gonzalocrs/Amor_Mundi/polyframe2/friend-20-feet-round-dome-lowstart-crown3m-opentop.png

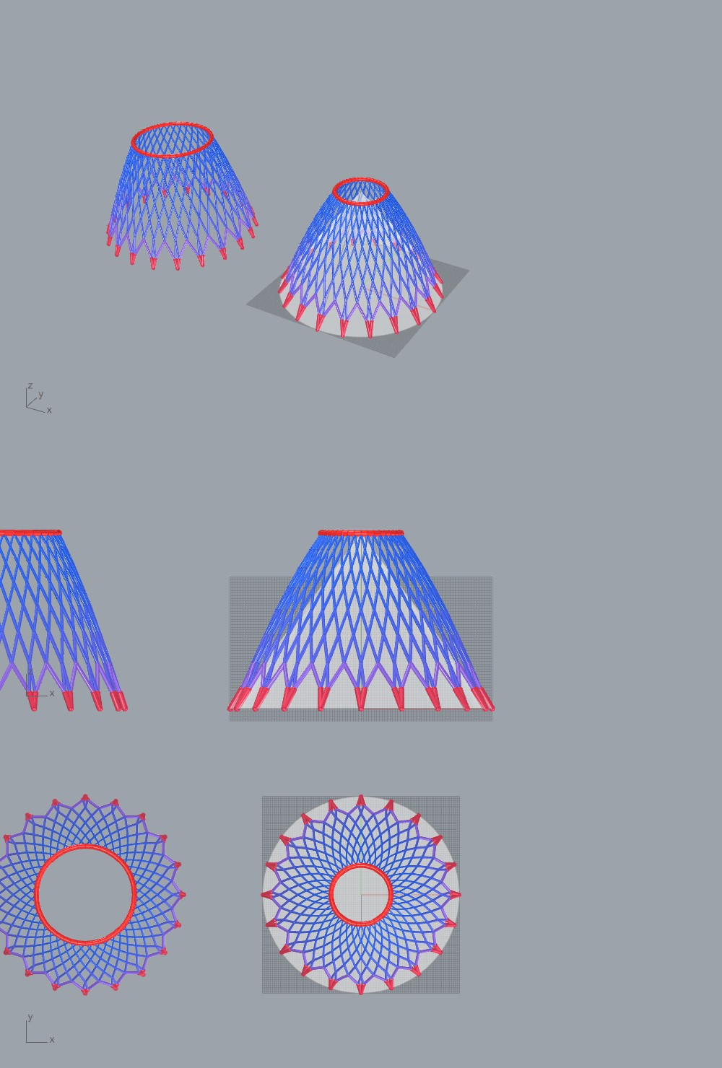
polyframe2/friend-20-feet-round-dome-lowstart-crown3m-opentop.png
