gonzalocrs/Amor_Mundi/details/set/02_2026-10-14_30mm-beads/06-roof-plan-cut-grid-A.pdf

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
al c

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
f, lo

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
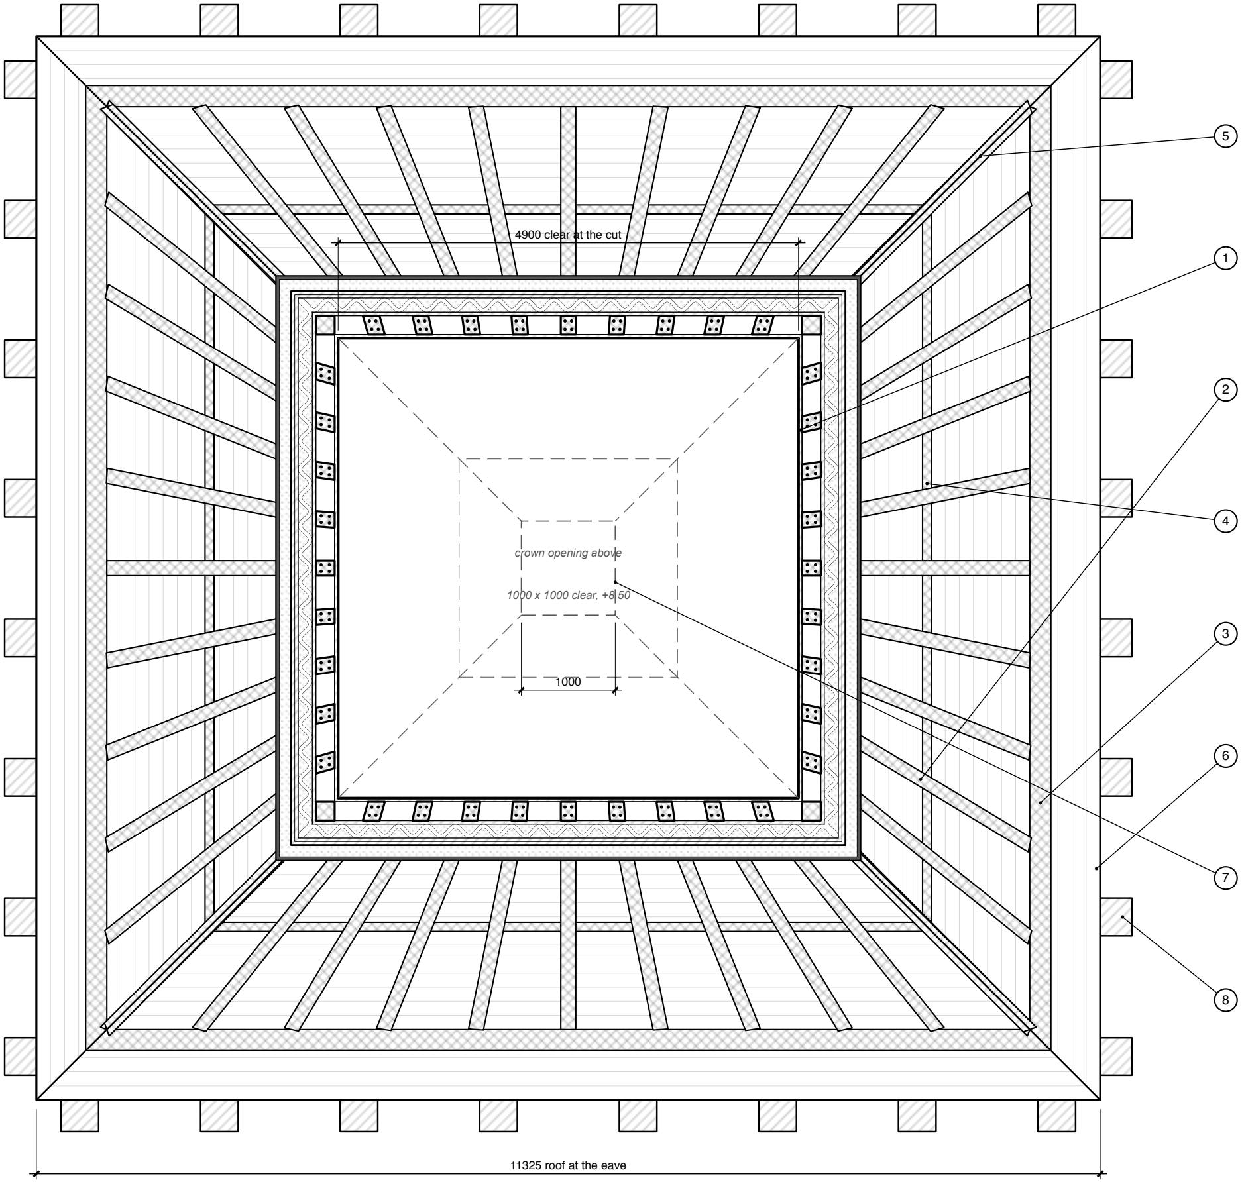
[picture p11: figure]
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
e, j

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
al rib

a

t

+

6.0

2

), r

o

o

m

sid

e

o

u

t: in

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
0, rib

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
h; e

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
), mid

dle

b

e

a

d

3

0, lattice zone 120 (wavy bead + insulation, dotted), 2 outer beads 30, insulation 100 and outer layer 30. 2 | Ribs of grid A seen below the cut: all 11 columns per face run from the base ring at the eave up to the cut (every other one stops at +6.02, just above it). 3 | Base ring: the 300 solid base at the eave (+2.50 to +2.80). 4 | Horizontal rib of grid A at +4.26 (the next ones, at +6.02 and +7.68, are above the cut). 5 | Hips: ribs from the corners of the eave up to the cut; dashed above it, up to the crown opening. 6 | Roof edge at the eave (outside of the 30 outer layer). Very faint squares = printed layer joints (real layers 10, drawn every 200 in height). 7 | Above the cut (removed, dashed): hips and the crow

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
0, 1

0

0

0

cle

a

r in

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
xis, 2

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
r la

y

e

r

). 8 Buttresses below the roof: their end s

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
e; t

h

e

w

all u

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
f is

d

a

s

h

e

d. Notes Matches the roof-grid elevations: same rib geometry, s

a

m

e levels (+4.26, +6.02, +7.68 for the horizontal ribs of grid A). The ribs lie in the rib zone of the shell, between the inner and the middle bead; here they are drawn as if the middle bead, the lattice zone, the outer beads, insulation and cladding were transparent. 0 | 1 | 2 | 3

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
3 · dim

e

n

sio

n

s in

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
4 · h

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
s, n

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
