gonzalocrs/Amor_Mundi/details/set/02_2026-10-14_30mm-beads/10-detail-D1-eave.pdf

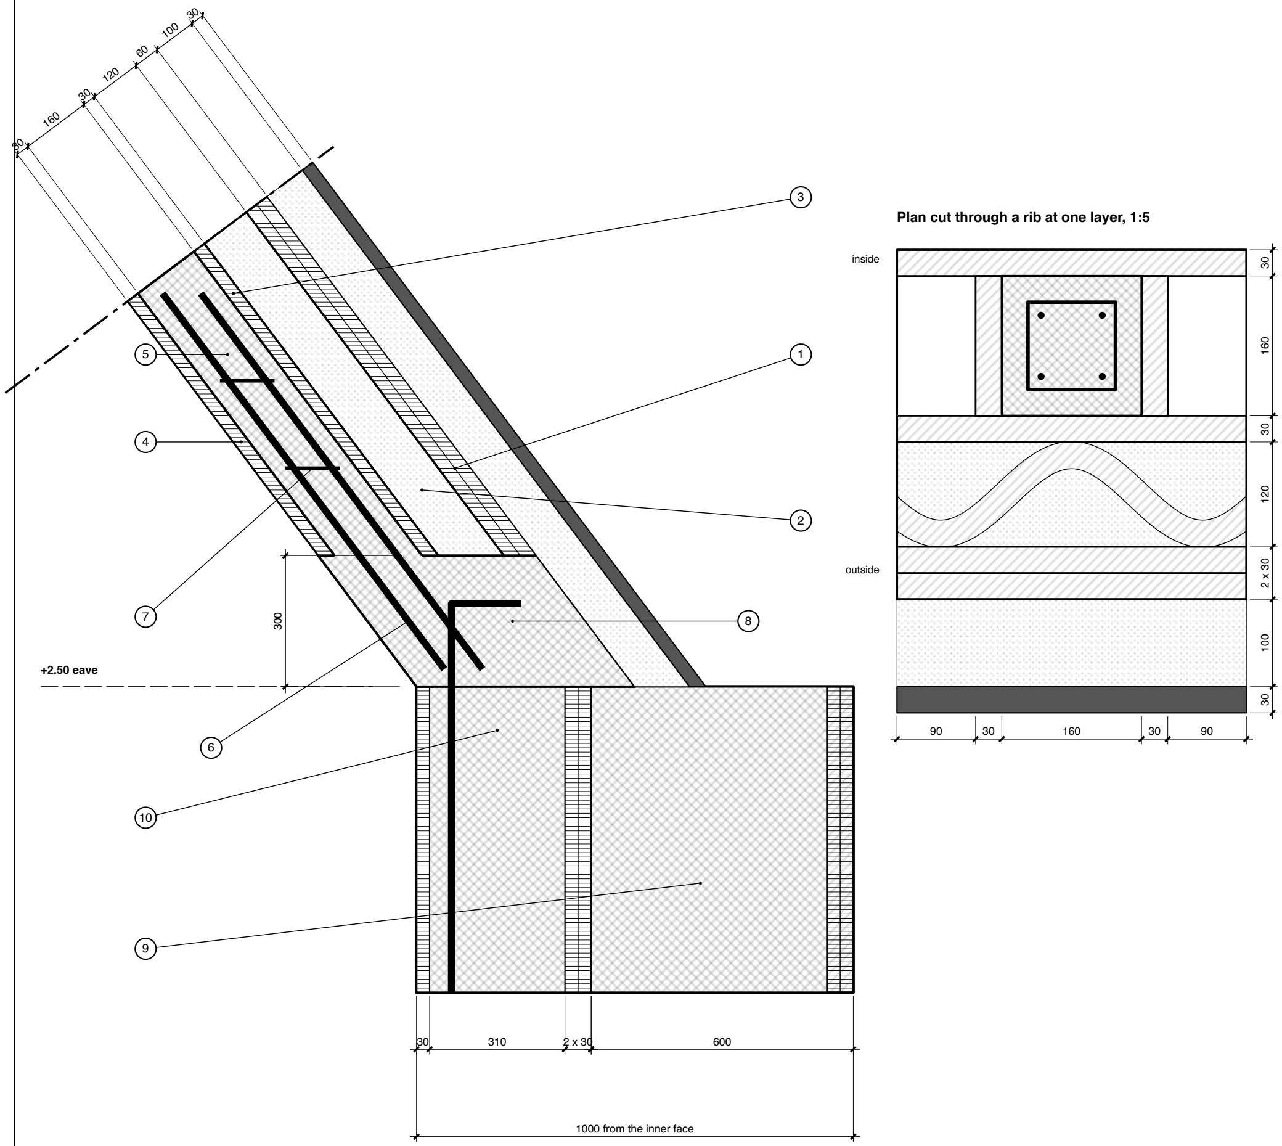
[picture p15: figure]
sid; e inside

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
0, t

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
e; outside them the insulation 100 (dotted) and the outer layer 30 (dark). 2 Lattice zone 120: a wavy printed bead 30 that touches the middle bead and the outer beads in tu

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
0, a

s

s

u

m

e

d

), in

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
n it

s loops (dotted). 3 | Middle bead 30: closes the rib zone on the outside. Inner and middle bead are the two structural skins of the roof, the ribs the webs between them (as in the Karamba model). 4 | Inner bead 30, room side: continuous, it covers the ribs. The roof is 400 thick square to the slope from eave to crown. 5 | Rib (cast column) 160 wide x 160 deep: fills the rib zone between the inner and the middle bead, inside two printed channel walls of 30 (see the plan cut), filled with poured concrete; section cut along the rib. It rises out of the solid base in the same pour, without a joint. Between the ribs the rib zone is an empty cavity. 6 | Rib bars R, 4 Ø16 (2 in the cut), anchored in the solid base where they cross the hooks of the wall bars A (assumed; steel fibre in the concrete could replace them). 7 | Stirrups Ø8 every 200 (assumed). 8 | Solid base of the roof: the first 300 (vertical) above the eave is full cast concrete over the whole 400, no cavity or lattice, poured in one go with the rib above it; wall bars A hook into it. Replaces the ring beam. 9 | Buttress 400 wide, 1000 from the inner face (600 beyond the wall): printed formwork (60 end cap of 2 beads shown) filled with cast concrete; top flush with the roof base at +2.50. 10 Wall 400 at the buttress: printed inner bead 30 and 2 outer beads 30, the 310 zone between them cast a

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
o in

s

ula

tio

n

h

e

r

e, t

h

e
c

u

t is

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
s; b

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
e is

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
+ in

s

ula

tio

n

). W

all b

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
n in

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
p in

t

o

t

h

e
s

olid

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
d in

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
). T

h

e

r

o

o

f
g

rid is

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
); t

h

e
d

e

t

ail is

c

u

t

alo

n

g

a

rib. 0 | 1 | 2 | 3

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
3 · rib

pla

n

c

u

t

1:5 · dim

e

n

sio

n

s in

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
4 · h

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
s, n

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
