gonzalocrs/Amor_Mundi/polyframe2/karamba-19/05 model under load - iteration 19.pdf

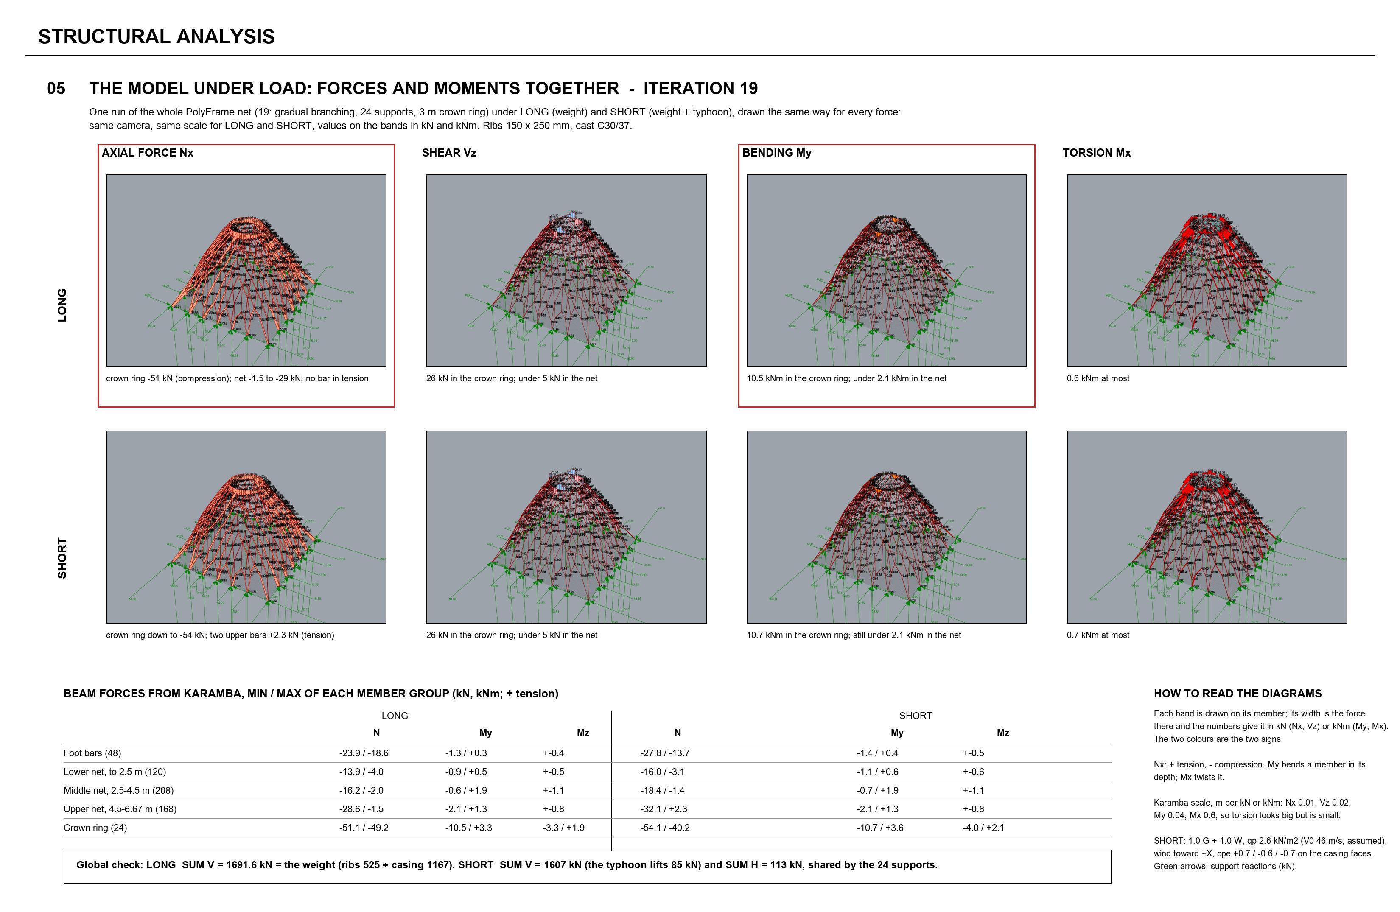
[picture p26: page 1]
