gonzalocrs/Amor_Mundi/polyframe2/karamba-19/13 comparison midterm frame vs net 19.pdf

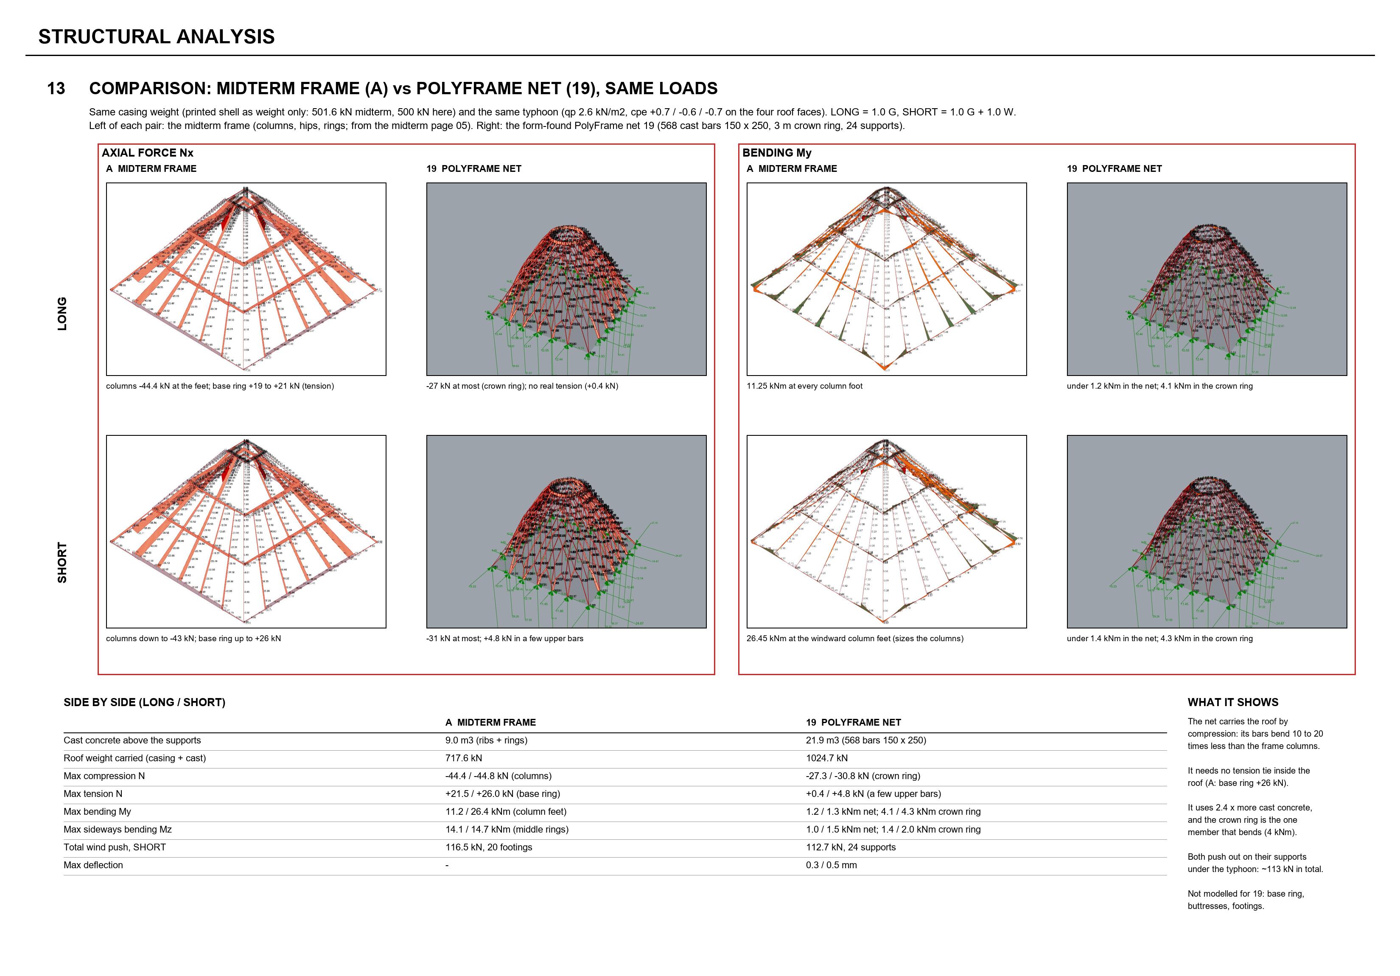
[picture p27: page 1]
