gonzalocrs/Amor_Mundi/archive/2026-10-14-before-drawing-set/README.md

# Archive: drawings before the drawing set (2026-10-14)

Outdated drawings, kept for reference only. They do NOT match the current design.
The current drawings are in `details/set/` (PDFs, one merged set PDF, and editable DXFs in `details/set/cad/`).

- `details/`: the per-drawing PDFs / SVGs / DXFs made before the set (old names: pyramid-plan, pyramid-section, roof-grid, roof-slice, ...),
  Gonzalo's `pyramid-detail-11x17.pdf` and `cad/pyramid-detail.dwg` (earlier version of detail D1).
- `older-eave-section/`: the first 1:10 eave section draft.
