gonzalocrs/Amor_Mundi/form-finding/branching-variants.png

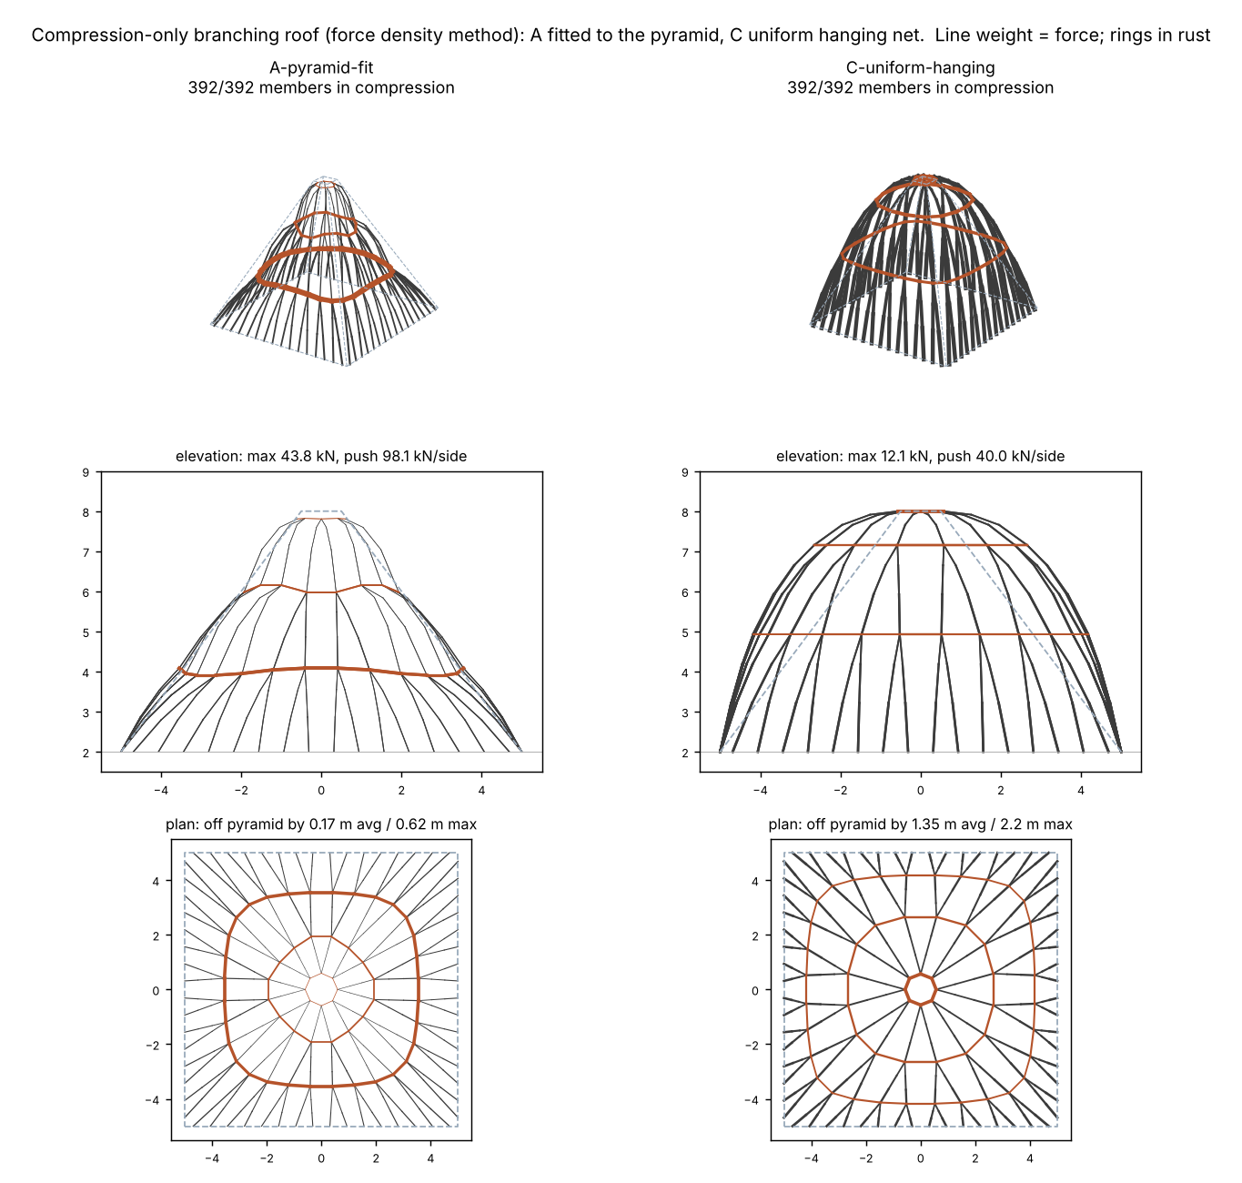
form-finding/branching-variants.png
