gonzalocrs/Amor_Mundi/polyframe2/fig1-hourglass.png

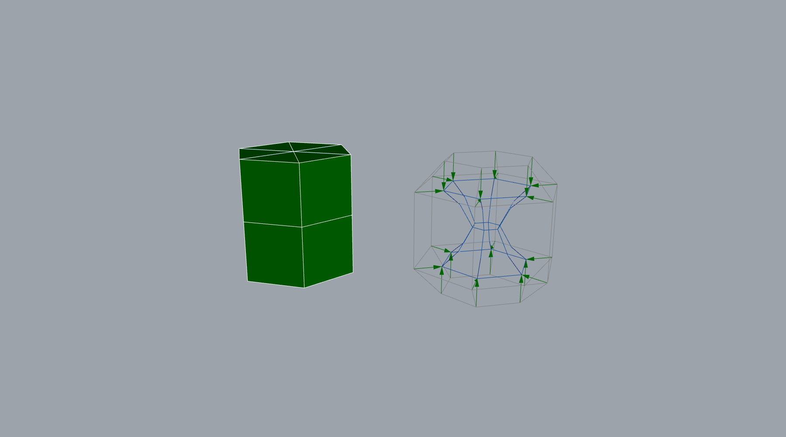
polyframe2/fig1-hourglass.png
