gonzalocrs/Amor_Mundi/polyframe2/fig1-progress.png

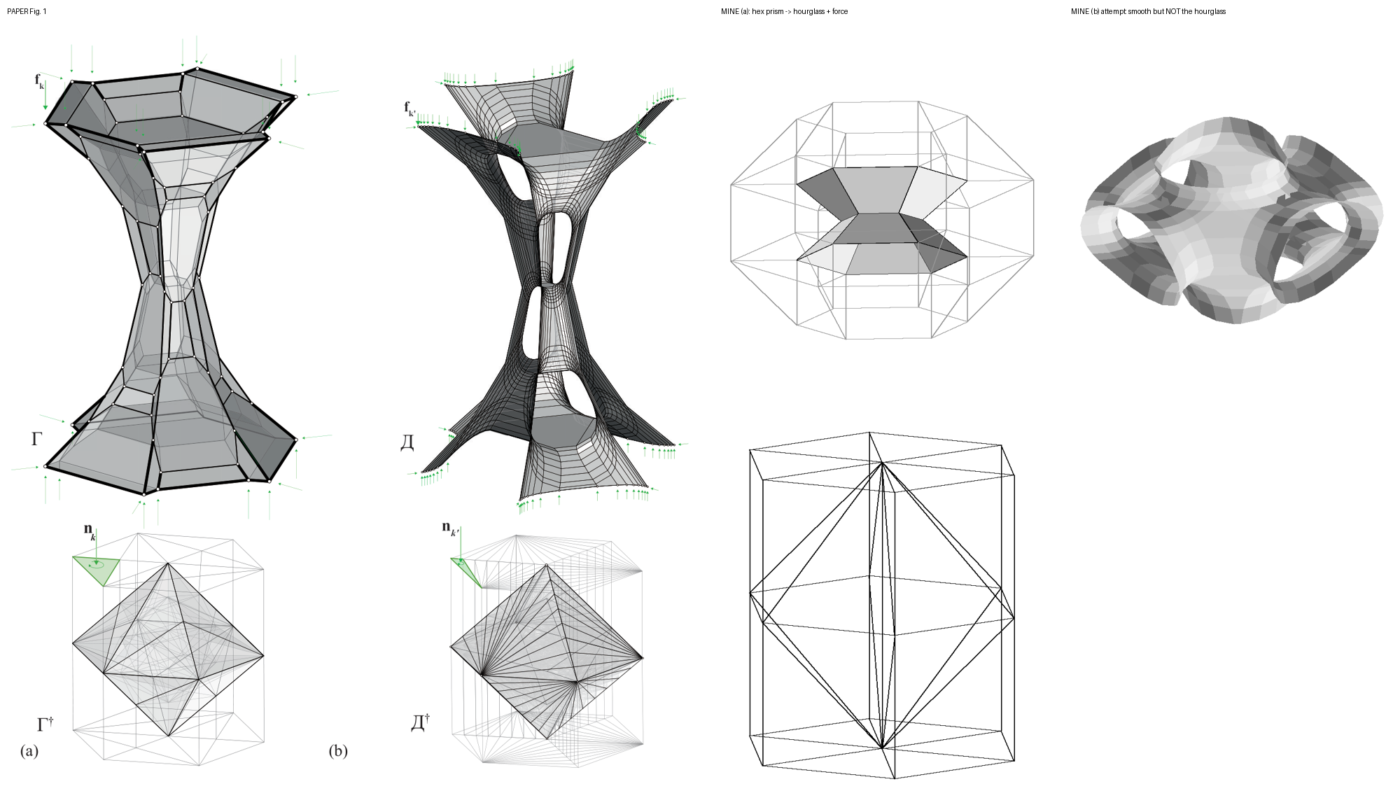
polyframe2/fig1-progress.png
