gonzalocrs/Amor_Mundi/polyframe2/friend-12-feet-2m-corners-opentop.png

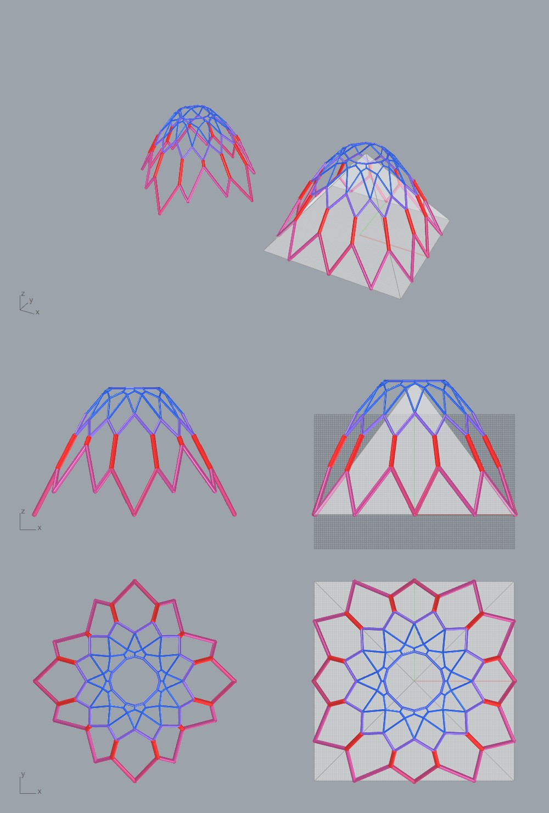
polyframe2/friend-12-feet-2m-corners-opentop.png
