gonzalocrs/Amor_Mundi/polyframe2/friend-15-pyramid-branches-atbase.png

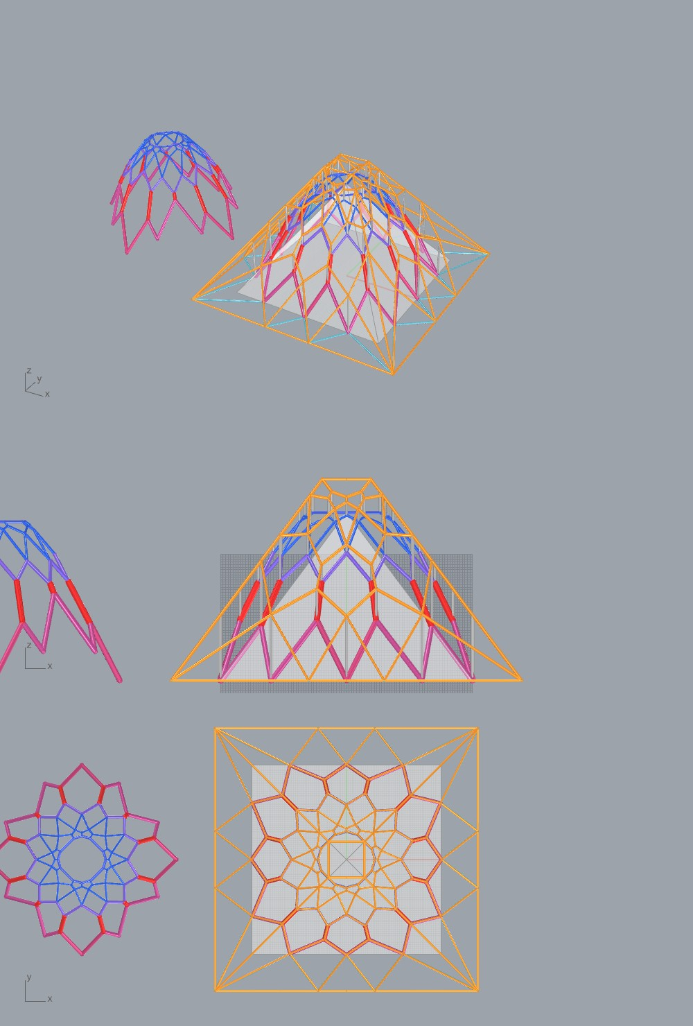
polyframe2/friend-15-pyramid-branches-atbase.png
