gonzalocrs/Amor_Mundi/polyframe2/friend-15-pyramid-skin.png

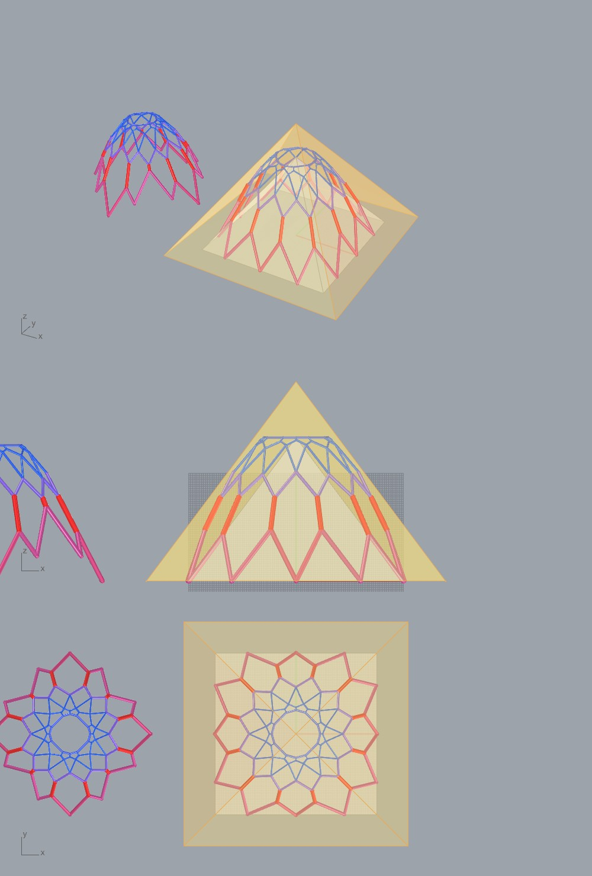
polyframe2/friend-15-pyramid-skin.png
