gonzalocrs/Amor_Mundi/polyframe2/friend-16-diagrid-canvas.png

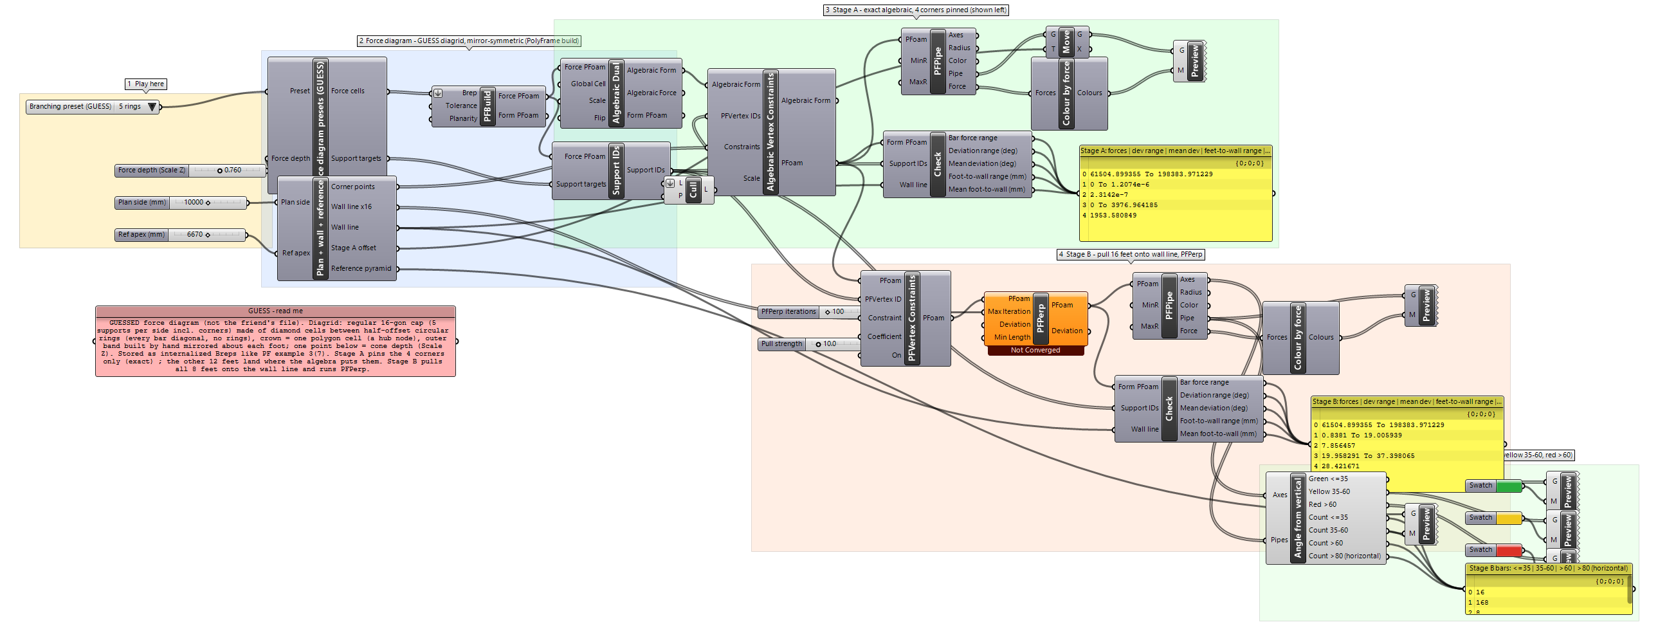
polyframe2/friend-16-diagrid-canvas.png
