gonzalocrs/Amor_Mundi/polyframe2/friend-16-diagrid-evenload-opentop.png

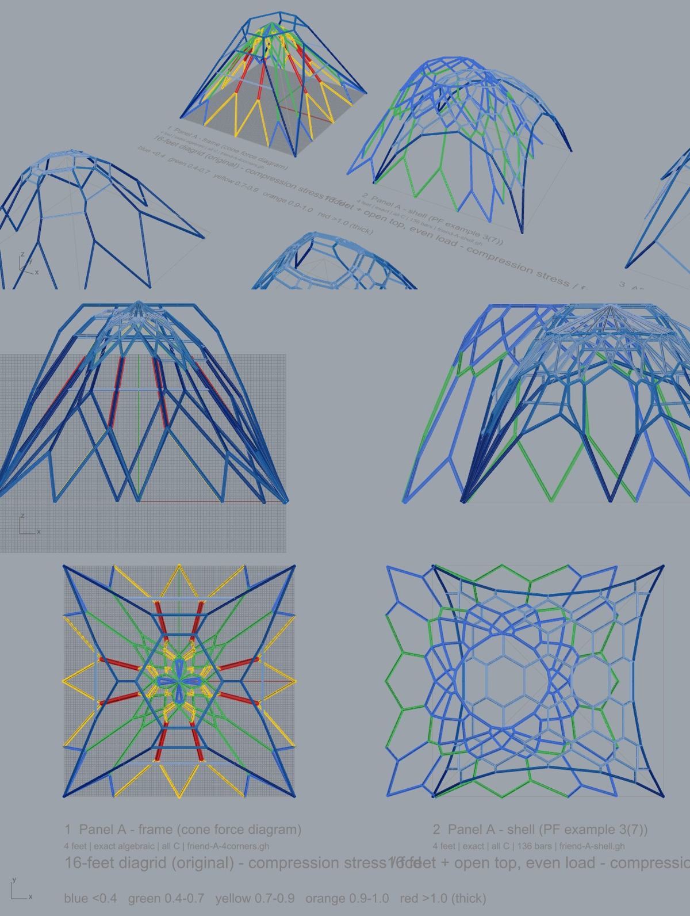
polyframe2/friend-16-diagrid-evenload-opentop.png
