gonzalocrs/Amor_Mundi/polyframe2/friend-16-diagrid.png

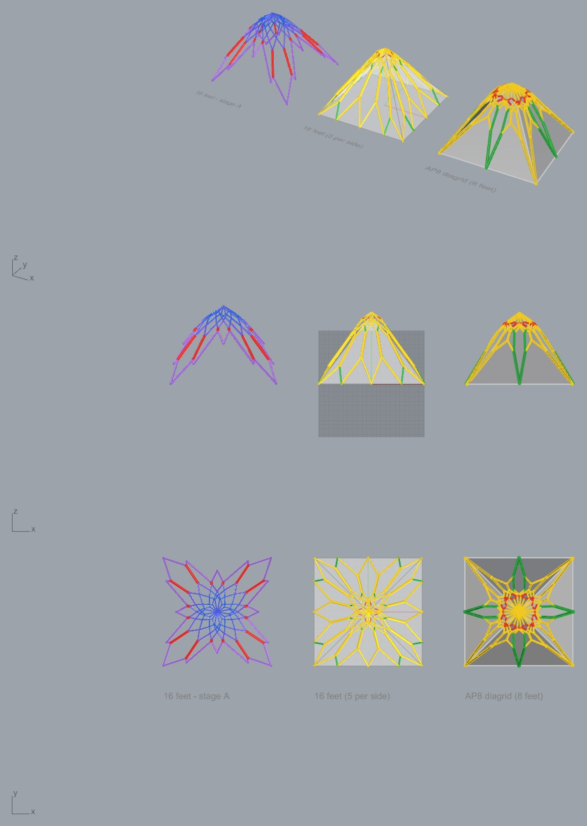
polyframe2/friend-16-diagrid.png
