gonzalocrs/Amor_Mundi/polyframe2/friend-16-pyramid-skin.png

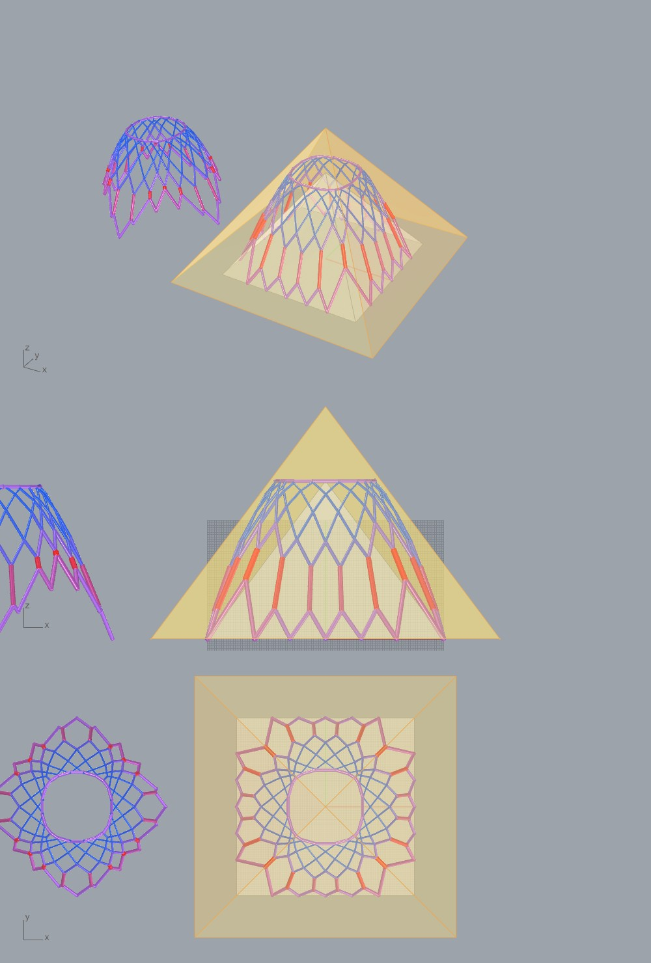
polyframe2/friend-16-pyramid-skin.png
