gonzalocrs/Amor_Mundi/polyframe2/friend-20-feet-2m-corners-opentop.png

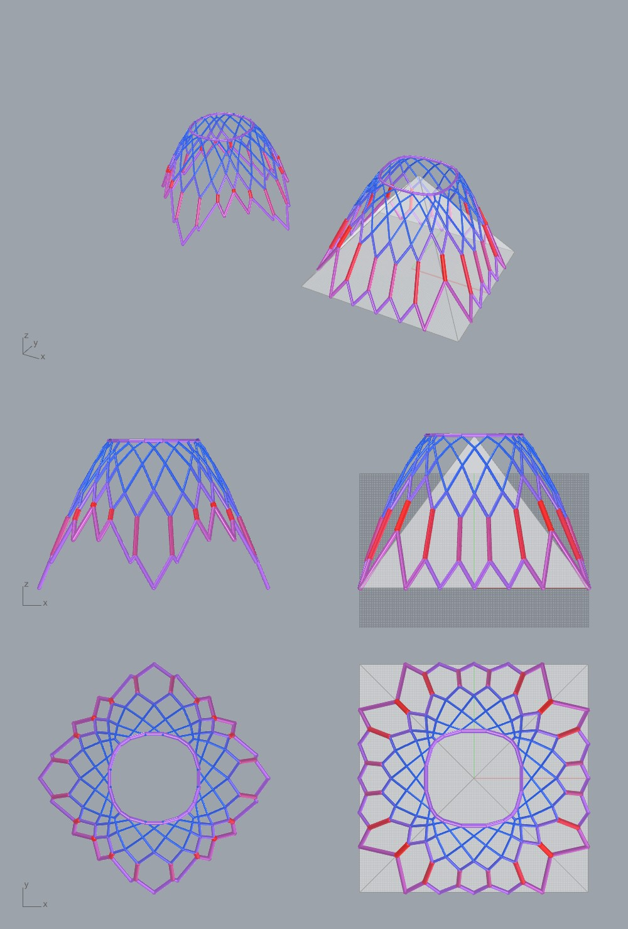
polyframe2/friend-20-feet-2m-corners-opentop.png
