gonzalocrs/Amor_Mundi/polyframe2/friend-20-feet-graded-c5-crown3m-opentop.png

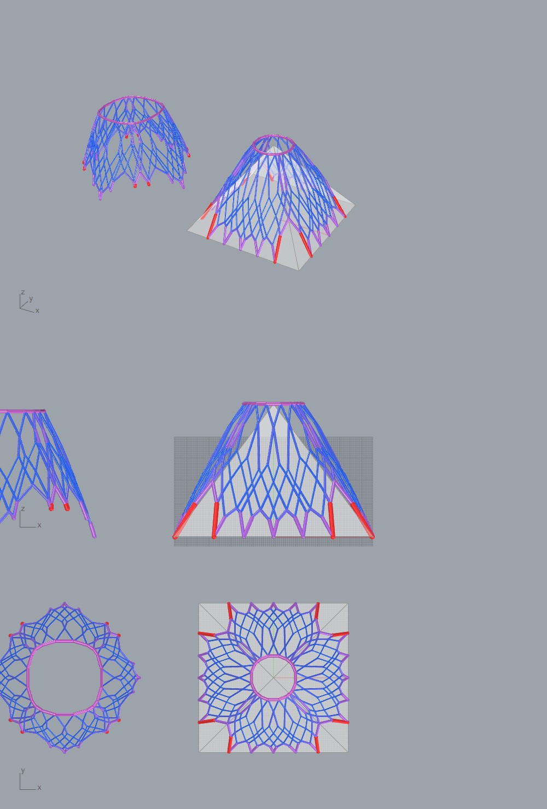
polyframe2/friend-20-feet-graded-c5-crown3m-opentop.png
