gonzalocrs/Amor_Mundi/polyframe2/friend-20-feet-graded-gradual-crown3m-opentop.png

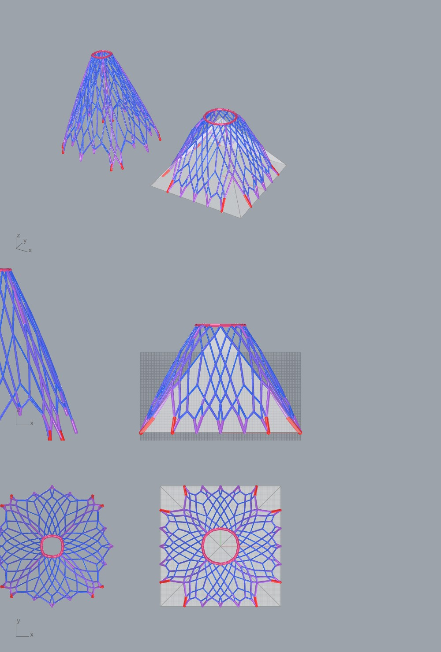
polyframe2/friend-20-feet-graded-gradual-crown3m-opentop.png
