gonzalocrs/Amor_Mundi/polyframe2/friend-20-feet-nervi-circle-opentop.png

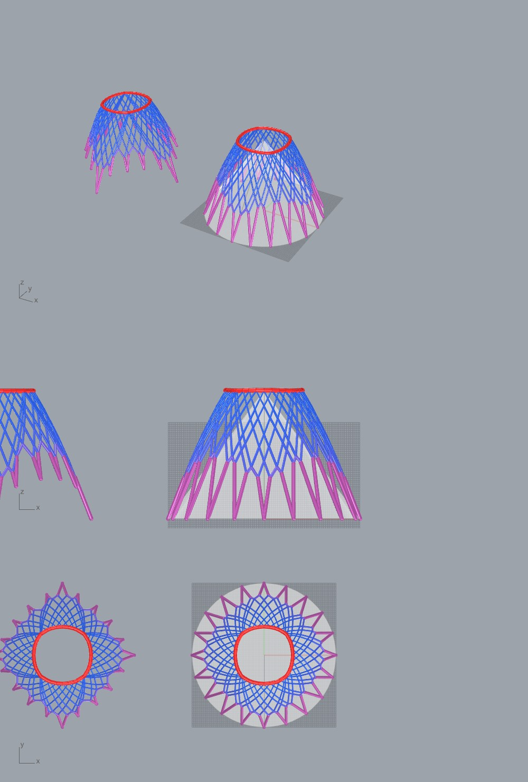
polyframe2/friend-20-feet-nervi-circle-opentop.png
