gonzalocrs/Amor_Mundi/polyframe2/friend-20-feet-nervi-regular-opentop.png

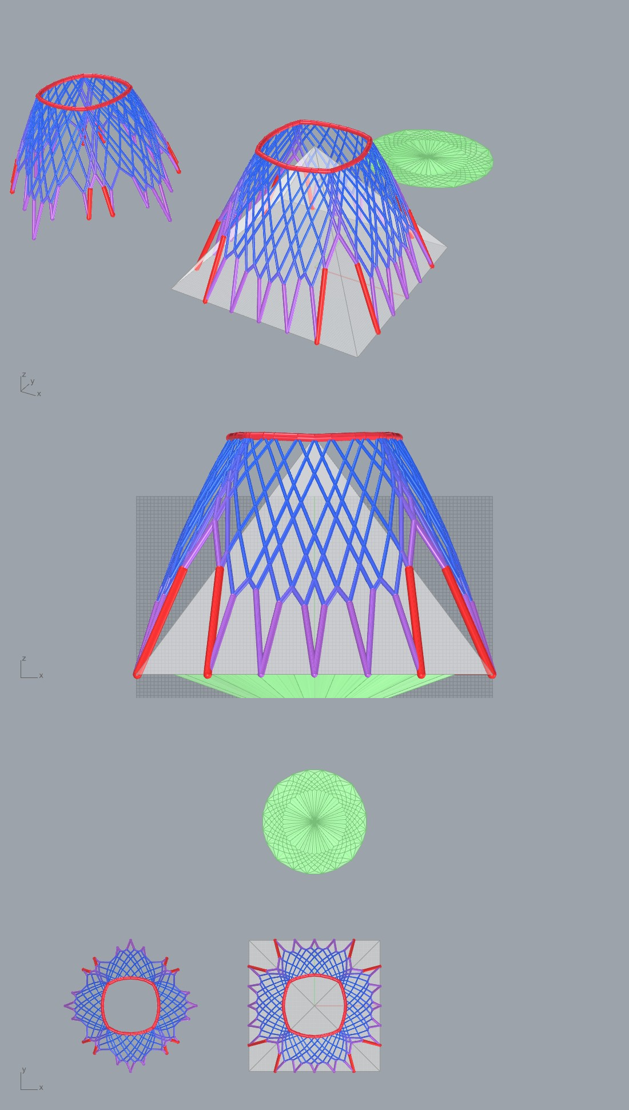
polyframe2/friend-20-feet-nervi-regular-opentop.png
