gonzalocrs/Amor_Mundi/polyframe2/friend-20-feet-nervi-square-roundcrown-opentop.png

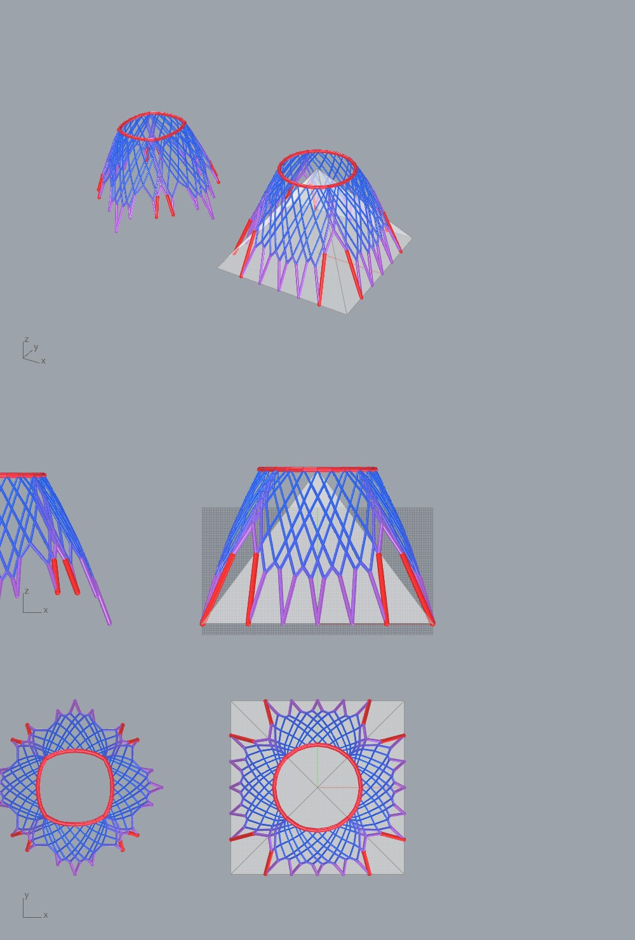
polyframe2/friend-20-feet-nervi-square-roundcrown-opentop.png
