gonzalocrs/Amor_Mundi/polyframe2/friend-20-feet-paraboloid-opentop.png

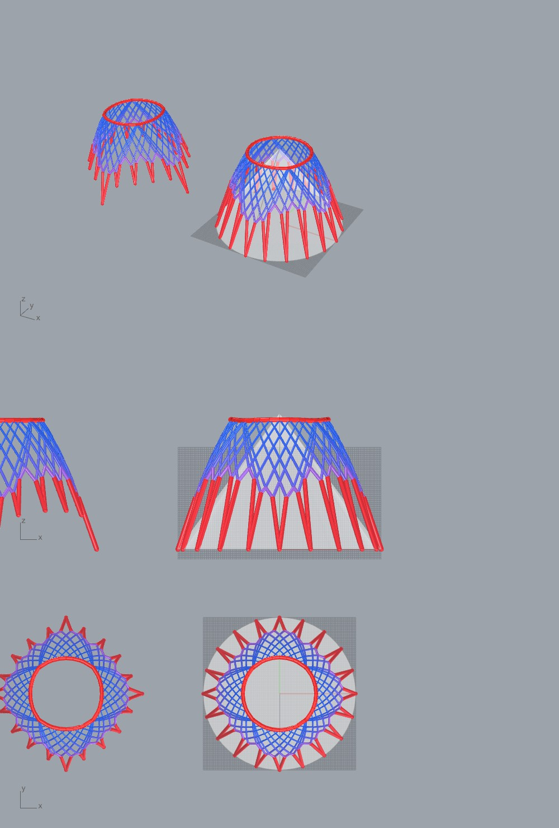
polyframe2/friend-20-feet-paraboloid-opentop.png
