gonzalocrs/Amor_Mundi/polyframe2/friend-20-feet-spherecap-opentop.png

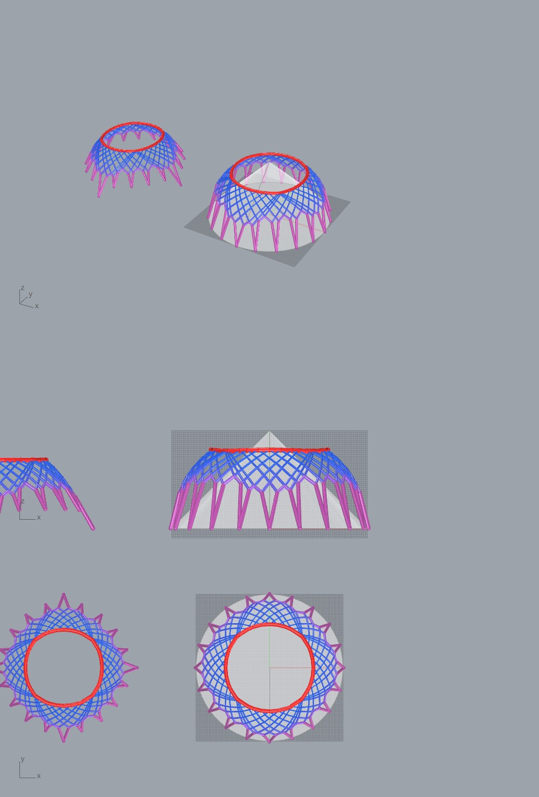
polyframe2/friend-20-feet-spherecap-opentop.png
