gonzalocrs/Amor_Mundi/polyframe2/friend-24-feet-corners-graded-gradual-crown3m-opentop.png

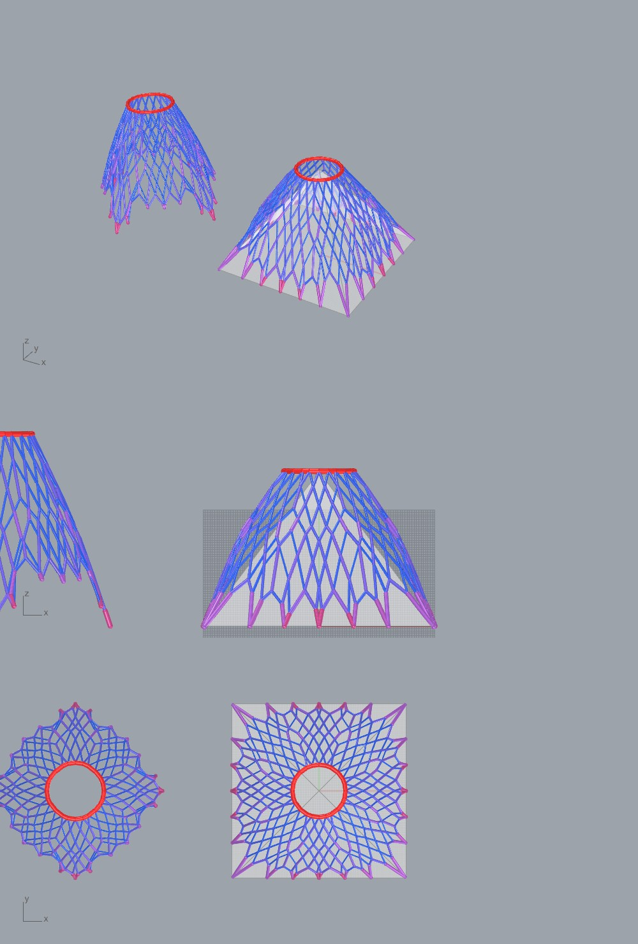
polyframe2/friend-24-feet-corners-graded-gradual-crown3m-opentop.png
