gonzalocrs/Amor_Mundi/polyframe2/friend-24-feet-nervi-square-corners-roundcrown-opentop.png

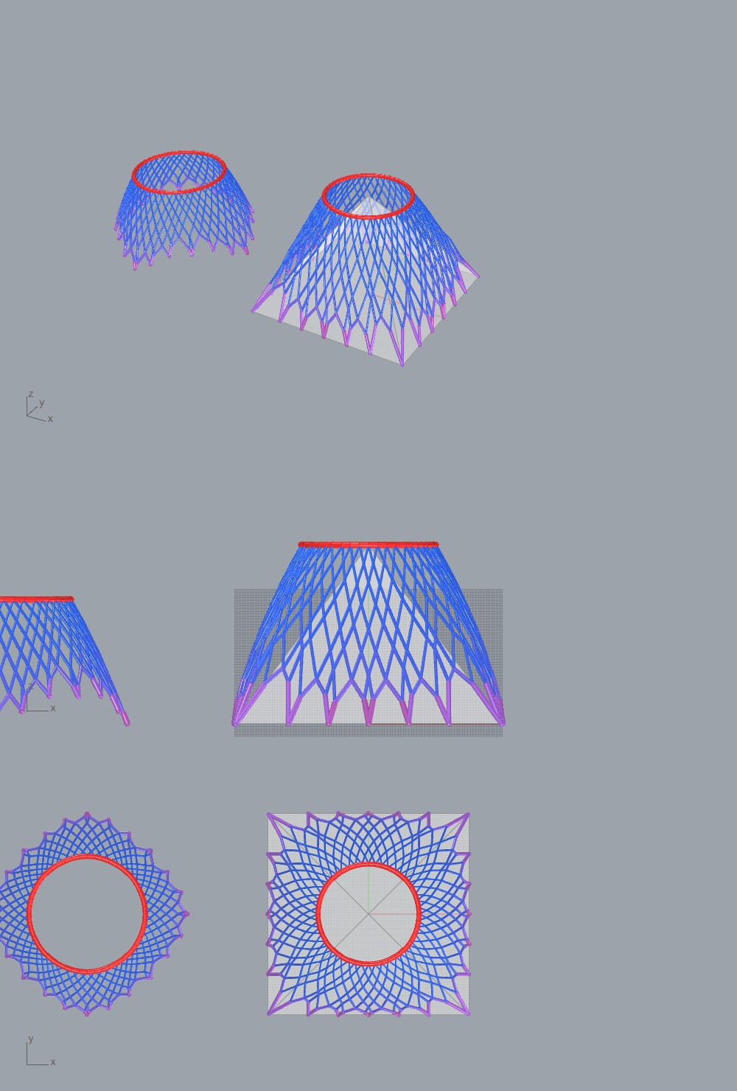
polyframe2/friend-24-feet-nervi-square-corners-roundcrown-opentop.png
