gonzalocrs/Amor_Mundi/polyframe2/friend-A-4corners-canvas.png

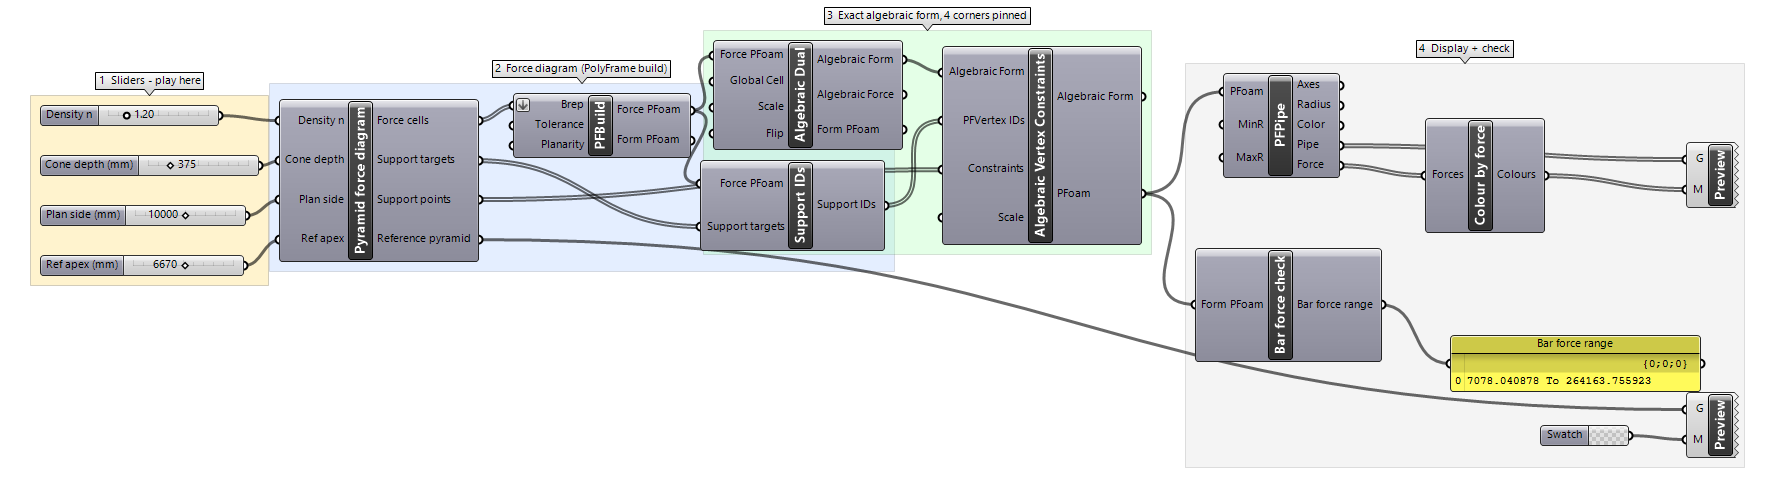
polyframe2/friend-A-4corners-canvas.png
