gonzalocrs/Amor_Mundi/polyframe2/friend-A-4corners.png

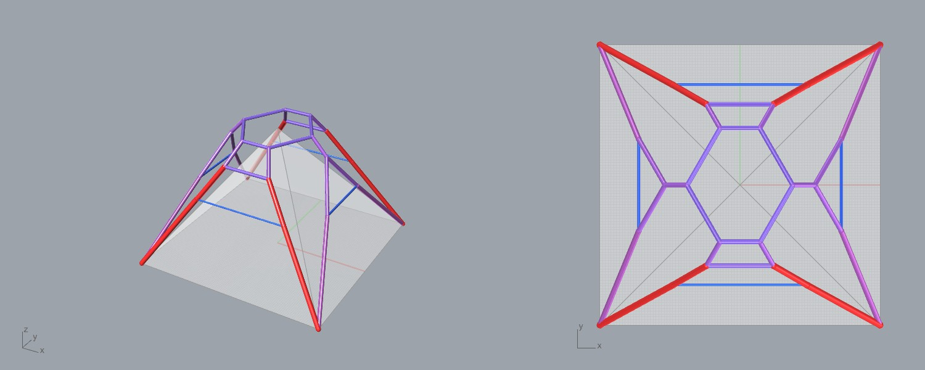
polyframe2/friend-A-4corners.png
