gonzalocrs/Amor_Mundi/polyframe2/friend-A-shell-canvas.png

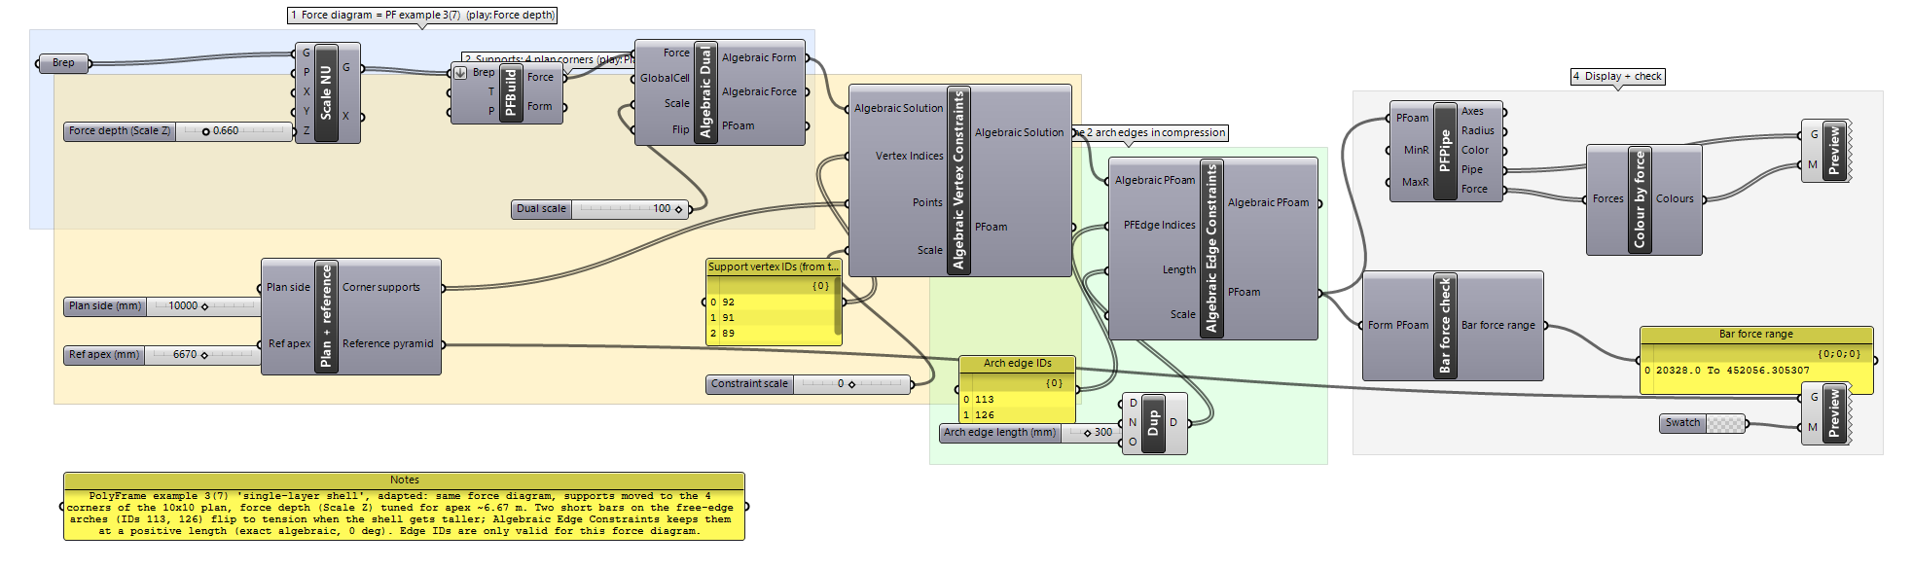
polyframe2/friend-A-shell-canvas.png
