gonzalocrs/Amor_Mundi/polyframe2/friend-A-shell.png

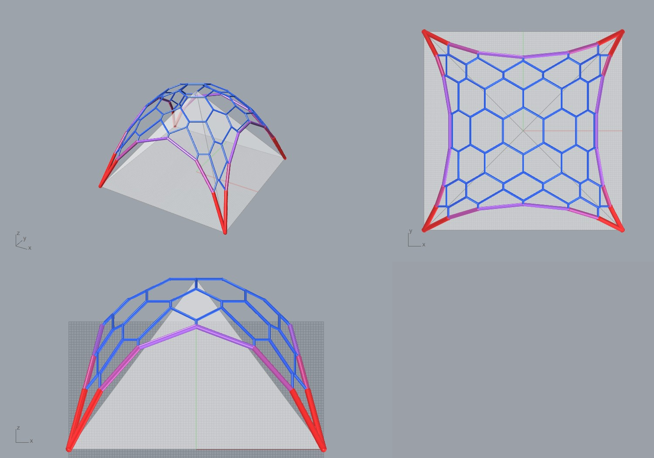
polyframe2/friend-A-shell.png
