gonzalocrs/Amor_Mundi/polyframe2/friend-all-iterations-clean-2026-10-29.png

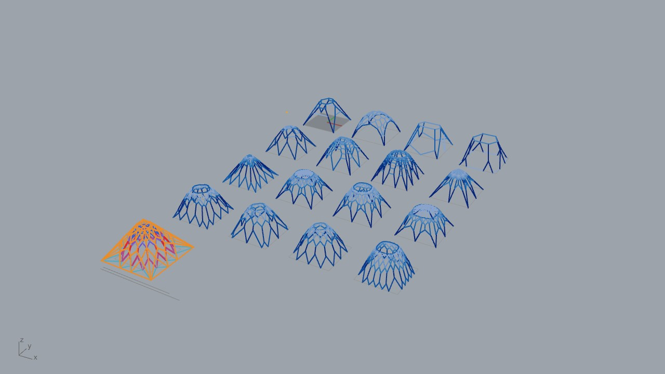
polyframe2/friend-all-iterations-clean-2026-10-29.png
