gonzalocrs/Amor_Mundi/polyframe2/friend-all-models-2026-10-29.png

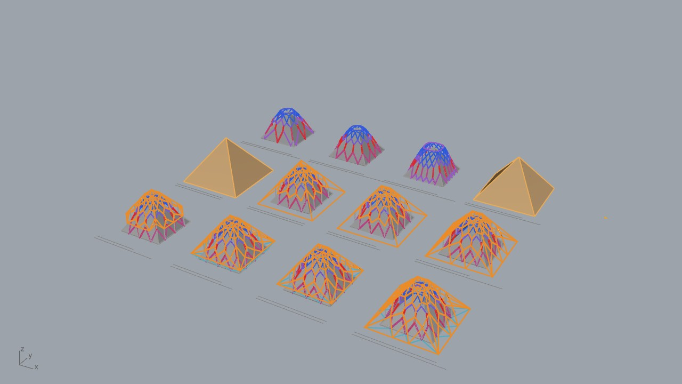
polyframe2/friend-all-models-2026-10-29.png
