gonzalocrs/Amor_Mundi/polyframe2/friend-AP8-canvas.png

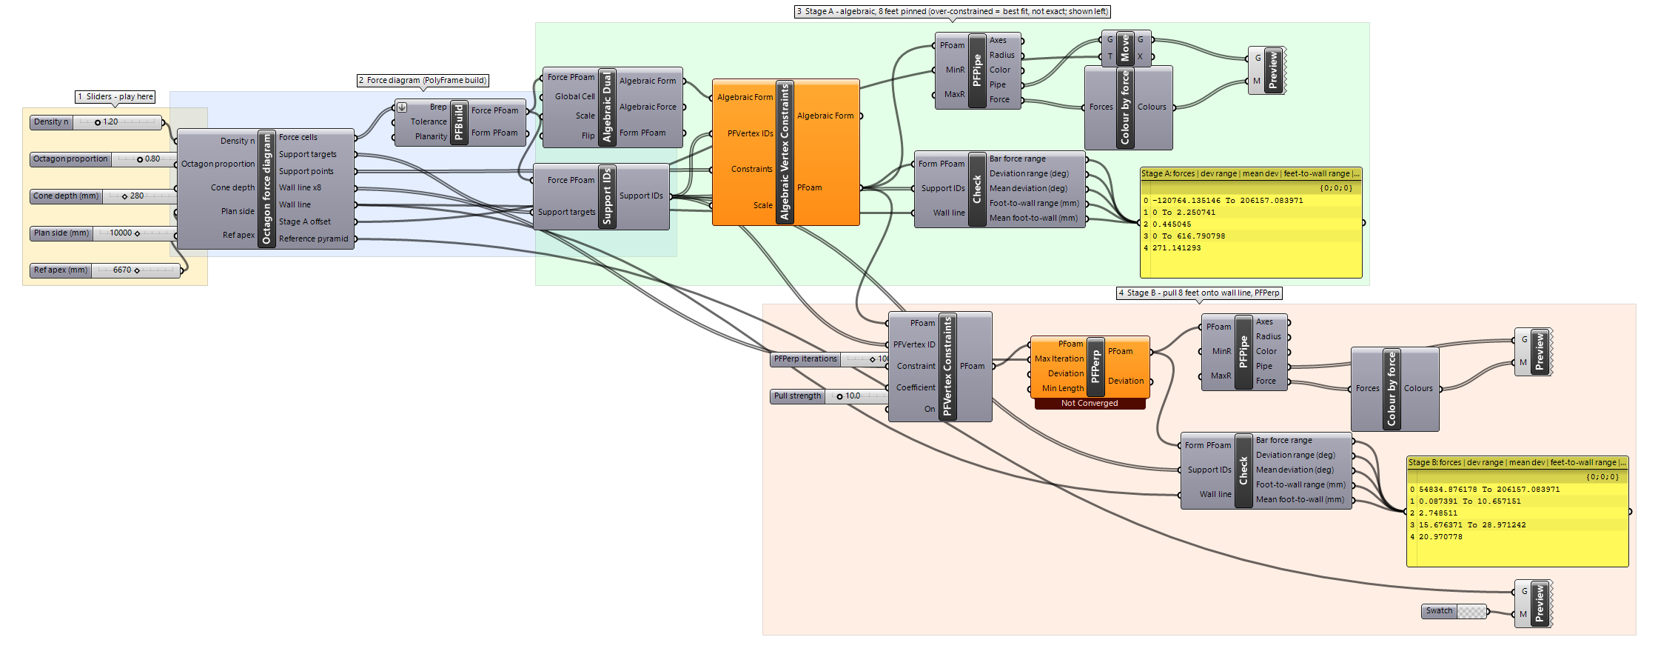
polyframe2/friend-AP8-canvas.png
