gonzalocrs/Amor_Mundi/polyframe2/friend-AP8-diagrid-evenload-4ring.png

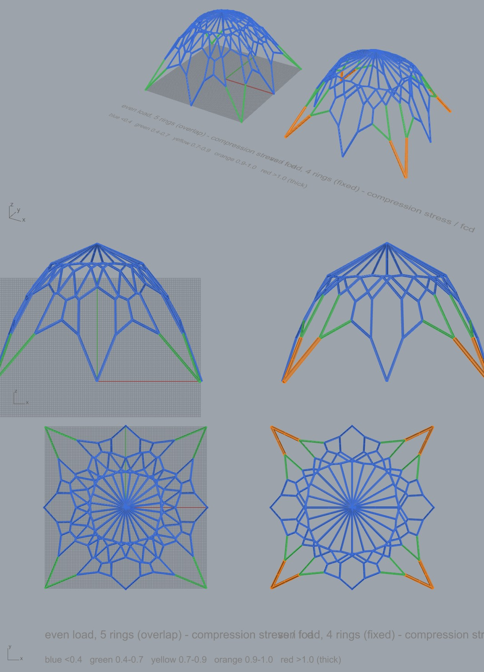
polyframe2/friend-AP8-diagrid-evenload-4ring.png
