gonzalocrs/Amor_Mundi/polyframe2/friend-AP8-diagrid-evenload-karamba.png

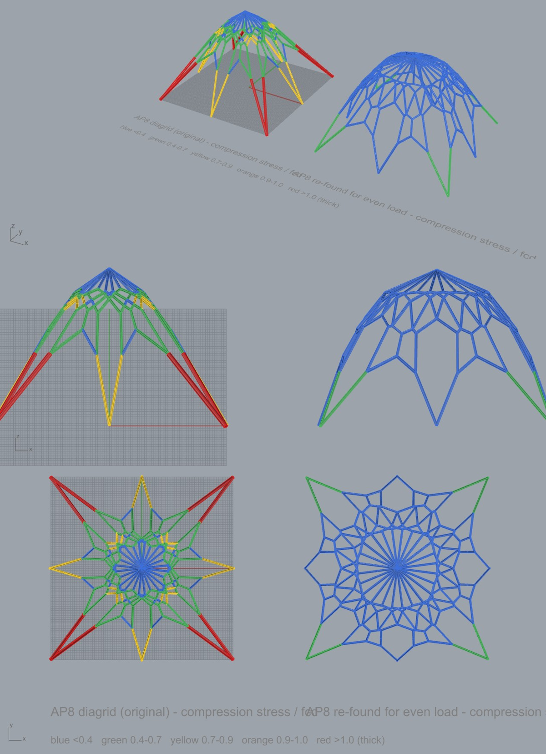
polyframe2/friend-AP8-diagrid-evenload-karamba.png
