gonzalocrs/Amor_Mundi/polyframe2/friend-AP8-diagrid-evenload-opentop.png

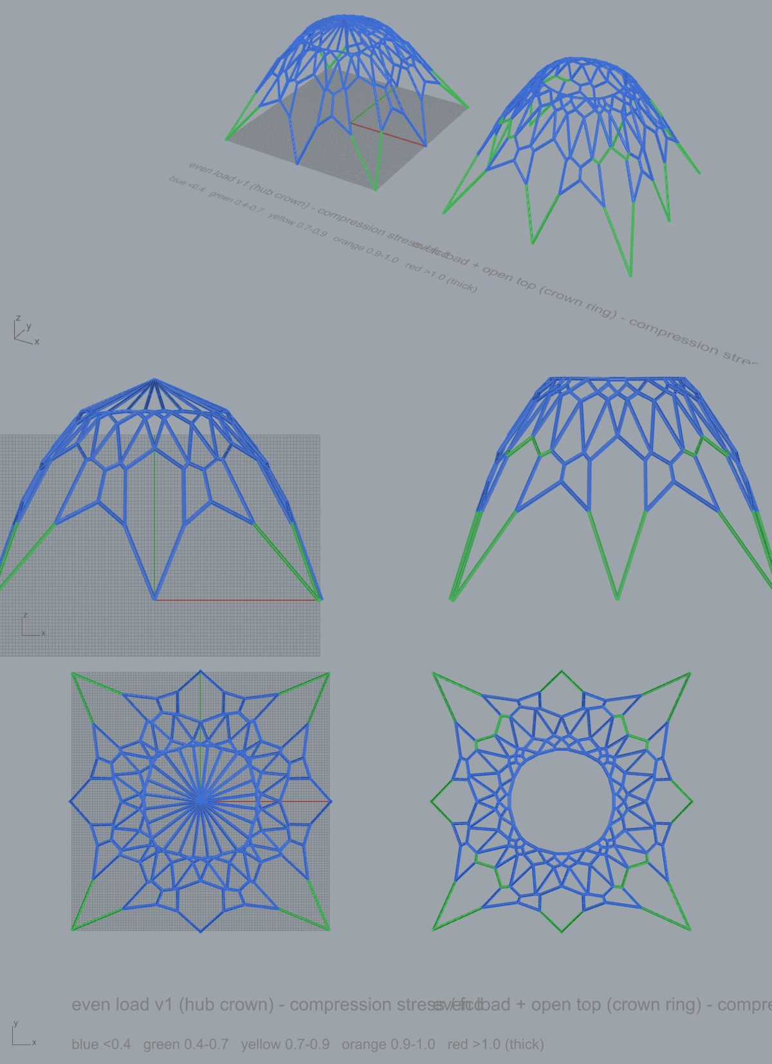
polyframe2/friend-AP8-diagrid-evenload-opentop.png
