gonzalocrs/Amor_Mundi/polyframe2/friend-AP8-diagrid.png

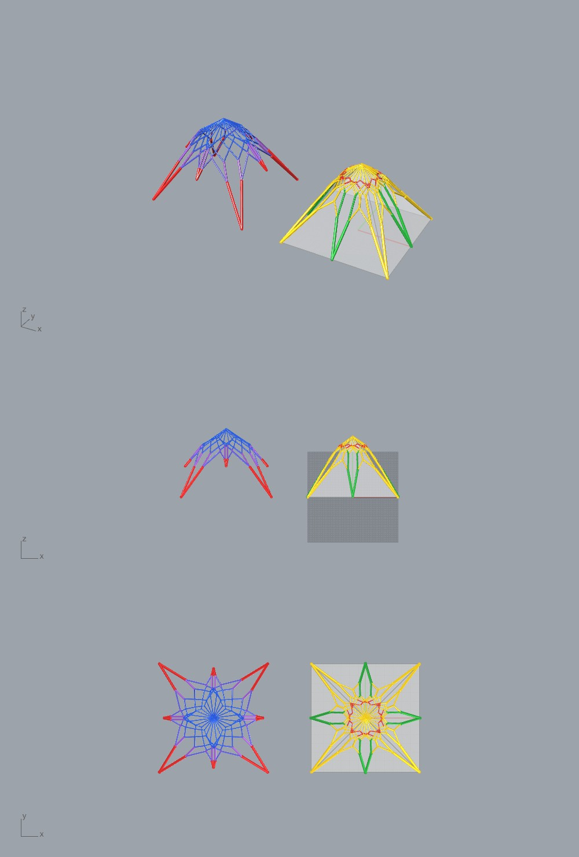
polyframe2/friend-AP8-diagrid.png
