gonzalocrs/Amor_Mundi/polyframe2/friend-AP8-shell-GUESS-canvas.png

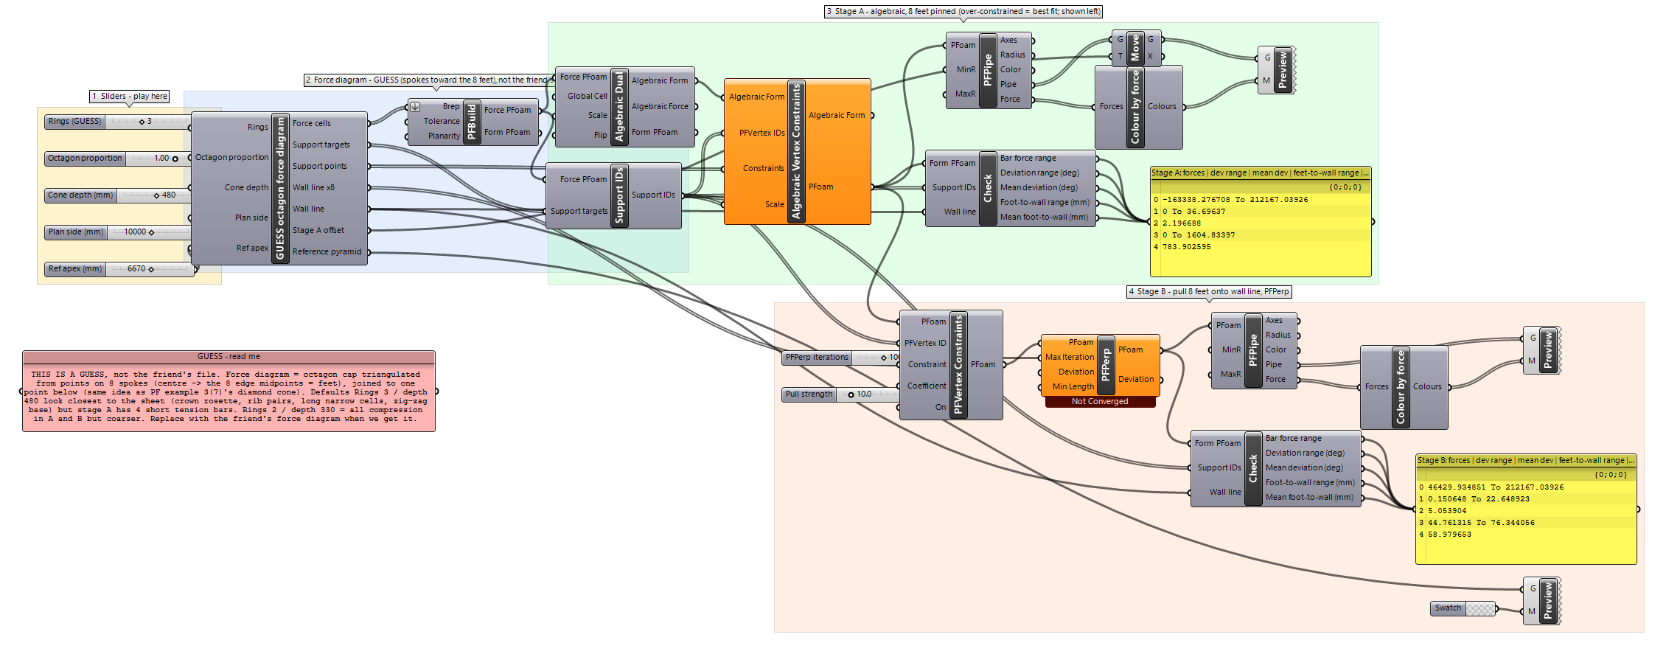
polyframe2/friend-AP8-shell-GUESS-canvas.png
