gonzalocrs/Amor_Mundi/polyframe2/friend-AP8-shell-GUESS.png

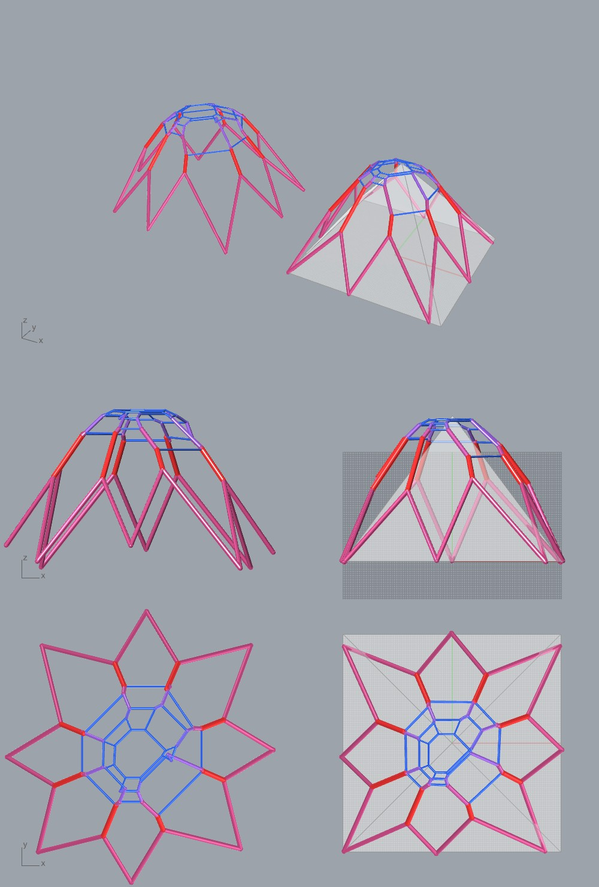
polyframe2/friend-AP8-shell-GUESS.png
