gonzalocrs/Amor_Mundi/polyframe2/friend-AP8-shell-v2-canvas.png

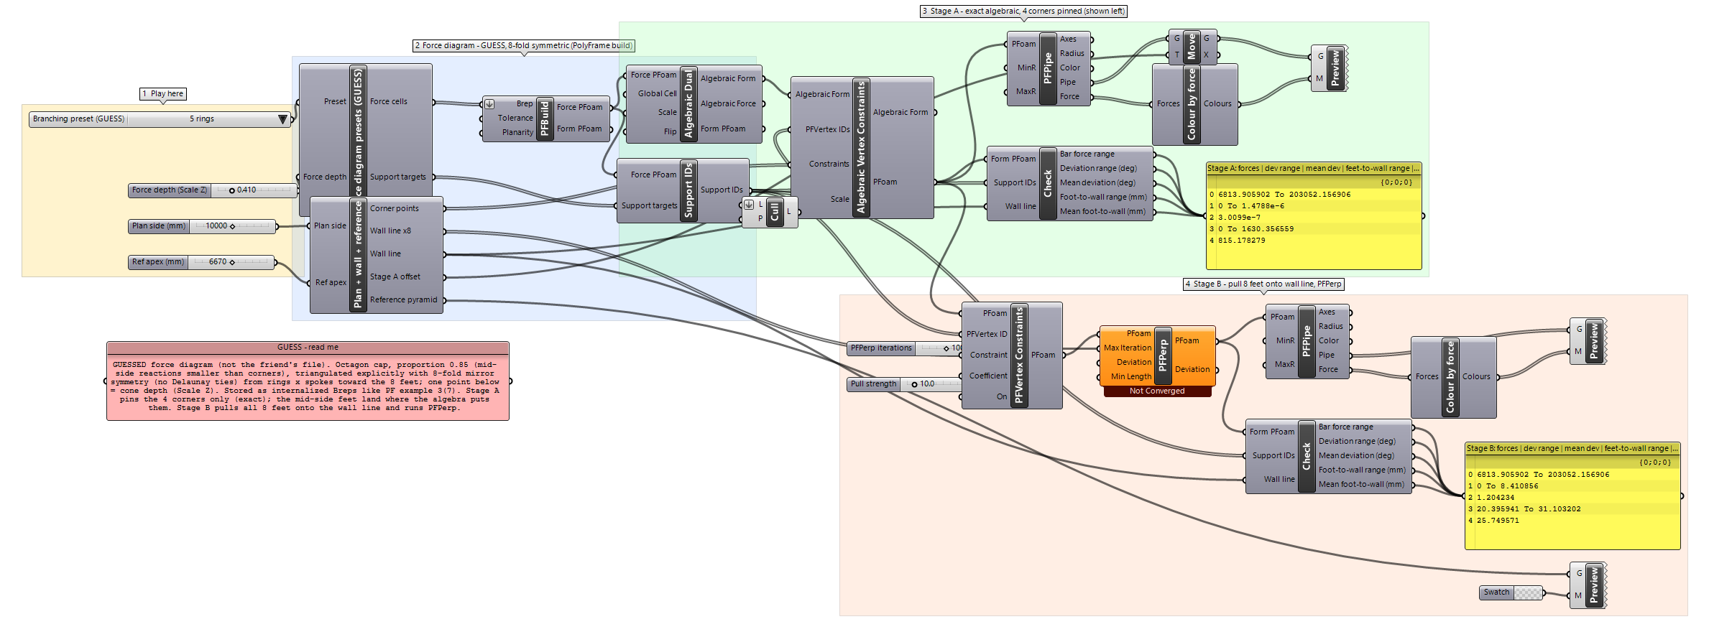
polyframe2/friend-AP8-shell-v2-canvas.png
