gonzalocrs/Amor_Mundi/polyframe2/friend-AP8.png

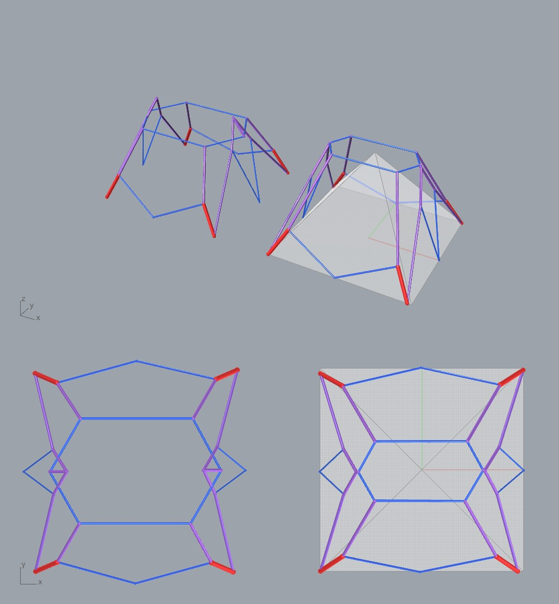
polyframe2/friend-AP8.png
