gonzalocrs/Amor_Mundi/polyframe2/friend-AP12-shell.png

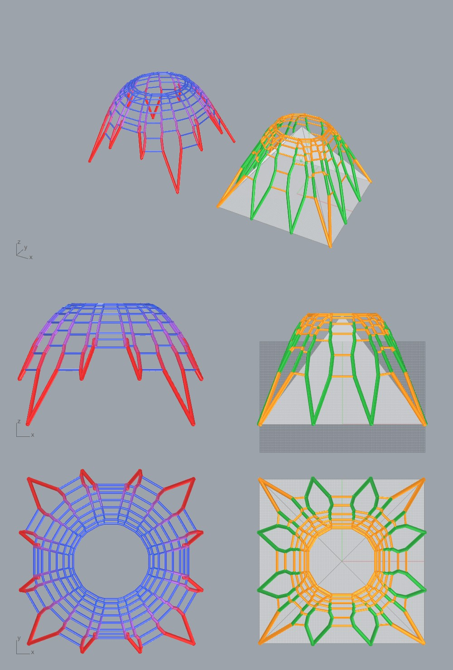
polyframe2/friend-AP12-shell.png
