gonzalocrs/Amor_Mundi/polyframe2/friend-AP12.png

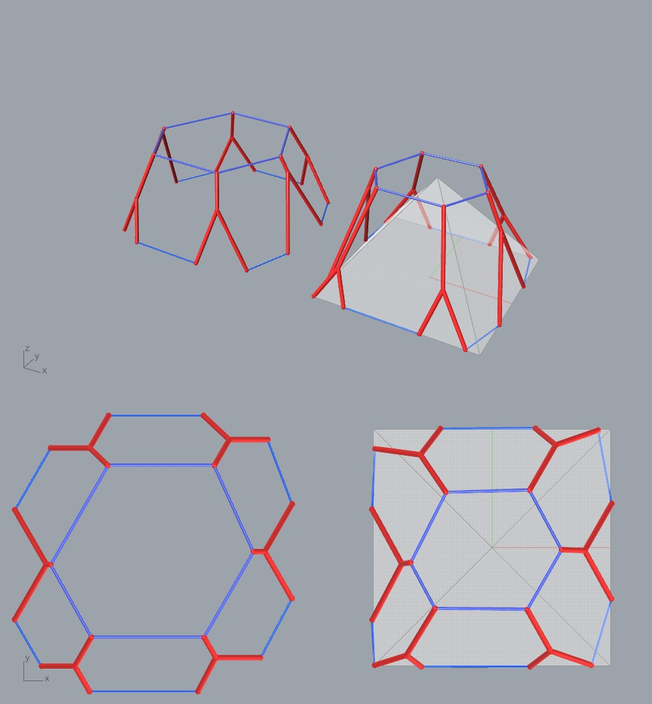
polyframe2/friend-AP12.png
