gonzalocrs/Amor_Mundi/polyframe2/friend-compare-corners-dome-vs-circle-dome.png

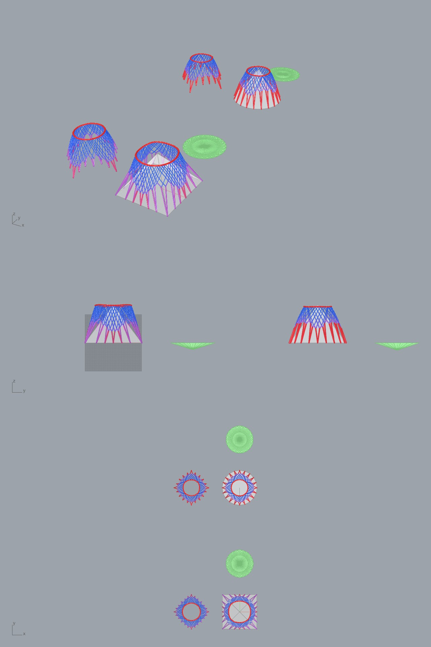
polyframe2/friend-compare-corners-dome-vs-circle-dome.png
