gonzalocrs/Amor_Mundi/polyframe2/friend-diagrid-karamba.png

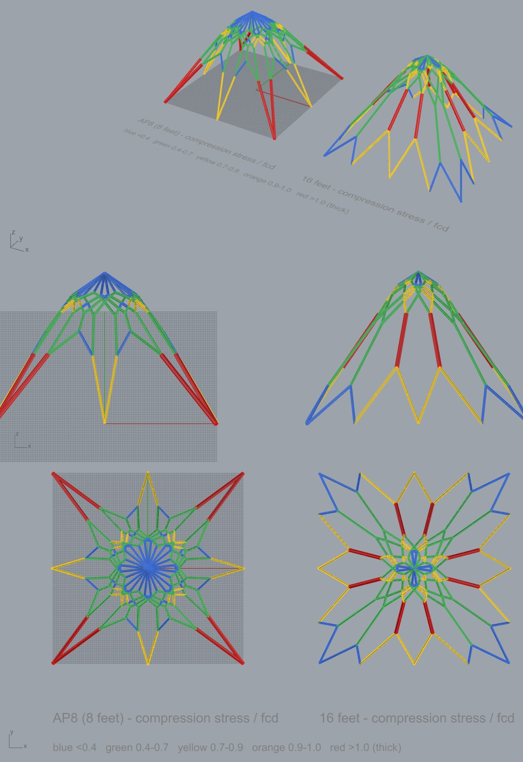
polyframe2/friend-diagrid-karamba.png
