gonzalocrs/Amor_Mundi/polyframe2/friend-models-clean-2026-10-29.png

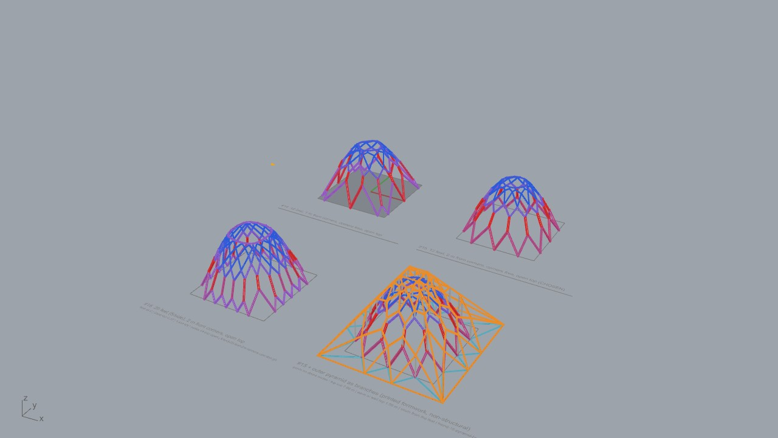
polyframe2/friend-models-clean-2026-10-29.png
