gonzalocrs/Amor_Mundi/polyframe2/friend-square-4-corner-supports-opentop.png

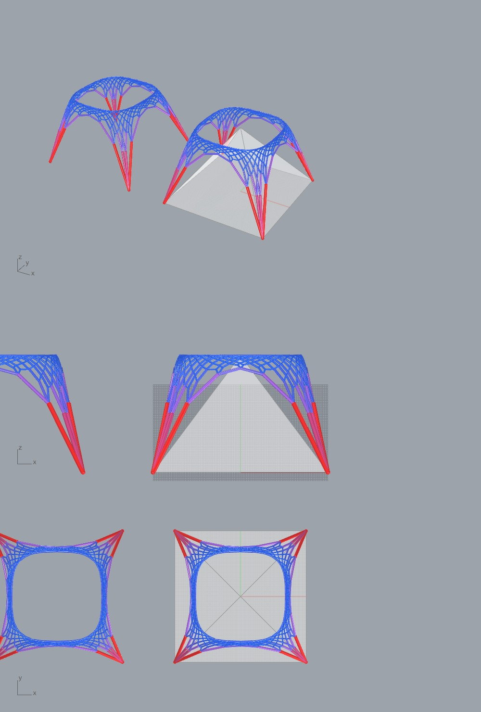
polyframe2/friend-square-4-corner-supports-opentop.png
