gonzalocrs/Amor_Mundi/polyframe2/karamba-19/19-Mx-LONG.png

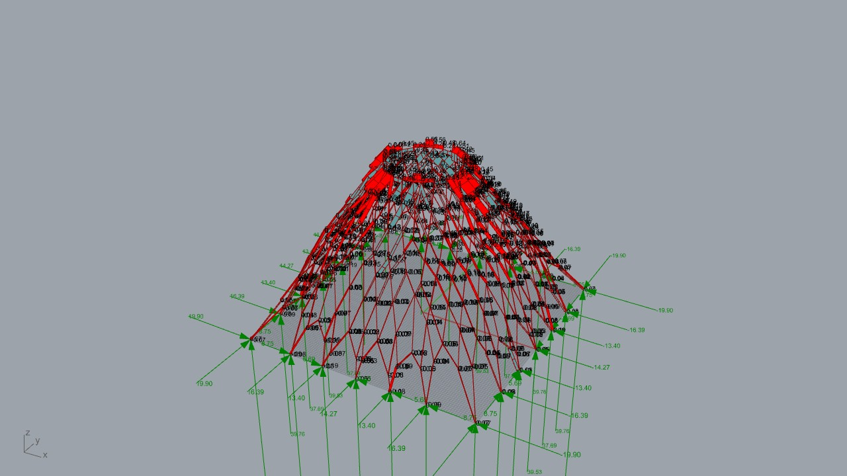
polyframe2/karamba-19/19-Mx-LONG.png
