gonzalocrs/Amor_Mundi/polyframe2/polyweave/polyweave-square-v2_canvas.png

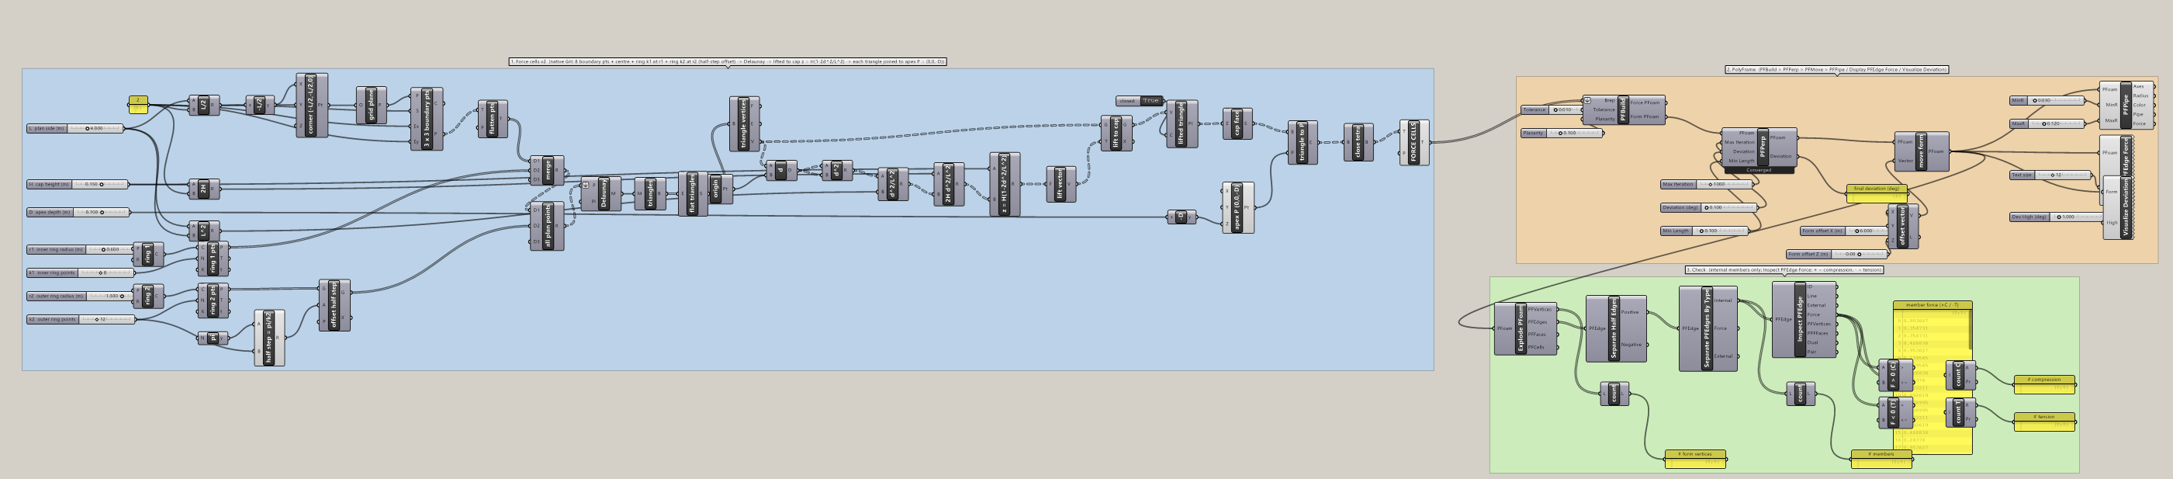
polyframe2/polyweave/polyweave-square-v2_canvas.png
