gonzalocrs/Amor_Mundi/polyframe2/polyweave/polyweave-square-v2_viewport.jpg

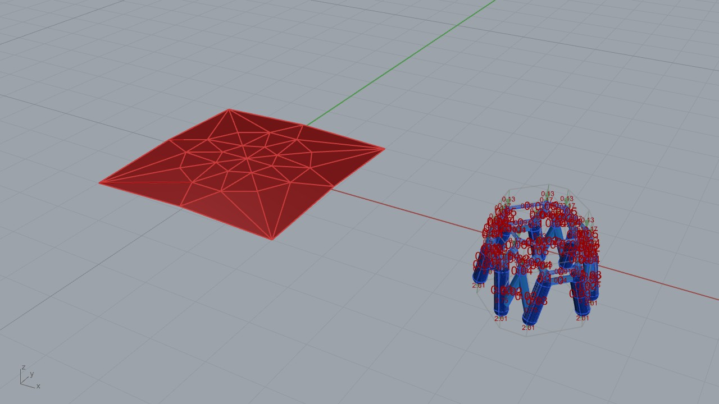
polyframe2/polyweave/polyweave-square-v2_viewport.jpg
