gonzalocrs/Amor_Mundi/polyframe2/polyweave/polyweave-square_canvas.png

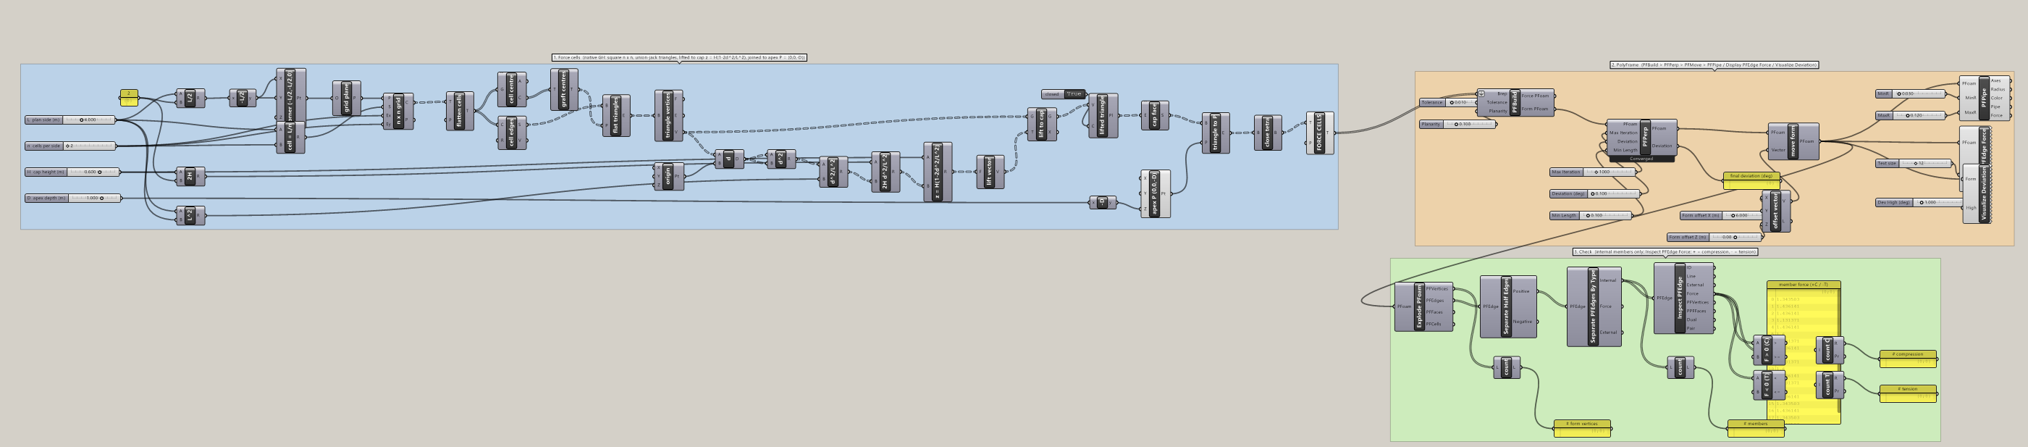
polyframe2/polyweave/polyweave-square_canvas.png
