gonzalocrs/Amor_Mundi/polyframe2/polyweave/polyweave-square_viewport.jpg

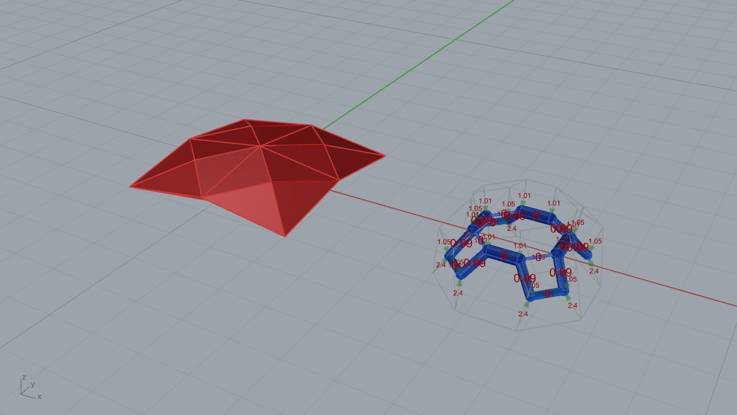
polyframe2/polyweave/polyweave-square_viewport.jpg
