gonzalocrs/Amor_Mundi/polyframe2/print/friend-15-1to50.stl

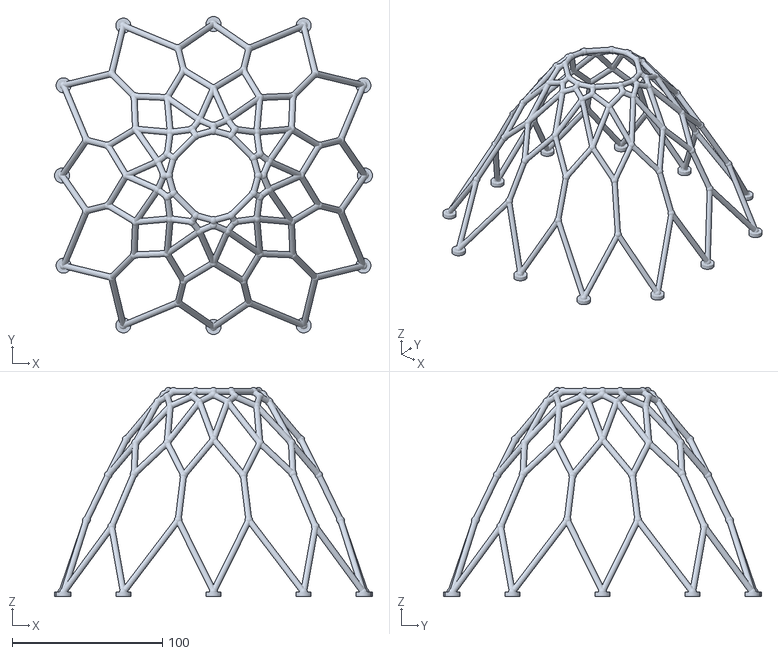
[picture p82: CAD file, 2026-10-30]
polyframe2/print/friend-15-1to50.stl
211.4 x 211.4 x 139.1
