gonzalocrs/Amor_Mundi/polyframe2/print/friend-15-1to100.stl

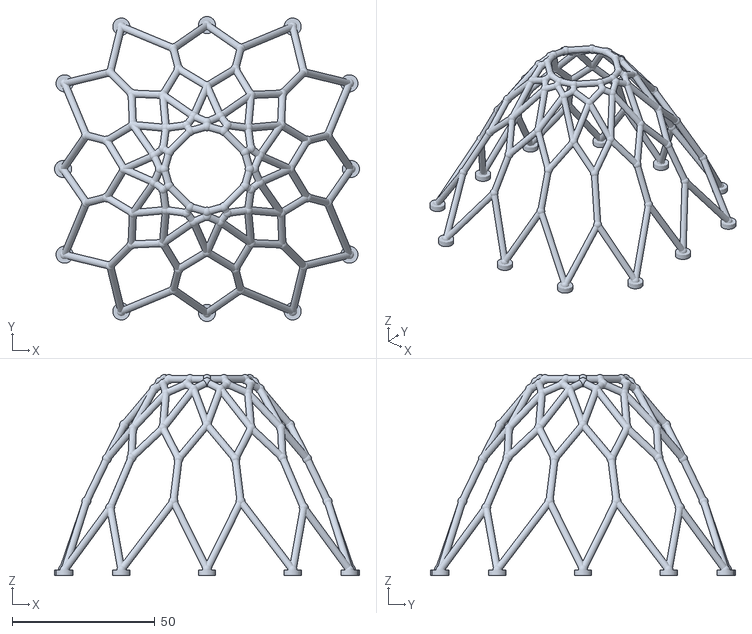
[picture p87: CAD file, 2026-10-30]
polyframe2/print/friend-15-1to100.stl
106.7 x 106.7 x 70.4
