gonzalocrs/Amor_Mundi/details/set/01_2026-10-14_80mm-layers/cad/09-roof-grid-B-elevation.dxf

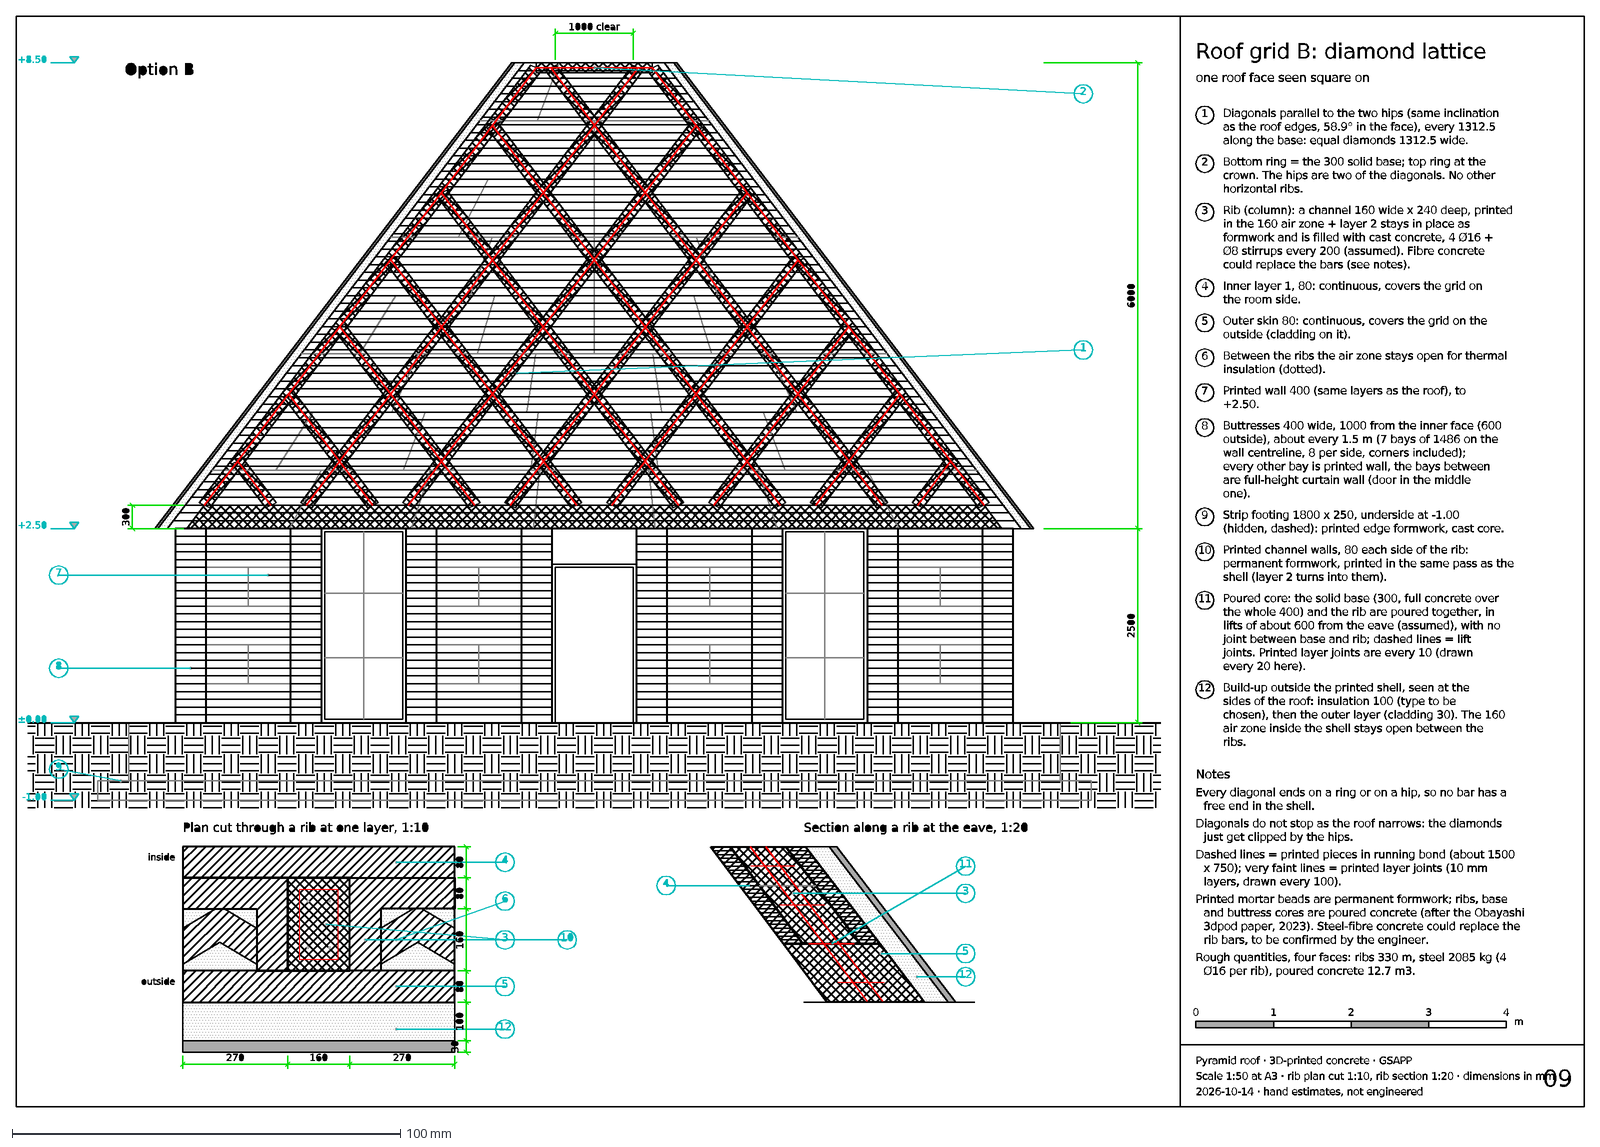
[picture p89: CAD file, 2026-10-14]
details/set/01_2026-10-14_80mm-layers/cad/09-roof-grid-B-elevation.dxf
Roof grid B: diamond lattice
one roof face seen square on
1
Diagonals parallel to the two hips (same inclination
as the roof edges, 58.9° in the face), every 1312.5
along the base: equal diamonds 1312.5 wide.
2
Bottom ring = the 300 solid base; top ring at the
crown. The hips are two of the diagonals. No other
horizontal ribs.
3
Rib (column): a channel 160 wide x 240 deep, printed
in the 160 air zone + layer 2 stays in place as
formwork and is filled with cast concrete, 4 Ø16 +
Ø8 stirrups every 200 (assumed). Fibre concrete
could replace the bars (see notes).
4
Inner layer 1, 80: continuous, covers the grid on
the room side.
5
Outer skin 80: continuous, covers the grid on the
outside (cladding on it).
6
Between the ribs the air zone stays open for thermal
insulation (dotted).
7
Printed wall 400 (same layers as the roof), to
+2.50.
8
Buttresses 400 wide, 1000 from the inner face (600
outside), about every 1.5 m (7 bays of 1486 on the
wall centreline, 8 per side, corners included);
every other bay is printed wall, the bays between
are full-height curtain wall (door in the middle
one).
9
Strip footing 1800 x 250, underside at -1.00
(hidden, dashed): printed edge formwork, cast core.
10
Printed channel walls, 80 each side of the rib:
permanent formwork, printed in the same pass as the
shell (layer 2 turns into them).
11
Poured core: the solid base (300, full concrete over
the whole 400) and the rib are poured together, in
lifts of about 600 from the eave (assumed), with no
joint between base and rib; dashed lines = lift
joints. Printed layer joints are every 10 (drawn
every 20 here).
12
Build-up outside the printed shell, seen at the
sides of the roof: insulation 100 (type to be
chosen), then the outer layer (cladding 30). The 160
air zone inside the shell stays open between the
ribs.
Notes
Every diagonal ends on a ring or on a hip, so no bar has a
free end in the shell.
Diagonals do not stop as the roof narrows: the diamonds
just get clipped by the hips.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
