gonzalocrs/Amor_Mundi/details/set/01_2026-10-14_80mm-layers/cad/01-floor-plan.dxf

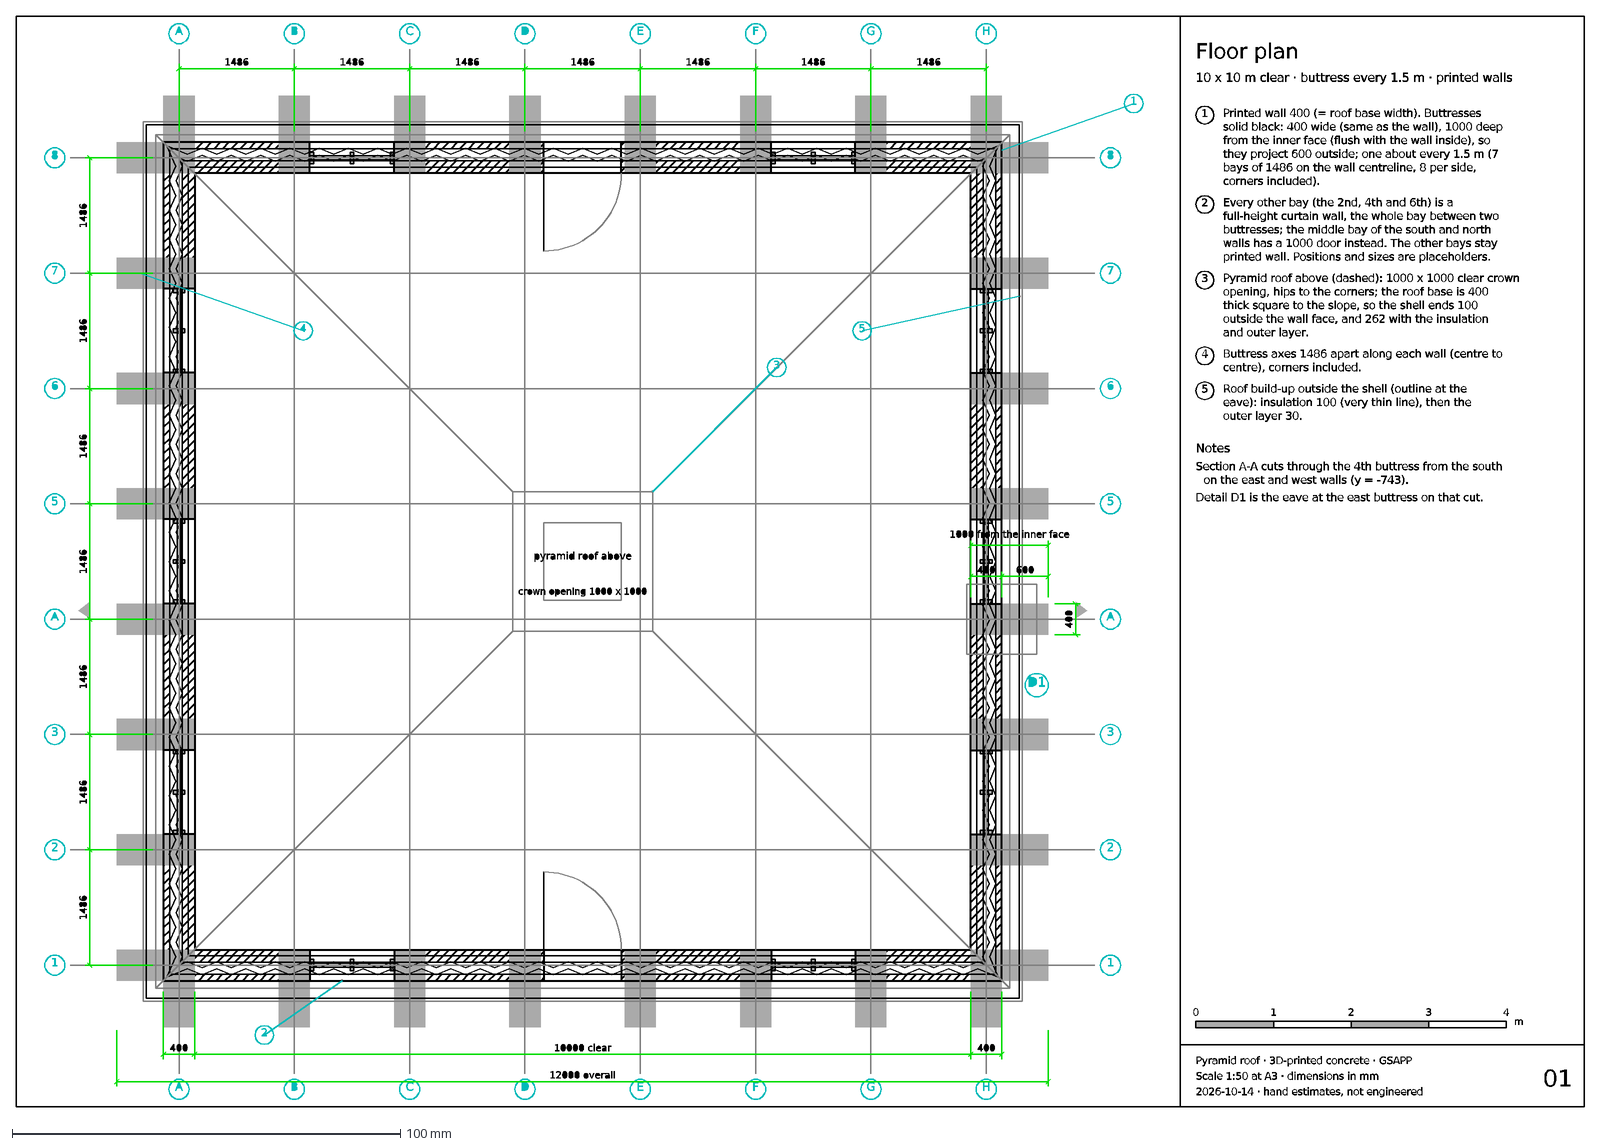
[picture p96: CAD file, 2026-10-14]
details/set/01_2026-10-14_80mm-layers/cad/01-floor-plan.dxf
Floor plan
10 x 10 m clear · buttress every 1.5 m · printed walls
1
Printed wall 400 (= roof base width). Buttresses
solid black: 400 wide (same as the wall), 1000 deep
from the inner face (flush with the wall inside), so
they project 600 outside; one about every 1.5 m (7
bays of 1486 on the wall centreline, 8 per side,
corners included).
2
Every other bay (the 2nd, 4th and 6th) is a
full-height curtain wall, the whole bay between two
buttresses; the middle bay of the south and north
walls has a 1000 door instead. The other bays stay
printed wall. Positions and sizes are placeholders.
3
Pyramid roof above (dashed): 1000 x 1000 clear crown
opening, hips to the corners; the roof base is 400
thick square to the slope, so the shell ends 100
outside the wall face, and 262 with the insulation
and outer layer.
4
Buttress axes 1486 apart along each wall (centre to
centre), corners included.
5
Roof build-up outside the shell (outline at the
eave): insulation 100 (very thin line), then the
outer layer 30.
Notes
Section A-A cuts through the 4th buttress from the south
on the east and west walls (y = -743).
Detail D1 is the eave at the east buttress on that cut.
0
m
Pyramid roof · 3D-printed concrete · GSAPP
Scale 1:50 at A3 · dimensions in mm
2026-10-14 · hand estimates, not engineered
01
