gonzalocrs/Amor_Mundi/details/set/01_2026-10-14_80mm-layers/cad/08-roof-grid-A-elevation.dxf

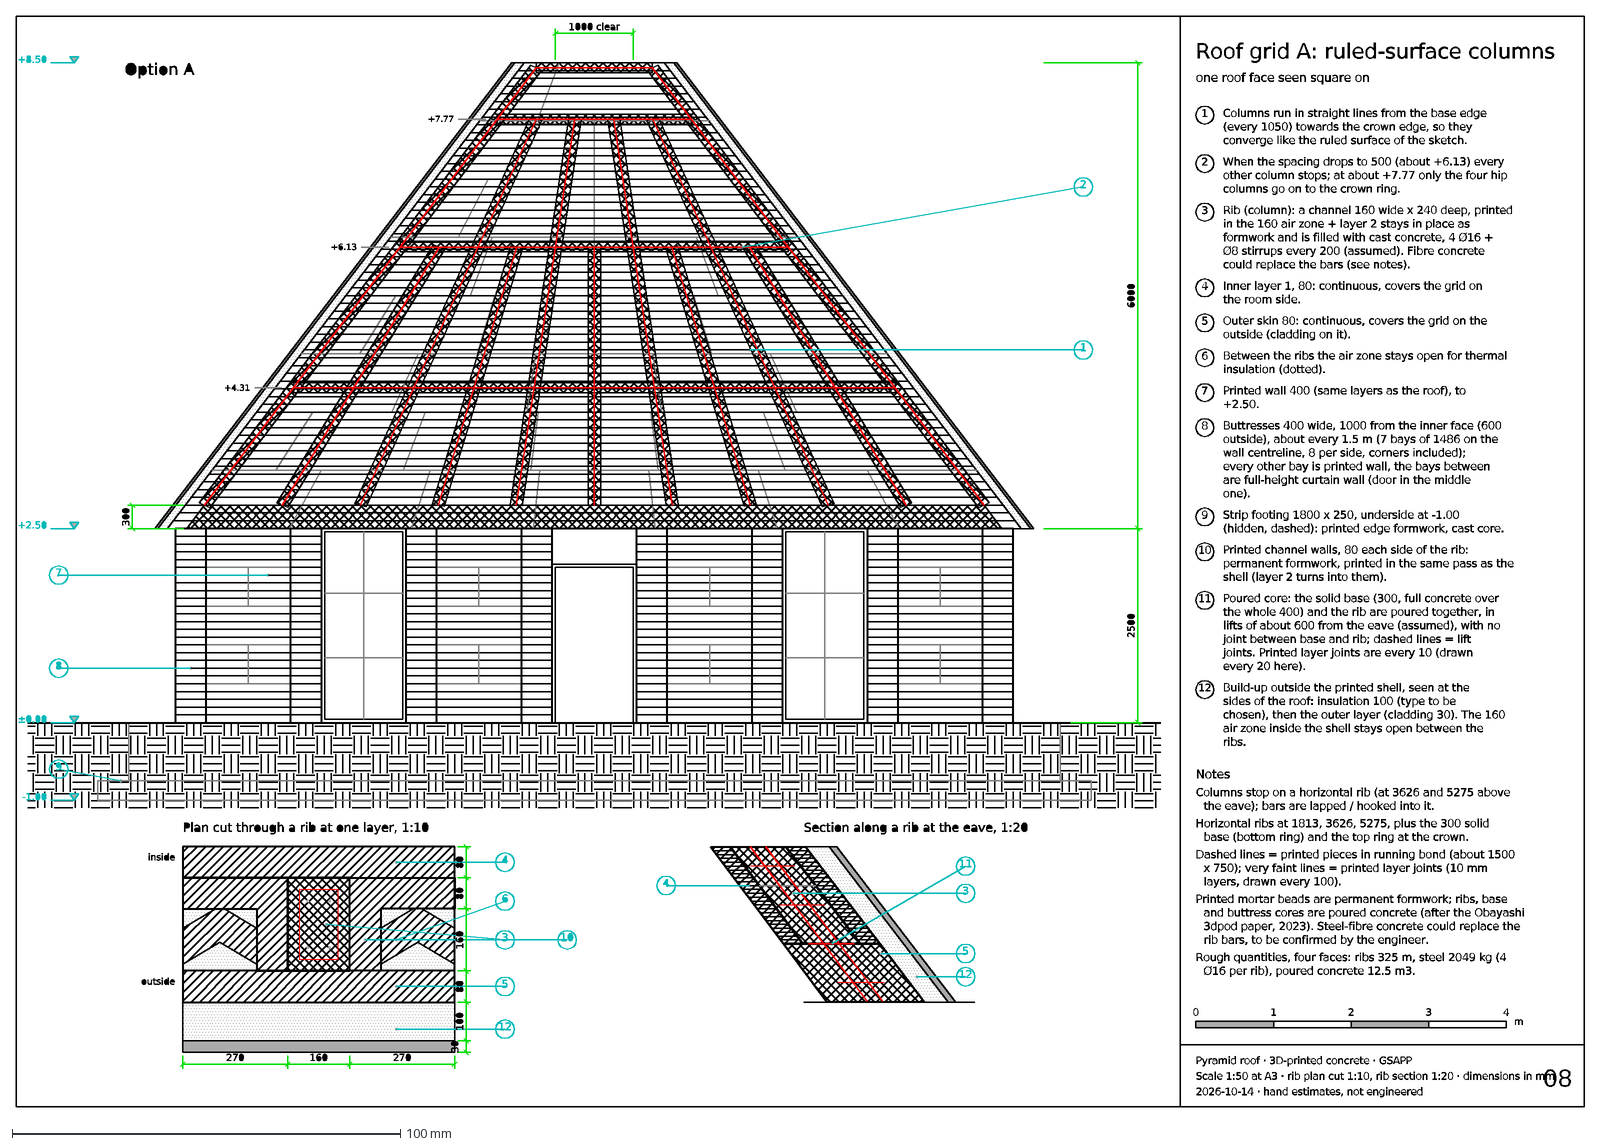
[picture p99: CAD file, 2026-10-14]
details/set/01_2026-10-14_80mm-layers/cad/08-roof-grid-A-elevation.dxf
Roof grid A: ruled-surface columns
one roof face seen square on
1
Columns run in straight lines from the base edge
(every 1050) towards the crown edge, so they
converge like the ruled surface of the sketch.
2
When the spacing drops to 500 (about +6.13) every
other column stops; at about +7.77 only the four hip
columns go on to the crown ring.
3
Rib (column): a channel 160 wide x 240 deep, printed
in the 160 air zone + layer 2 stays in place as
formwork and is filled with cast concrete, 4 Ø16 +
Ø8 stirrups every 200 (assumed). Fibre concrete
could replace the bars (see notes).
4
Inner layer 1, 80: continuous, covers the grid on
the room side.
5
Outer skin 80: continuous, covers the grid on the
outside (cladding on it).
6
Between the ribs the air zone stays open for thermal
insulation (dotted).
7
Printed wall 400 (same layers as the roof), to
+2.50.
8
Buttresses 400 wide, 1000 from the inner face (600
outside), about every 1.5 m (7 bays of 1486 on the
wall centreline, 8 per side, corners included);
every other bay is printed wall, the bays between
are full-height curtain wall (door in the middle
one).
9
Strip footing 1800 x 250, underside at -1.00
(hidden, dashed): printed edge formwork, cast core.
10
Printed channel walls, 80 each side of the rib:
permanent formwork, printed in the same pass as the
shell (layer 2 turns into them).
11
Poured core: the solid base (300, full concrete over
the whole 400) and the rib are poured together, in
lifts of about 600 from the eave (assumed), with no
joint between base and rib; dashed lines = lift
joints. Printed layer joints are every 10 (drawn
every 20 here).
12
Build-up outside the printed shell, seen at the
sides of the roof: insulation 100 (type to be
chosen), then the outer layer (cladding 30). The 160
air zone inside the shell stays open between the
ribs.
Notes
Columns stop on a horizontal rib (at 3626 and 5275 above
the eave); bars are lapped / hooked into it.
Horizontal ribs at 1813, 3626, 5275, plus the 300 solid
base (bottom ring) and the top ring at the crown.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
