gonzalocrs/Amor_Mundi/details/set/01_2026-10-14_80mm-layers/cad/05-section-AA-grid-B.dxf

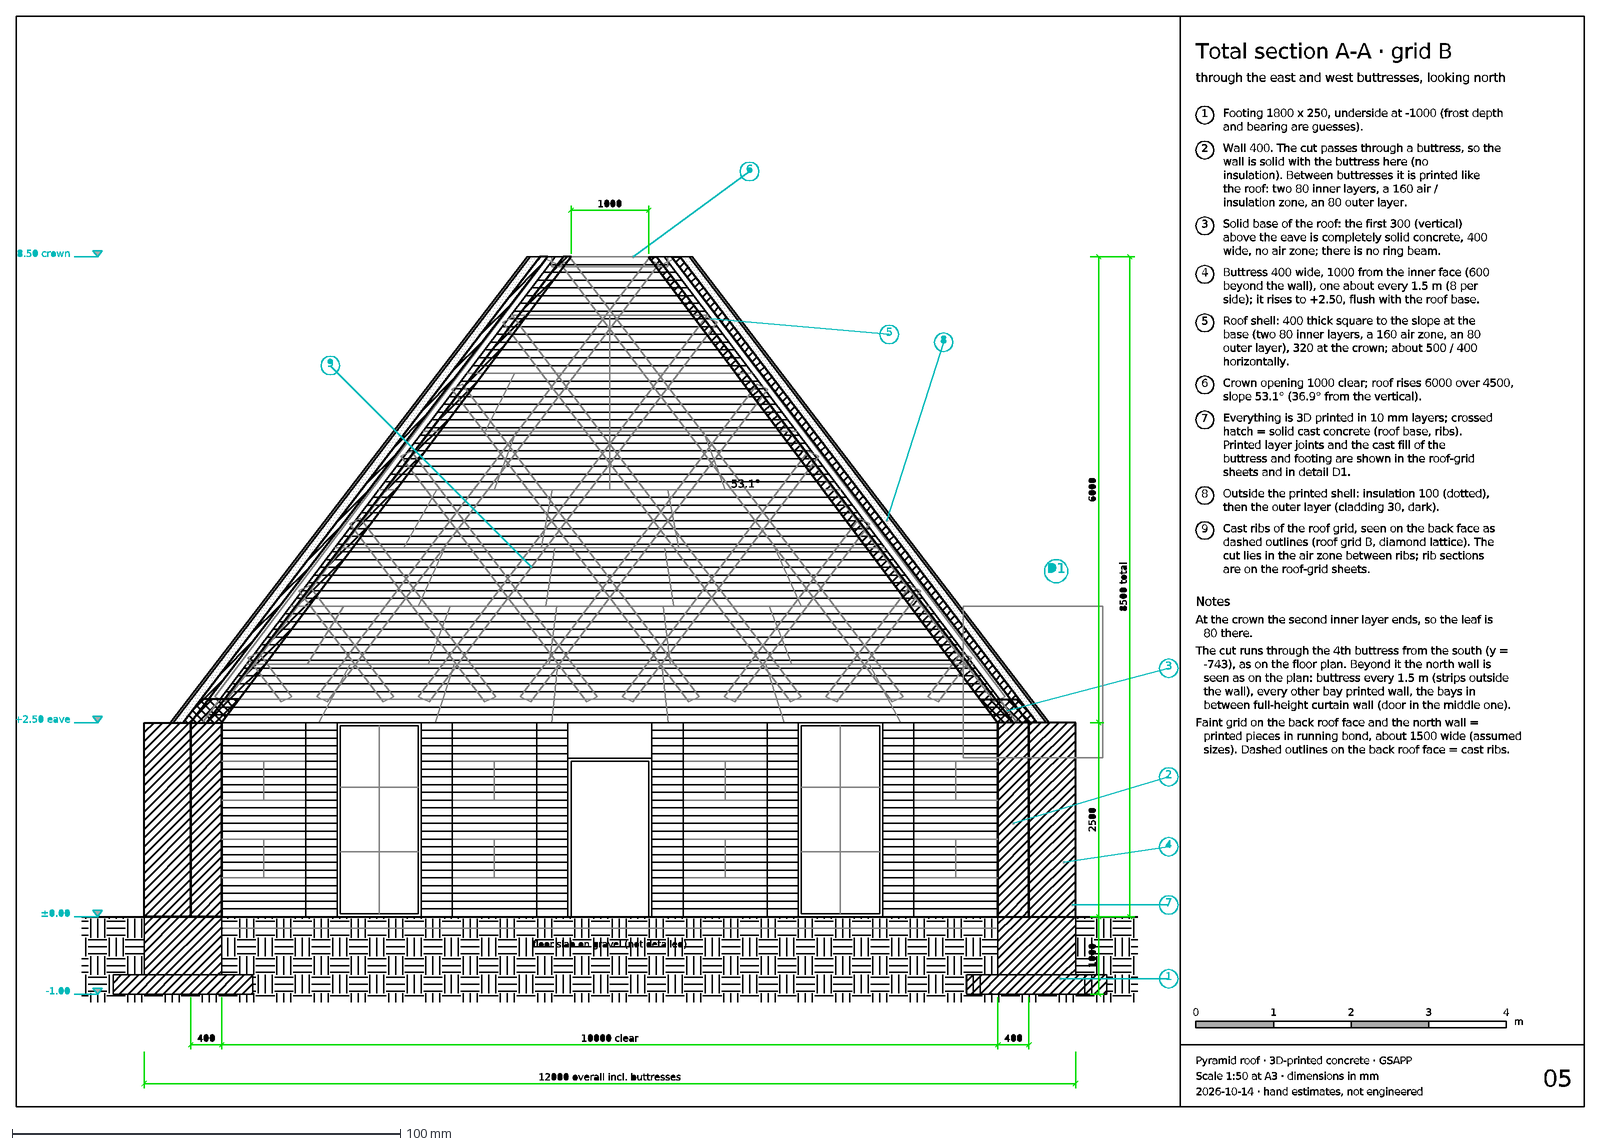
[picture p108: CAD file, 2026-10-14]
details/set/01_2026-10-14_80mm-layers/cad/05-section-AA-grid-B.dxf
Total section A-A · grid B
through the east and west buttresses, looking north
1
Footing 1800 x 250, underside at -1000 (frost depth
and bearing are guesses).
2
Wall 400. The cut passes through a buttress, so the
wall is solid with the buttress here (no
insulation). Between buttresses it is printed like
the roof: two 80 inner layers, a 160 air /
insulation zone, an 80 outer layer.
3
Solid base of the roof: the first 300 (vertical)
above the eave is completely solid concrete, 400
wide, no air zone; there is no ring beam.
4
Buttress 400 wide, 1000 from the inner face (600
beyond the wall), one about every 1.5 m (8 per
side); it rises to +2.50, flush with the roof base.
5
Roof shell: 400 thick square to the slope at the
base (two 80 inner layers, a 160 air zone, an 80
outer layer), 320 at the crown; about 500 / 400
horizontally.
6
Crown opening 1000 clear; roof rises 6000 over 4500,
slope 53.1° (36.9° from the vertical).
7
Everything is 3D printed in 10 mm layers; crossed
hatch = solid cast concrete (roof base, ribs).
Printed layer joints and the cast fill of the
buttress and footing are shown in the roof-grid
sheets and in detail D1.
8
Outside the printed shell: insulation 100 (dotted),
then the outer layer (cladding 30, dark).
9
Cast ribs of the roof grid, seen on the back face as
dashed outlines (roof grid B, diamond lattice). The
cut lies in the air zone between ribs; rib sections
are on the roof-grid sheets.
Notes
At the crown the second inner layer ends, so the leaf is
80 there.
The cut runs through the 4th buttress from the south (y =
-743), as on the floor plan. Beyond it the north wall is
seen as on the plan: buttress every 1.5 m (strips outside
the wall), every other bay printed wall, the bays in
between full-height curtain wall (door in the middle one).
Faint grid on the back roof face and the north wall =
printed pieces in running bond, about 1500 wide (assumed
sizes). Dashed outlines on the back roof face = cast ribs.
0
m
Pyramid roof · 3D-printed concrete · GSAPP
Scale 1:50 at A3 · dimensions in mm
2026-10-14 · hand estimates, not engineered
05
