gonzalocrs/Amor_Mundi/details/set/03_2026-10-14_no-outside-insulation/cad/07-roof-plan-cut-grid-B.dxf

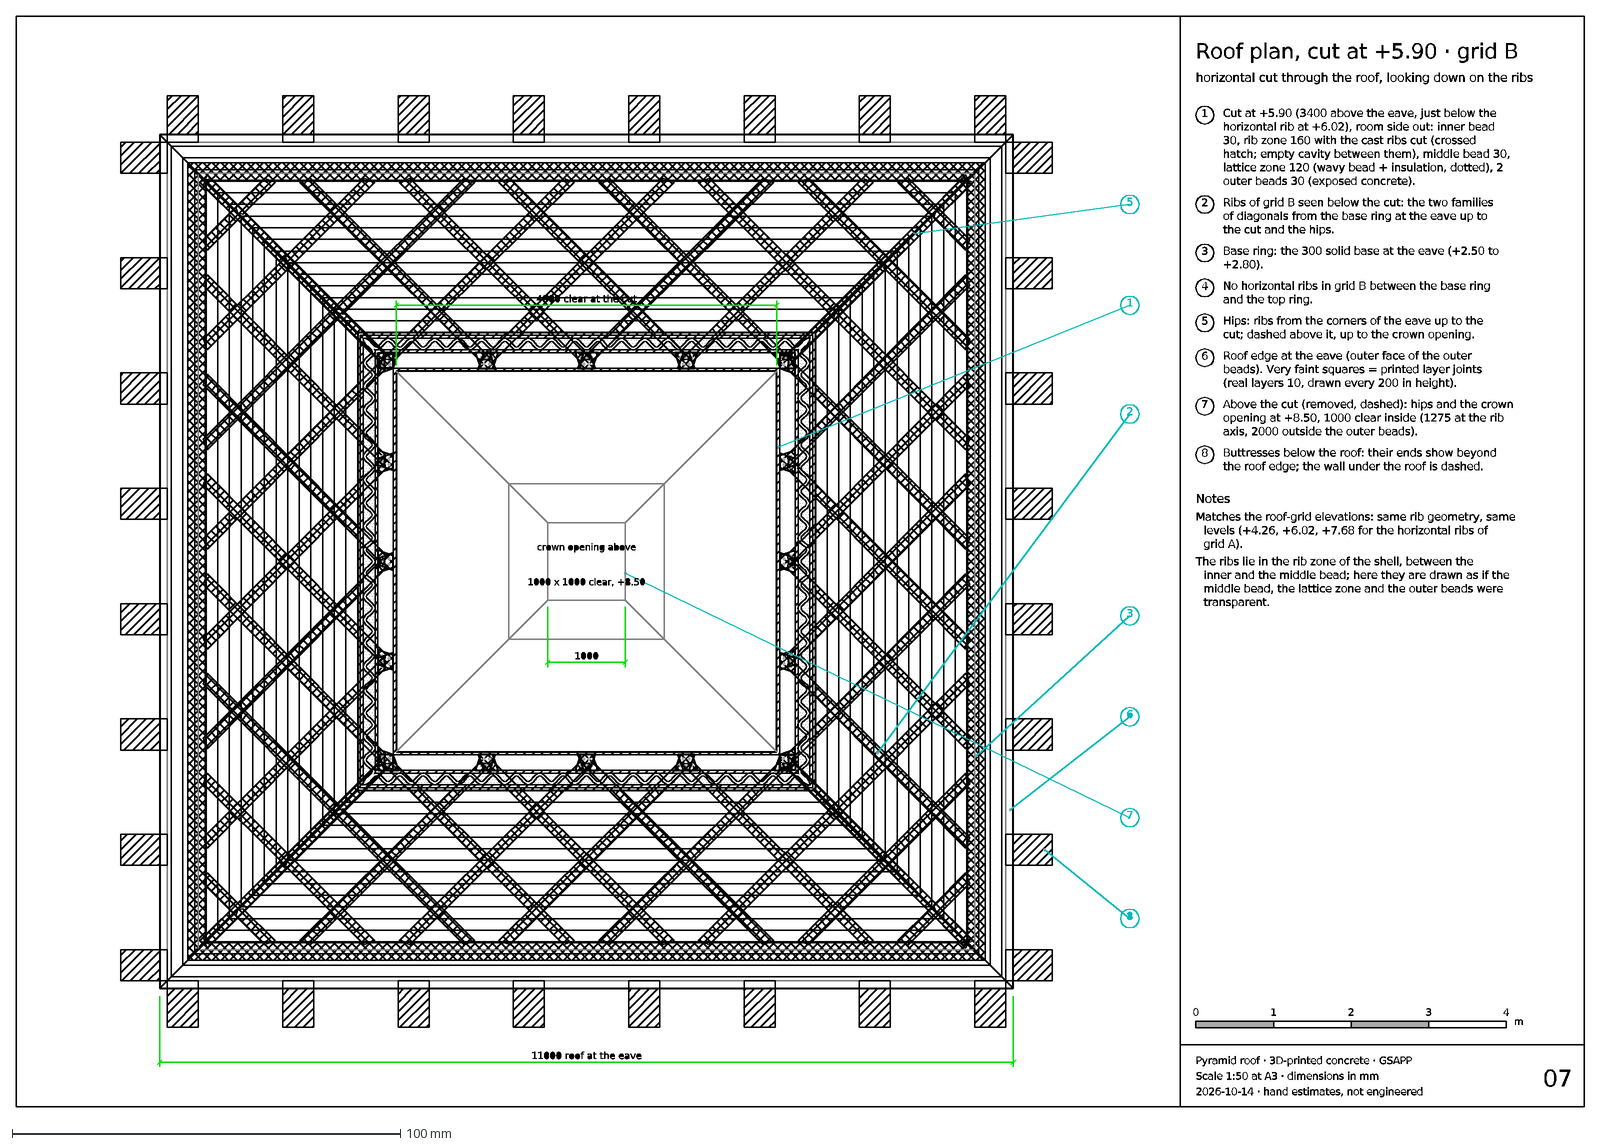
[picture p113: CAD file, 2026-10-15]
details/set/03_2026-10-14_no-outside-insulation/cad/07-roof-plan-cut-grid-B.dxf
Roof plan, cut at +5.90 · grid B
horizontal cut through the roof, looking down on the ribs
1
Cut at +5.90 (3400 above the eave, just below the
horizontal rib at +6.02), room side out: inner bead
30, rib zone 160 with the cast ribs cut (crossed
hatch; empty cavity between them), middle bead 30,
lattice zone 120 (wavy bead + insulation, dotted), 2
outer beads 30 (exposed concrete).
2
Ribs of grid B seen below the cut: the two families
of diagonals from the base ring at the eave up to
the cut and the hips.
3
Base ring: the 300 solid base at the eave (+2.50 to
+2.80).
4
No horizontal ribs in grid B between the base ring
and the top ring.
5
Hips: ribs from the corners of the eave up to the
cut; dashed above it, up to the crown opening.
6
Roof edge at the eave (outer face of the outer
beads). Very faint squares = printed layer joints
(real layers 10, drawn every 200 in height).
7
Above the cut (removed, dashed): hips and the crown
opening at +8.50, 1000 clear inside (1275 at the rib
axis, 2000 outside the outer beads).
8
Buttresses below the roof: their ends show beyond
the roof edge; the wall under the roof is dashed.
Notes
Matches the roof-grid elevations: same rib geometry, same
levels (+4.26, +6.02, +7.68 for the horizontal ribs of
grid A).
The ribs lie in the rib zone of the shell, between the
inner and the middle bead; here they are drawn as if the
middle bead, the lattice zone and the outer beads were
transparent.
0
m
Pyramid roof · 3D-printed concrete · GSAPP
Scale 1:50 at A3 · dimensions in mm
2026-10-14 · hand estimates, not engineered
07
