gonzalocrs/Amor_Mundi/(list of files, cad)

Other CAD files:
archive/2026-10-14-before-drawing-set/details/cad/pyramid-detail.dwg
archive/2026-10-14-before-drawing-set/details/cad/pyramid-plan-gridB.dxf
archive/2026-10-14-before-drawing-set/details/cad/pyramid-plan.dxf
archive/2026-10-14-before-drawing-set/details/cad/pyramid-section-gridA.dxf
details/cad/pyramid-detail.dwg
form-finding/branching-variants.3dm
polyframe2/friend-all-iterations-clean-2026-10-29.3dm
polyframe2/friend-all-models-2026-10-29.3dm
polyframe2/friend-iterations-review-v2.3dm
polyframe2/friend-iterations-review-v3.3dm
polyframe2/friend-iterations-review-v4.3dm
polyframe2/friend-iterations-review-v5.3dm
polyframe2/friend-iterations-review.3dm
polyframe2/friend-models-clean-2026-10-29.3dm
polyframe2/polyweave/polyweave-square-v2.3dm
polyframe2/polyweave/polyweave-square.3dm
polyframe2/roof-force-diagram.3dm
rhino/10.20.26 Karamba_structure.3dm
rhino/10_1_2026.3dm
