gonzalocrs/Amor_Mundi/polyframe2/step2-force-and-form.png

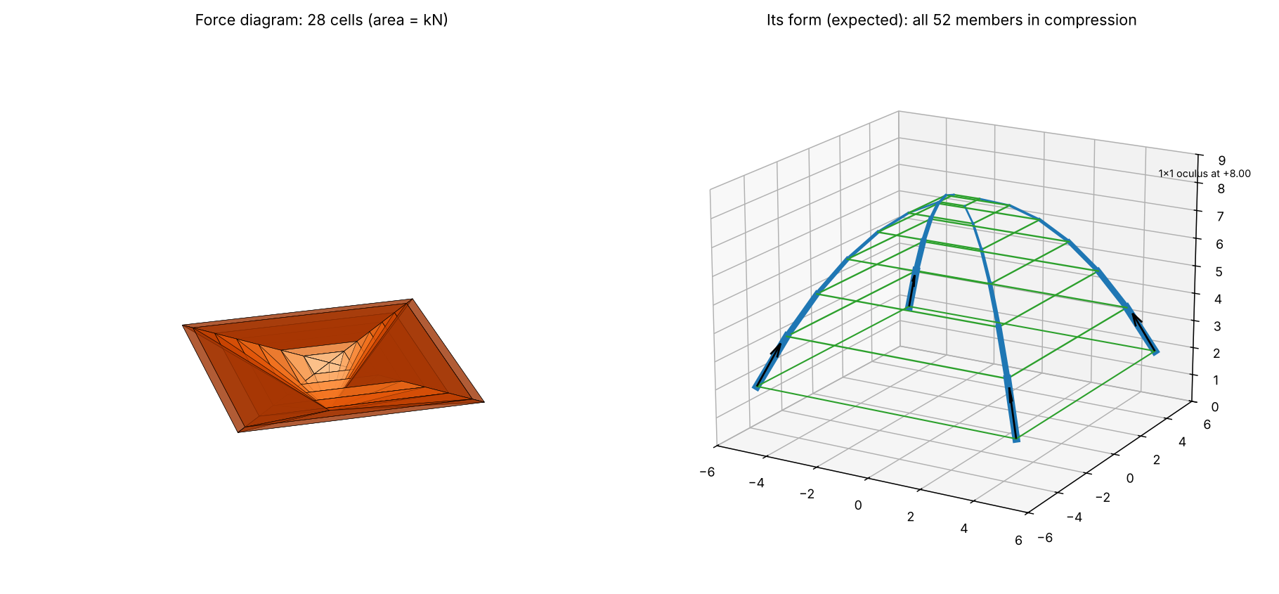
polyframe2/step2-force-and-form.png
