gonzalocrs/Amor_Mundi/details/set/03_2026-10-14_no-outside-insulation/pyramid-roof-drawing-set.pdf

F

l

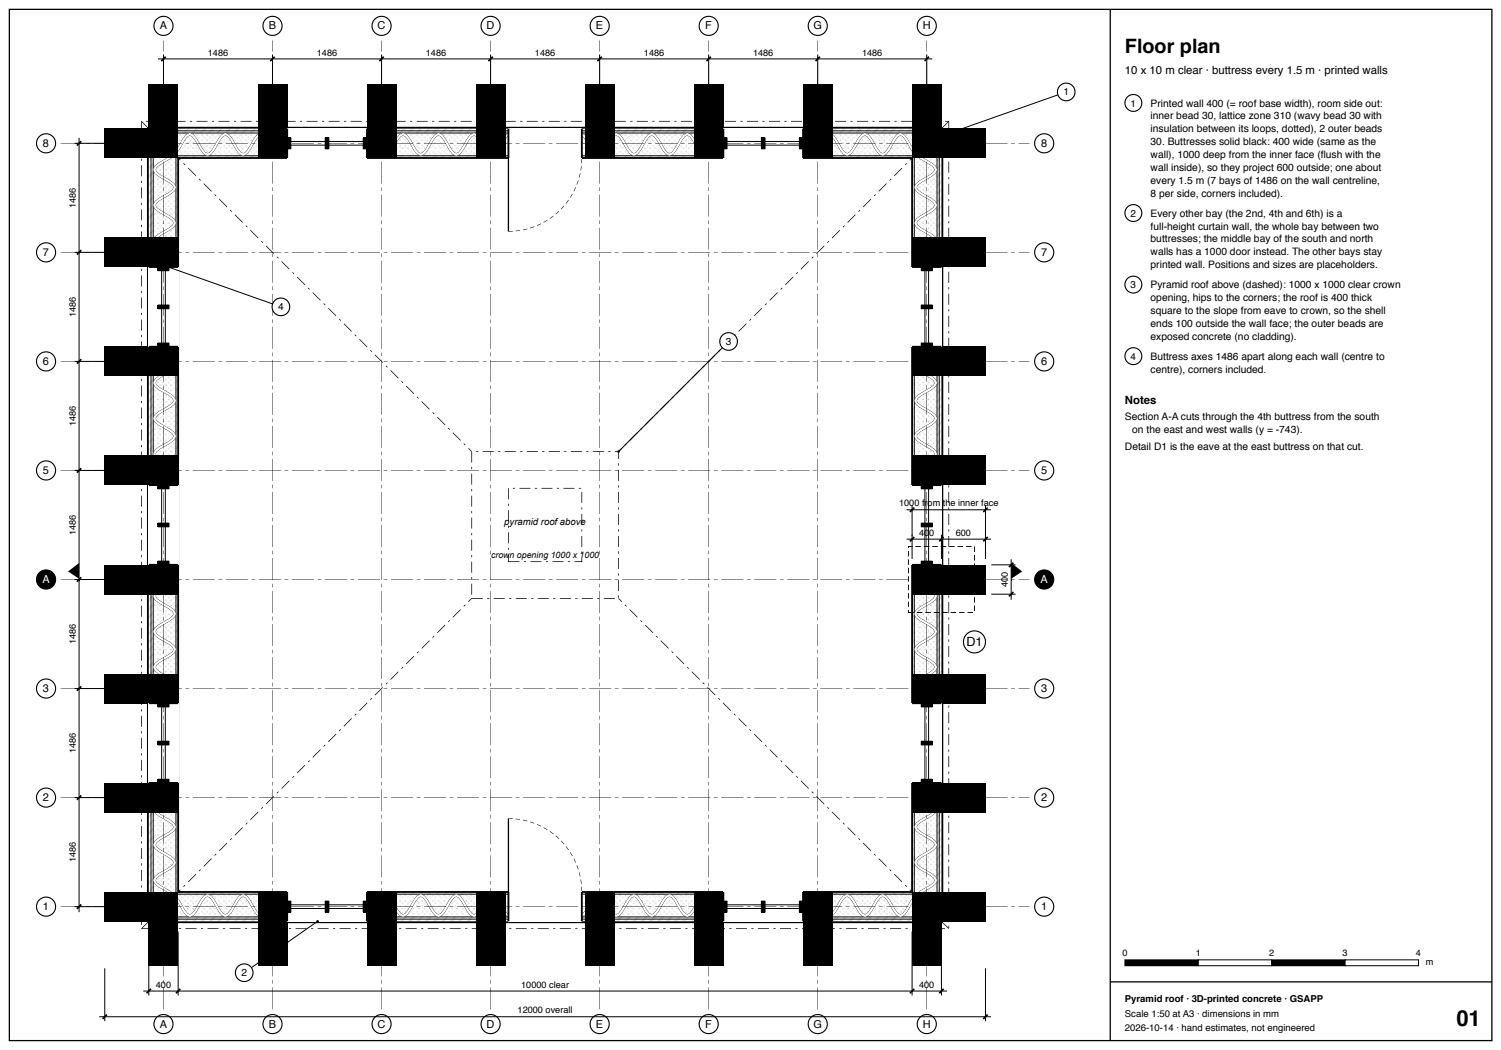
[picture p127: page 1]
yra; cle; all ¹⁴⁸⁶ ¹⁴⁸⁶ ¹⁴⁸⁶ ¹⁴⁸⁶ ¹⁴⁸⁶ ¹⁴⁸⁶ ¹⁴⁸⁶; rin; alls; all 4; wid; sid; t: inner bead 30, lattice zone 310 (wavy bead 30 with insulation between its loops, dotted), 2 outer beads 30. Buttresses solid black: 400 wide (same as the wall), 1000 deep from the inner face (flush with the wall inside), so they project 600 outside; one about every 1.5 m (7 bays of 1486 on the wall centreline, 8 per side, corners included). 2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

F

g

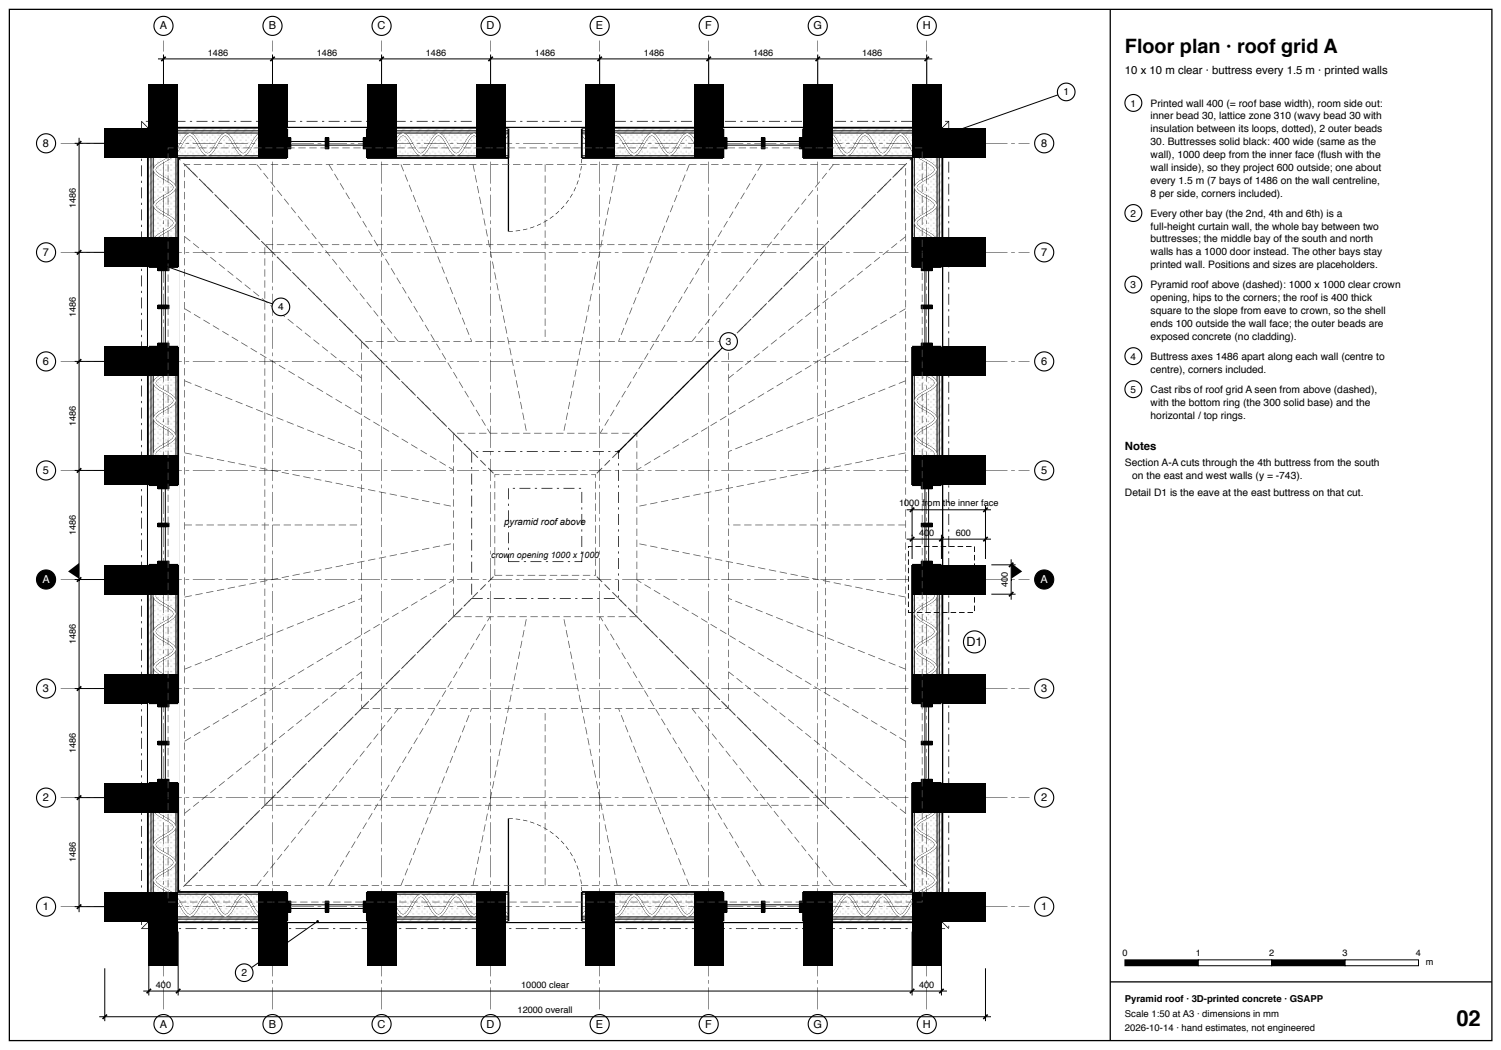
[picture p128: page 2]
yra; all ¹⁴⁸⁶ ¹⁴⁸⁶ ¹⁴⁸⁶ ¹⁴⁸⁶ ¹⁴⁸⁶ ¹⁴⁸⁶ ¹⁴⁸⁶; rin; alls; all 4; wid; sid; t: inner bead 30, lattice zone 310 (wavy bead 30 with insulation between its loops, dotted), 2 outer beads 30. Buttresses solid black: 400 wide (same as the wall), 1000 deep from the inner face (flush with the wall inside), so they project 600 outside; one about every 1.5 m (7 bays of 1486 on the wall centreline, 8 per side, corners included). 2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

F

B

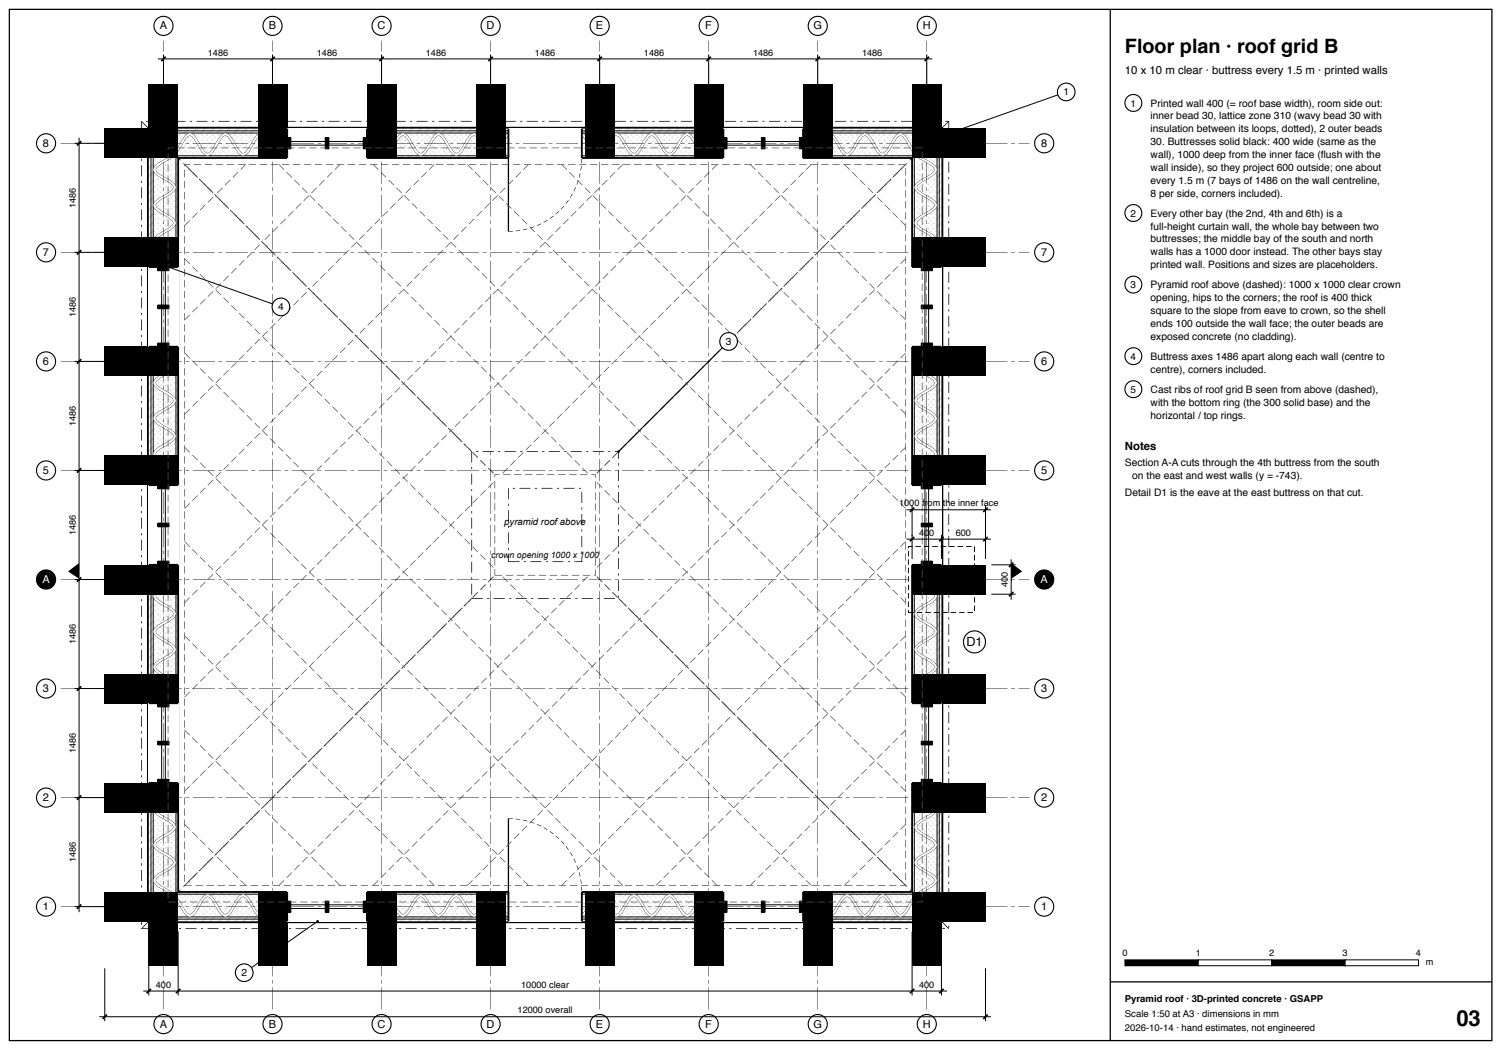
[picture p129: page 3]
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

To

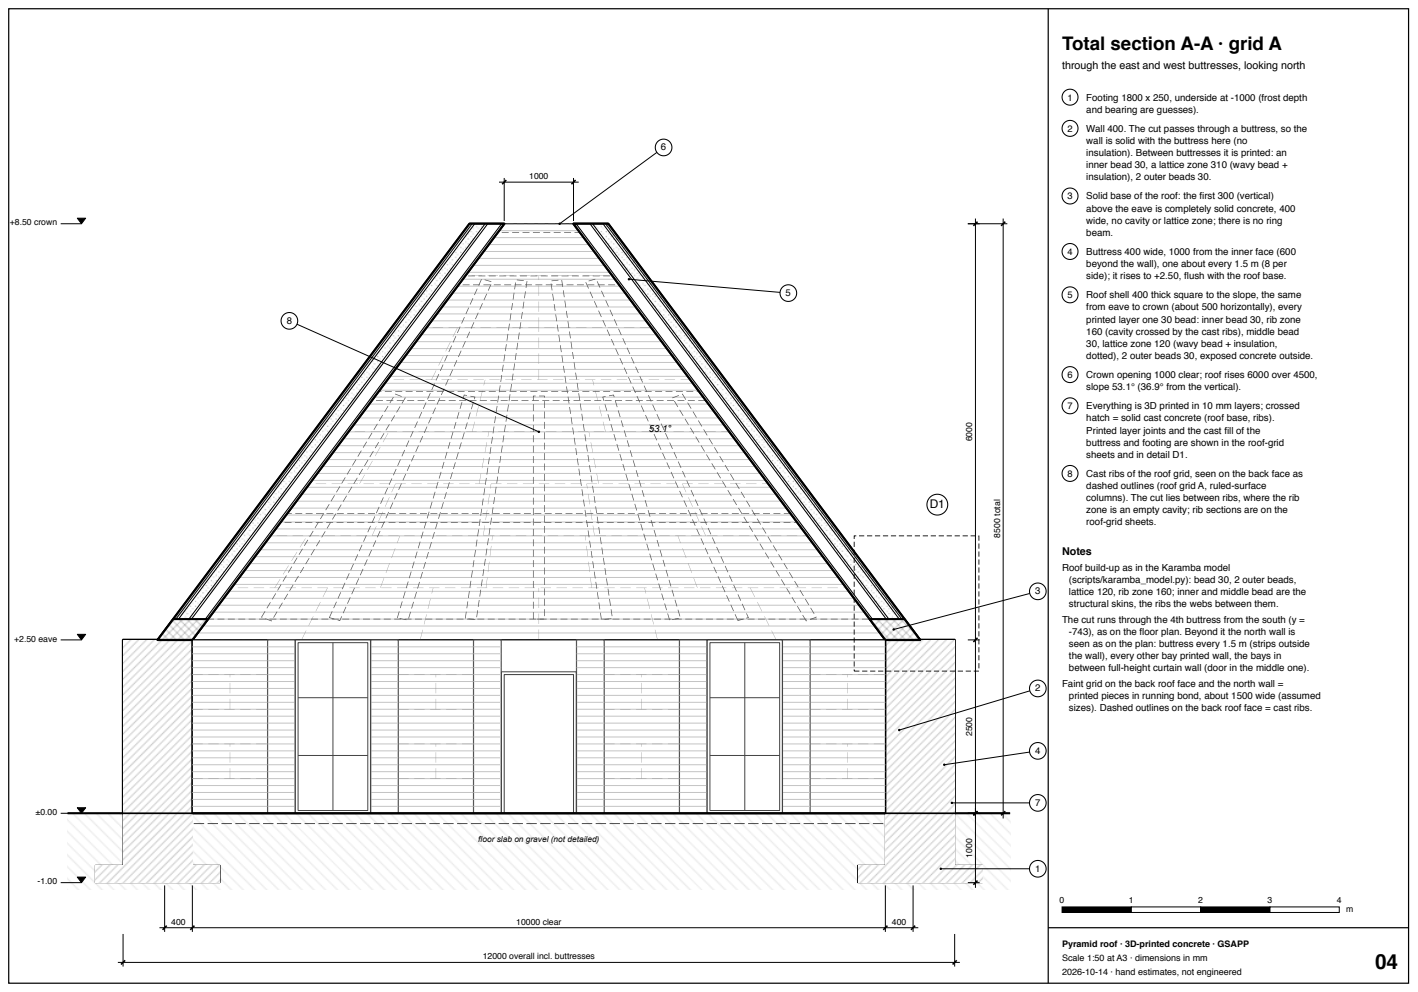
[picture p130: page 4]
8500 total; cle; all in; kin; tin; sid; rin; Wall 400. The cut passes t; all is; olid; wit; n inner bead 30, a lattice zone 310 (wavy bead + insulation), 2 outer beads 30. 3; Solid base of the roof: the first 300 (vertical) above the eave is completely solid concrete, 40; wid; vit; tic; Buttre; all), o; ris; Roof shell 400 thick square to the slope, the sa; riz; ally; 0, rib; rib; ), mid; dle; ula; tio; Crown opening 1000 clear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

o insulation). Between buttresses it is prin

n, dotted), 2 outer beads 30, exposed concrete

To

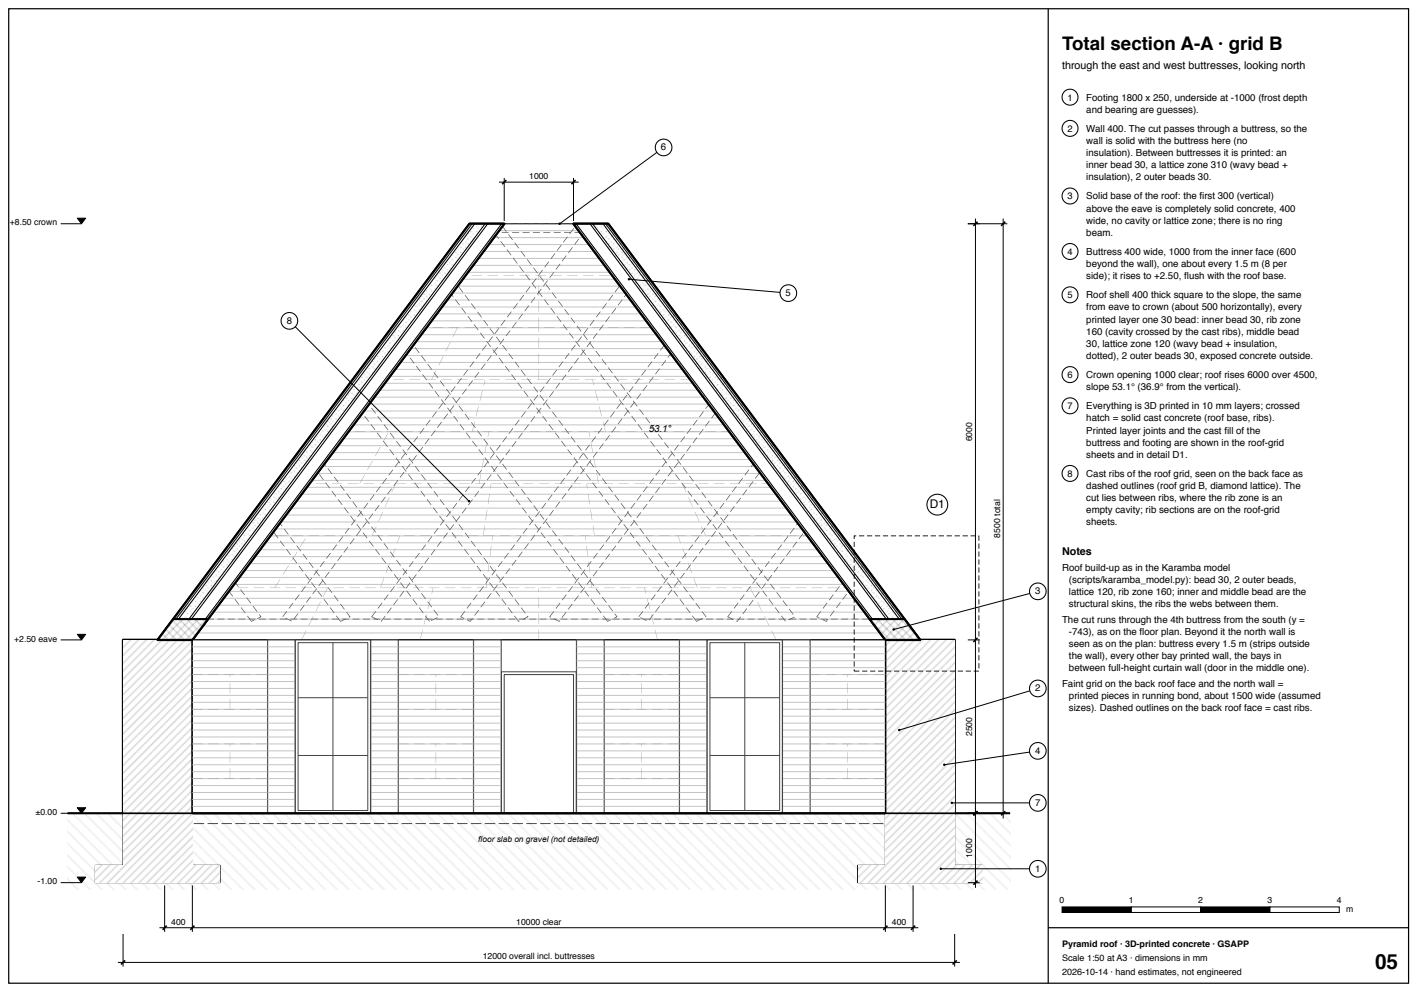
[picture p131: page 5]
8500 total; cle; all in; tin; sid; rin; Wall 400. The cut passes t; all is; olid; wit; n inner bead 30, a lattice zone 310 (wavy bead + insulation), 2 outer beads 30. 3; Solid base of the roof: the first 300 (vertical) above the eave is completely solid concrete, 40; wid; vit; tic; Buttre; all), o; ris; Roof shell 400 thick square to the slope, the sa; riz; ally; 0, rib; rib; ), mid; dle; ula; tio; Crown opening 1000 clear; roof rises 6000 over 4500, slope 53.1° (36.9° from the vertical). 7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

o insulation). Between buttresses it is prin

n, dotted), 2 outer beads 30, exposed concrete

R

,

+

5

9

riz

al c

f, lo

rib

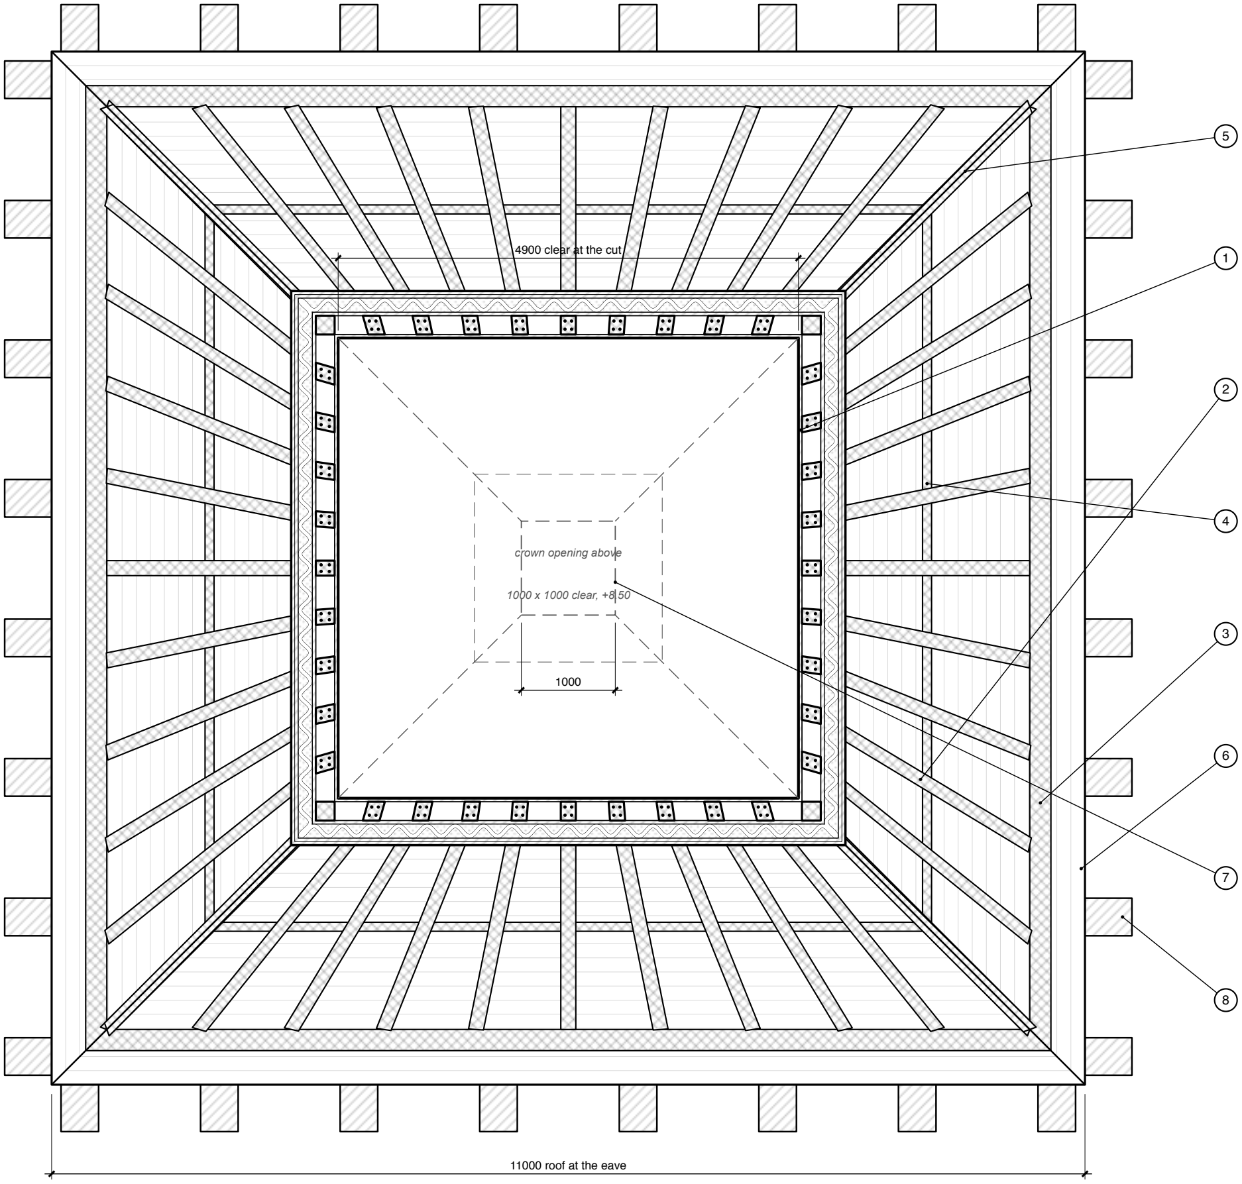
[picture p132: figure]
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
e, j

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
al rib

a

t

+

6.0

2

), r

o

o

m

sid

e

o

u

t: in

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
0, rib

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
h; e

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
), mid

dle

b

e

a

d

3

0, lattice zone 120 (wavy bead + insulation, dotted), 2 outer beads 30 (exposed concrete). 2 | Ribs of grid A seen below the cut: all 11 columns per face run from the base ring at the eave up to the cut (every other one stops at +6.02, just above it). 3 | Base ring: the 300 solid base at the eave (+2.50 to +2.80). 4 | Horizontal rib of grid A at +4.26 (the next ones, at +6.02 and +7.68, are above the cut). 5 | Hips: ribs from the corners of the eave up to the cut; dashed above it, up to the crown opening. 6 | Roof edge at the eave (outer face of the outer beads). Very faint squares = printed layer joints (real layers 10, drawn every 200 in height). 7 | Above the cut (removed, dashed): hips and the crow

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
0, 1

0

0

0

cle

a

r in

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
xis, 2

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
). 8 Buttresses below the roof: their ends s

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
e; t

h

e

w

all u

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
f is

d

a

s

h

e

d. Notes Matches the roof-grid elevations: same rib geometry, s

a

m

e levels (+4.26, +6.02, +7.68 for the horizontal ribs of grid A). The ribs lie in the rib zone of the shell, between the inner and the middle bead; here they are drawn as if the middle bead, the lattice zone and the outer beads were transparent. 0 | 1 | 2 | 3

4
m

6

,

5

9

riz

al c

f, lo

rib

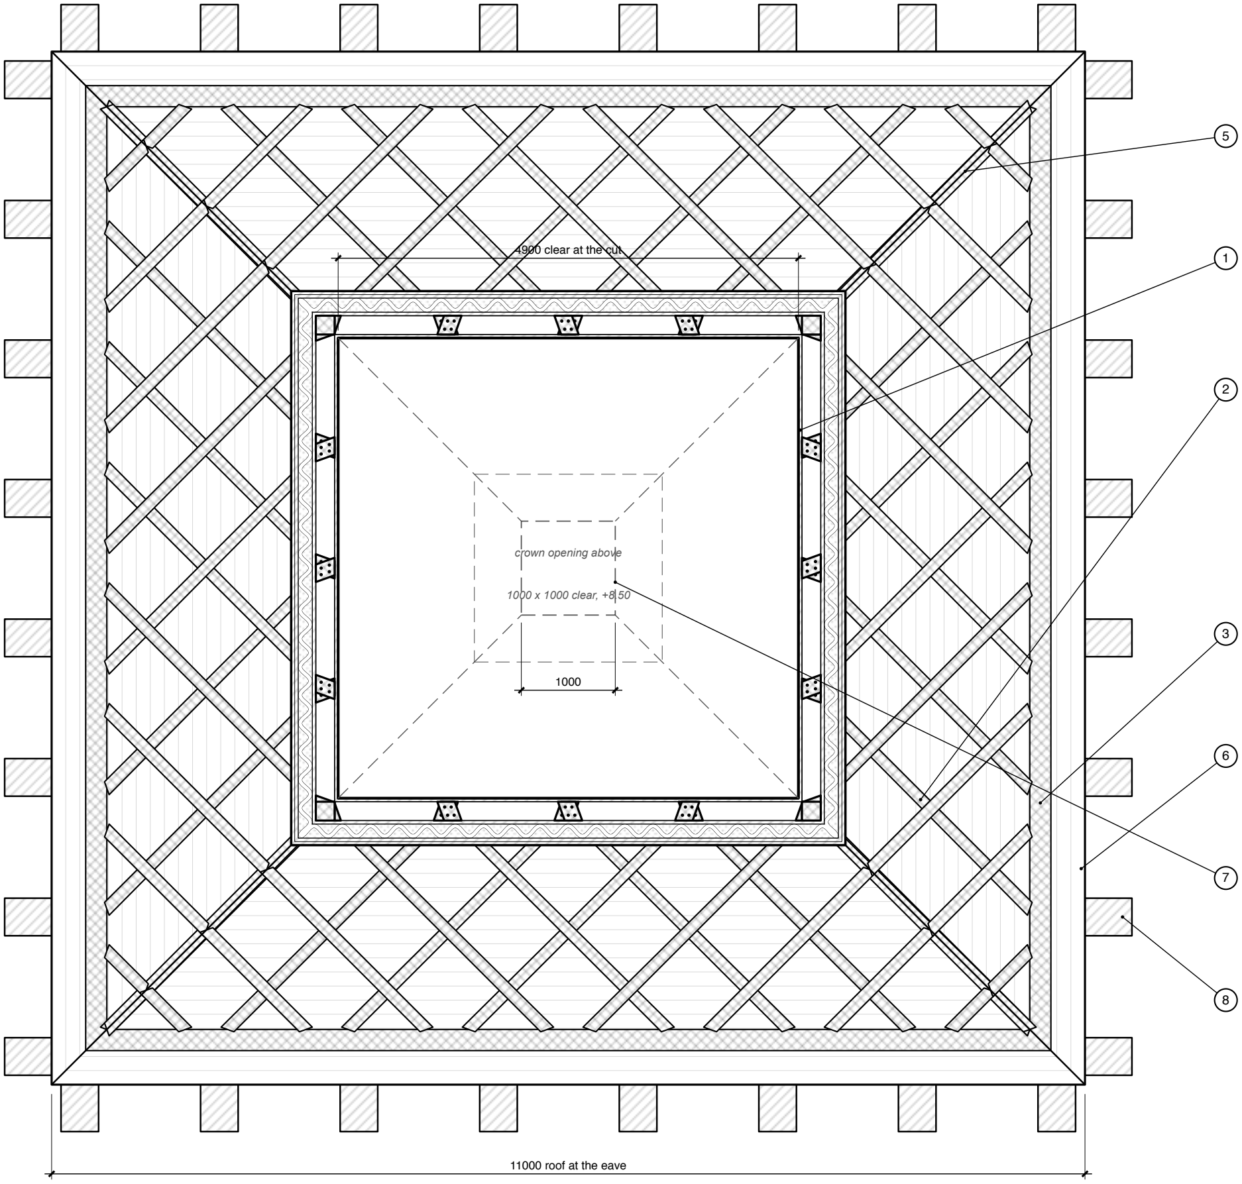
[picture p133: figure]
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
e, j

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
al rib

a

t

+

6.0

2

), r

o

o

m

sid

e

o

u

t: in

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
0, rib

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
h; e

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
), mid

dle

b

e

a

d

3

0, lattice zone 120 (wavy bead + insulation, dotted), 2 outer beads 30 (exposed concrete). 2 | Ribs of grid B seen below the cut: the two families of diagonals from the base ring at the eave up to the cut and the hips. 3 | Base ring: the 300 solid base at the eave (+2.50 to +2.80). 4 | No horizontal ribs in grid B between the base ring and the top ring. 5 | Hips: ribs from the corners of the eave up to the cut; dashed above it, up to the crown opening. 6 | Roof edge at the eave (outer face of the outer beads). Very faint squares = printed layer joints (real layers 10, drawn every 200 in height). 7 | Above the cut (removed, dashed): hips and the crow

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
0, 1

0

0

0

cle

a

r in

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
xis, 2

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
). 8 Buttresses below the roof: their ends s

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
e; t

h

e

w

all u

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
f is

d

a

s

h

e

d. Notes Matches the roof-grid elevations: same rib geometry, s

a

m

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

4
m

7

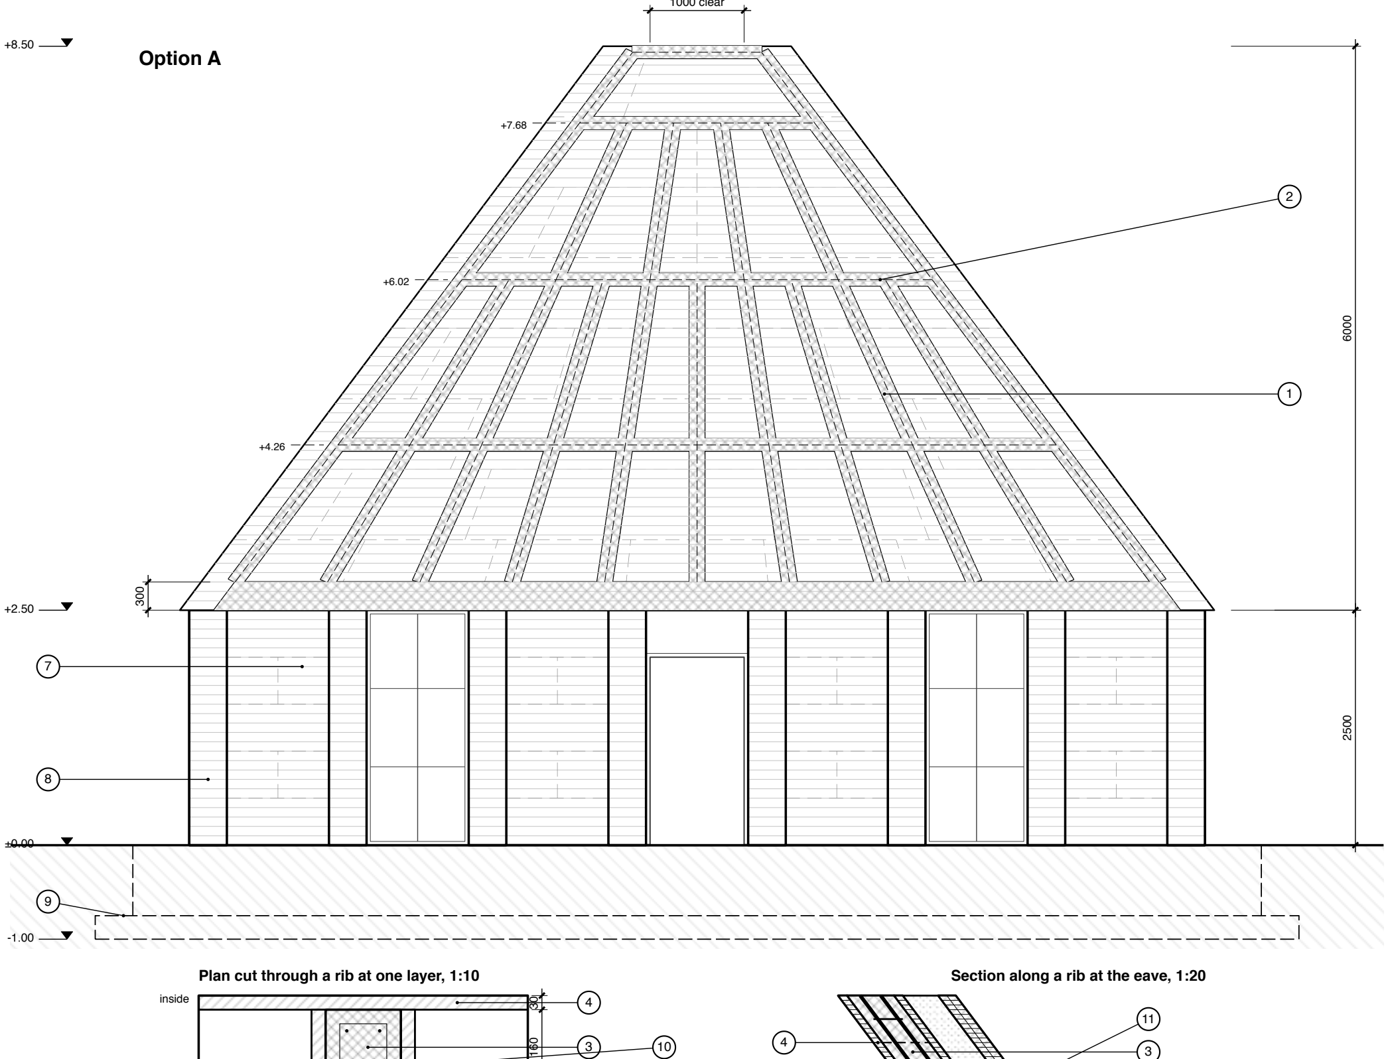
[picture p134: figure]
sid; e inside

1365
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
n in

s

t

r

aig

h

t lin

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
e, s

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
e lik

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
h. 2 When the spacing drops to 500 (about +6.02 )

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
s; a

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
g. 3 Rib (column) 160 wide x 160 dee p in

t

h

e

rib

z

o

n

e, between the inner and the middle bead: the printe d
c

h

a

n

n

el s

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
k, fille

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
e; 4

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
), or fibre concrete (see notes). 4 | Inner bead 30: continuous, covers the grid on the room side. 5 | 2 outer beads 30: continuous, the outside of the printed shell, exposed concrete (no insulation or cladding outside). 6 | Lattice zone 120: wavy printed bead 30 touching the middle and the outer beads in turn, insulation between (dotted). 7 | Printed wall 400, to +2.50: inner bead 30, lattice zone 310 (wavy bead + insulation), 2 outer beads 30. 8 | Buttresses 400 wide, 1000 from the inner face (600 outside), about every 1.5 m (7 bays of 1486 on the wall centreline, 8 per side, corners included); every other bay is printed wall, the bays between are full-height curtain wall (door in the middle one). 9 | Strip footing 1800 x 250, underside at -1.00 (hidden, dashed): printed edge formwork, cast core. 10 Printed channel walls 30 each side of the rib, from the inner to the middle bead: permanent formwork. Between the ribs the rib zone is an empty cavity. 11 Poured core: the solid base (300, full concrete over the whole 400) and the rib in one pour, lifts of about 600 from the eave (assumed, dashed), no joint between base and rib. Printed layer joints every 10 (drawn every 20). 12 Middle bead 30: closes the rib zone outside; inner and middle bead are the structural skins, the ribs the webs (as in the Karamba model). Notes Columns stop on a horizontal rib (at 3517 and 5183 above the eave); bars are lapped / hooked into it. Horizontal ribs at 1758, 3517, 5183, plus the 300 solid base (bottom ring) and the top ring at the crown. Dashed lines = printed pieces in running bond (about 1500 x 750); very faint lines = printed layer joints (10 mm layers, drawn every 100). Printed mortar beads are permanent formwork; ribs, base and buttress cores are poured concrete (after the Obayas
hi 3dpod paper, 2023). Steel-fibre concrete could replace the rib bars, to be confirmed by the engineer. Rough quantities, four faces: ribs 318 m, steel 2005 kg (4 Ø16 per rib), poured concrete 8.1 m3. 0 | 1 | 2 | 3

4
m

3 · rib

pla

0, rib

tio

8

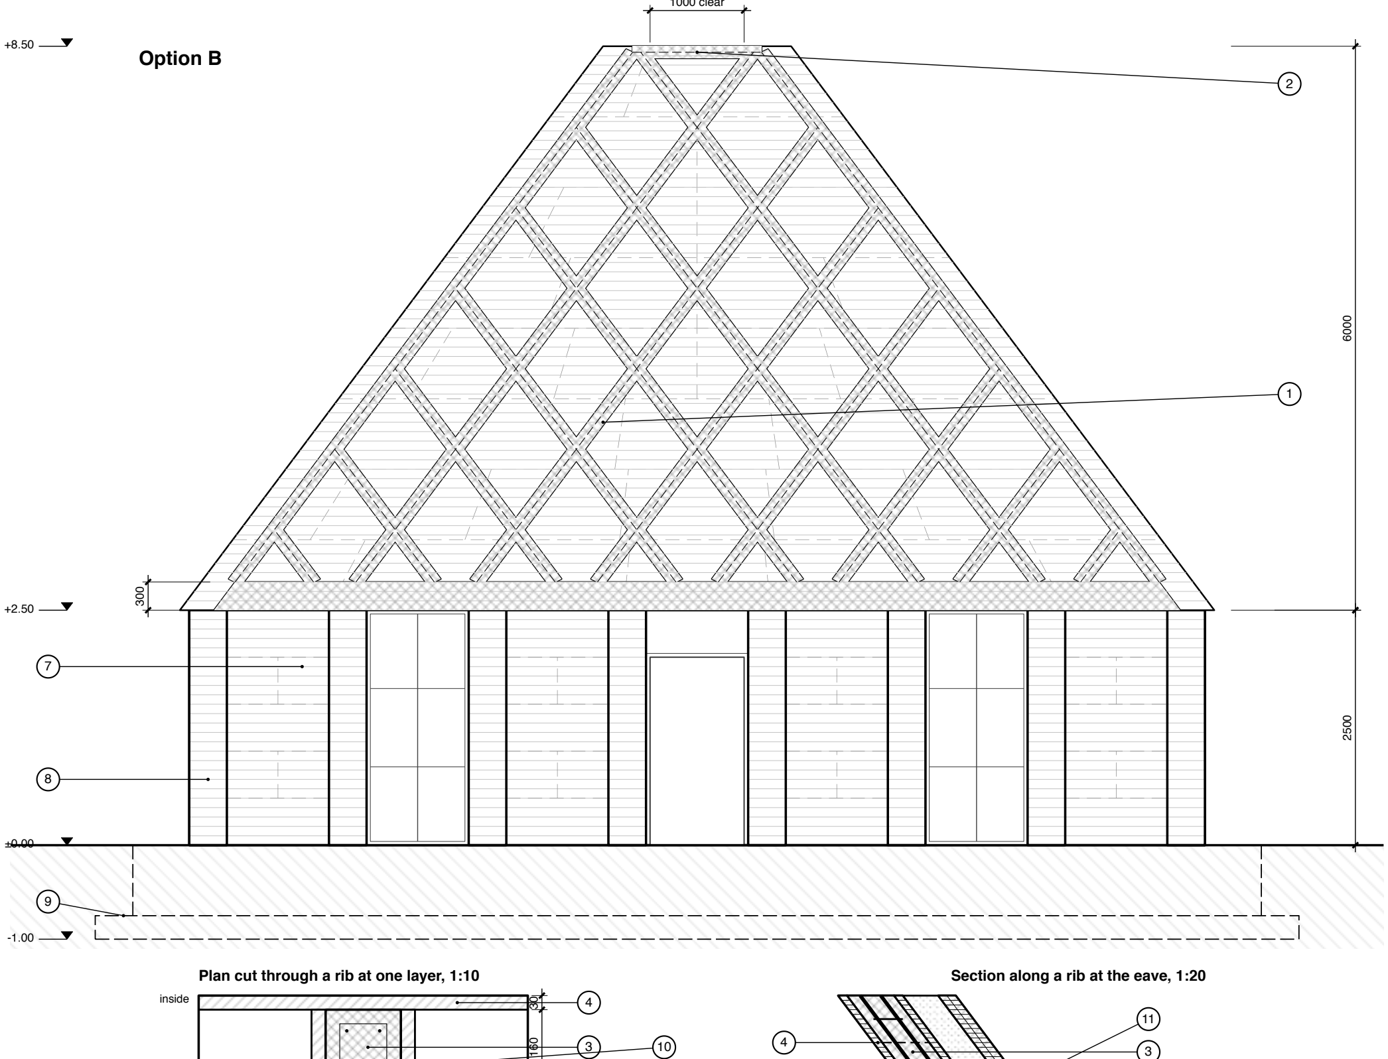
[picture p135: figure]

1365
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
allel t

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
e in

clin

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
s, 5

9.0

° in

t

h

e

f

a

c

e

), e

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
e: e

q

u

al dia

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
e. 2 Bottom ring = the 300 solid base; top ring at t

h

e
c

r

o

w

n. T

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
als. N

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
al rib

s. 3 Rib (column) 1
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
p in

t

h

e

rib

z

o

n

e, between the inner and the middle bead: the printe d
c

h

a

n

n

el s

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
k, fille

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
e; 4

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
), or fibre concrete (see notes). 4 | Inner bead 30: continuous, covers the grid on the room side. 5 | 2 outer beads 30: continuous, the outside of the printed shell, exposed concrete (no insulation or cladding outside). 6 | Lattice zone 120: wavy printed bead 30 touching the middle and the outer beads in turn, insulation between (dotted). 7 | Printed wall 400, to +2.50: inner bead 30, lattice zone 310 (wavy bead + insulation), 2 outer beads 30. 8 | Buttresses 400 wide, 1000 from the inner face (600 outside), about every 1.5 m (7 bays of 1486 on the wall centreline, 8 per side, corners included); every other bay is printed wall, the bays between are full-height curtain wall (door in the middle one). 9 | Strip footing 1800 x 250, underside at -1.00 (hidden, dashed): printed edge formwork, cast core. 10 Printed channel walls 30 each side of the rib, from the inner to the middle bead: permanent formwork. Between the ribs the rib zone is an empty cavity. 11 Poured core: the solid base (300, full concrete over the whole 400) and the rib in one pour, lifts of about 600 from the eave (assumed, dashed), no joint between base and rib. Printed layer joints every 10 (drawn every 20). 12 Middle bead 30: closes the rib zone outside; inner and middle bead are the structural skins, the ribs the webs (as in the Karamba model). Notes Every diagonal ends on a ring or on a hip, so no bar has a free end in the shell. Diagonals do not stop as the roof narrows: the diamonds just get clipped by the hips. Dashed lines = printed pieces in running bond (about 1500 x 750); very faint lines = printed layer joints (10 mm layers, drawn every 100). Printed mortar beads are permanent formwork; ribs, base and buttress cores are poured concrete (after the Obayas
hi 3dpod paper, 2023). Steel-fibre concrete could replace the rib bars, to be confirmed by the engineer. Rough quantities, four faces: ribs 326 m, steel 2055 kg (4 Ø16 per rib), poured concrete 8.3 m3. 0 | 1 | 2 | 3

4
m

3 · rib

pla

0, rib

tio

9

1

:

,

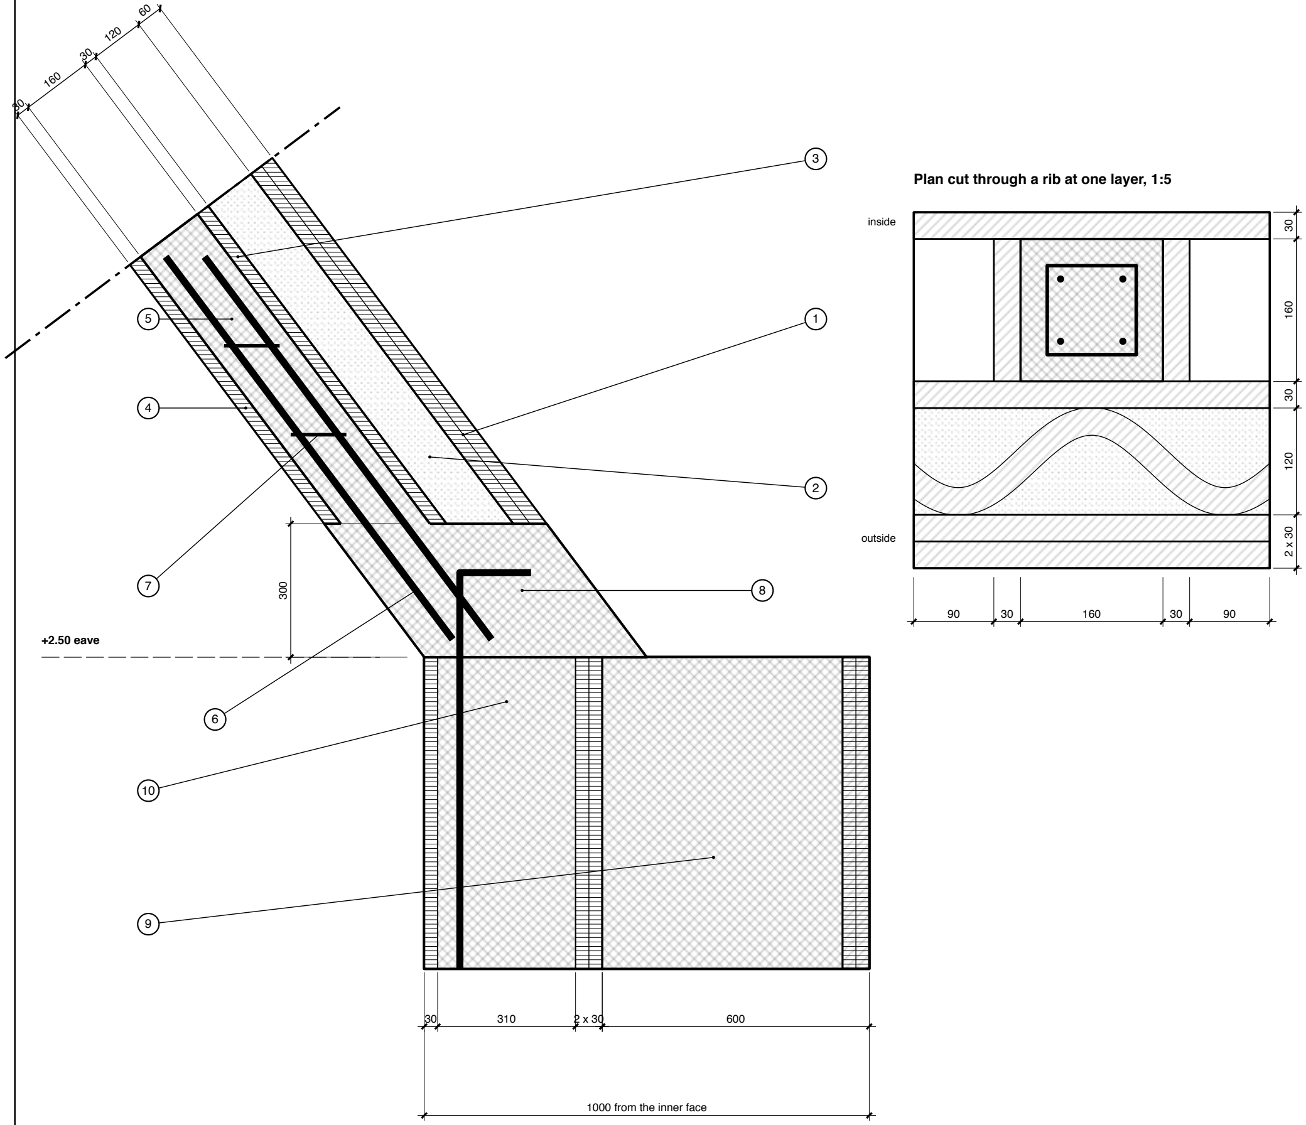
[picture p136: figure]
sid; e inside

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
0, t

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
e: exposed concrete, no insulation or cladding outsid e
(

t

h

e in

s

ula

tio

n is in

t

h

e la

t

tic

e

z

o

n

e

). 2 Lattice zone 120: a wavy printed bea d

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
s in

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
0, a

s

s

u

m

e

d

), in

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
n it

s loops (dotted). 3 | Middle bead 30: closes the rib zone on the outside. Inner and middle bead are the two structural skins of the roof, the ribs the webs between them (as in the Karamba model). 4 | Inner bead 30, room side: continuous, it covers the ribs. The roof is 400 thick square to the slope from eave to crown. 5 | Rib (cast column) 160 wide x 160 deep: fills the rib zone between the inner and the middle bead, inside two printed channel walls of 30 (see the plan cut), filled with poured concrete; section cut along the rib. It rises out of the solid base in the same pour, without a joint. Between the ribs the rib zone is an empty cavity. 6 | Rib bars R, 4 Ø16 (2 in the cut), anchored in the solid base where they cross the hooks of the wall bars A (assumed; steel fibre in the concrete could replace them). 7 | Stirrups Ø8 every 200 (assumed). 8 | Solid base of the roof: the first 300 (vertical) above the eave is full cast concrete over the whole 400, no cavity or lattice, poured in one go with the rib above it; wall bars A hook into it. Replaces the ring beam. 9 | Buttress 400 wide, 1000 from the inner face (600 beyond the wall): printed formwork (60 end cap of 2 beads shown) filled with cast concrete; top flush with the roof base at +2.50. 10 Wall 400 at the buttress: printed inner bead 30 and 2 outer beads 30, the 310 zone between them cast a

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
o in

s

ula

tio

n

h

e

r

e, t

h

e
c

u

t is

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
s; b

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
e is

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
+ in

s

ula

tio

n

). W

all b

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
n in

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
p in

t

o

t

h

e
s

olid

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
d in

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
). T

h

e

r

o

o

f
g

rid is

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
); t

h

e
d

e

t

ail is

c

u

t

alo

n

g

a

rib. 0 | 1 | 2 | 3

4
d

m

3 · rib

pla

1:5 · dim

1
