gonzalocrs/Amor_Mundi/(commit log)

2026-10-07 Add rebar, print paths, printability check and piece picker
    - Rebar: two rows of bars up each face; zig-zag loops around a printed hole at every bar;
    piece joints moved between bars; bars stop where the roof gets too thin or meets a corner
    - Print paths per layer (walls + zig-zag), bead preview as one mesh per piece
    - Printability check (layer time, sharp corners, short segments) and `piece` input
    - Corner pieces measured on the room-side face; zig-zag only where it fits
    - Lap removed by default (flat bed joints); `lap` input brings it back
2026-10-11 Add 1:10 eave construction section (printed pieces, filled lattice) and its generator
    Draft 4 of the roof-to-wall detail for Ishigaki: 24 cm reinforced inner leaf
    tapering to 8 cm at the top of the 8 m roof, 15 cm printed zig-zag lattice with
    filled cells, 8 cm outer skin, ring beam, printed drip nose. Includes a 1:20
    plan of one piece and a 1:100 sketch of the whole roof.
    Claude-Session: https://claude.ai/code/session_01HFKh1rBGKW1PZQWbFVpfve
2026-10-12 Add floor plan, total section and eave detail for the buttressed 10x10 pyramid roof
    Standalone generator (details/pyramid_drawings.py) with SVG and A3 PDF output:
    400 printed wall and roof (80+80 layers, 160 air zone, 80 outer), 500 ring beam
    embedded in the buttress, buttresses 700 from the inner face, openings per bay.
2026-10-12 Detail D1: show 10 mm printed layers in the wall and roof
    Claude-Session: https://claude.ai/code/session_01MXfZ76qmw6Gu54k66e46jk
2026-10-12 Add screening structural check: roof thrust, ring beam, wall, buttress, wind, footing
    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
2026-10-12 Add DXF (CAD) versions of plan, total section and eave detail, generated from the same geometry
    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
    [pyramid-detail.dxf, pyramid-plan.dxf, pyramid-section.dxf]
2026-10-12 Remove the older eave section draft; Gonzalo's detail D1 is the current eave detail
    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
2026-10-12 Detail D1: update legend text, add second roof-piece plan (layer 2 straight, pocket in a bulge of layer 1)
    Claude-Session: https://claude.ai/code/session_01CzrMebgyePSnpaytyCokBV
    [pyramid-detail.dxf]
2026-10-14 Buttress 1000 long, remove ring beam, first 300 of the roof solid concrete; regenerate drawings, update checks
    Claude-Session: https://claude.ai/code/session_01G5BQuMro8ELKJJ1QwiVeHb
    [pyramid-detail.dxf, pyramid-plan.dxf, pyramid-section.dxf]
2026-10-14 Roof rise 6000 (53.1 deg, 36.9 from vertical); remove ROOM, door and window tags from the section; regenerate drawings
    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
    [pyramid-detail.dxf, pyramid-plan.dxf, pyramid-section.dxf]
2026-10-14 Roof-grid sheets: show wall, buttresses, ground and footing; grid on the shell mid-surface
    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
2026-10-14 Show 3D-printed construction: printed formwork with cast cores (section, D1, roof-grid sheets); informed by the Obayashi 3dpod paper
    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
    [pyramid-detail.dxf, pyramid-plan.dxf, pyramid-section.dxf]
2026-10-14 Roof-grid sheets: thin printed layer lines on the shell and walls; rib plan cut with printed beads and poured core; new section along a rib with poured lifts
    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
    [pyramid-detail.dxf, pyramid-plan.dxf, pyramid-section.dxf]
2026-10-14 Roof-grid sheets: white background, very faint printed layer lines, dashed piece divisions (running bond)
    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
2026-10-14 Roof-grid sheets: continuous 400 buttress strips (no divider at the corners), printed wall pattern in every other bay
    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
2026-10-14 Full section A-A rebuilt for roof grid A and B: buttress every 1.5 m, 100 insulation + outer layer, rib grid on the back face, printed pattern; plan and D1 updated to match
    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
    [pyramid-detail.dxf, pyramid-plan.dxf, pyramid-section-gridA.dxf, pyramid-section-gridB.dxf, pyramid-section.dxf]
2026-10-14 Section A-A: restore the earlier look of wall, buttress, footing, solid base and back wall; keep insulation/outer layer, grid ribs and new openings
    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
    [pyramid-detail.dxf, pyramid-plan.dxf, pyramid-section-gridA.dxf, pyramid-section-gridB.dxf, pyramid-section.dxf]
2026-10-14 Section A-A: draw the lower ring (solid base) on the back roof face so the ribs no longer hang
    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
    [pyramid-detail.dxf, pyramid-plan.dxf, pyramid-section-gridA.dxf, pyramid-section-gridB.dxf, pyramid-section.dxf]
2026-10-14 Floor plan (base, grid A, grid B) and detail D1 updated: rib channel replaces the rebar pockets, plan cut through a rib, insulation outline and symbols much thinner than structural lines everywhere
    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
    [pyramid-detail.dxf, pyramid-plan-gridA.dxf, pyramid-plan-gridB.dxf, pyramid-plan.dxf, pyramid-section-gridA.dxf, pyramid-section-gridB.dxf, pyramid-section.dxf]
2026-10-14 D1 and rib long section: bottom 300 is full concrete over the whole 400, one pour with the rib, like section A-A
    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
    [pyramid-detail.dxf, pyramid-plan-gridA.dxf, pyramid-plan-gridB.dxf, pyramid-plan.dxf, pyramid-section-gridA.dxf, pyramid-section-gridB.dxf, pyramid-section.dxf]
2026-10-14 D1: inclined dimension chain shows true layer thicknesses (80 | 240 rib core | 80 | 100 insulation | 30 cladding); D1 layers at the eave thicknesses
    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
    [pyramid-detail.dxf, pyramid-plan-gridA.dxf, pyramid-plan-gridB.dxf, pyramid-plan.dxf, pyramid-section-gridA.dxf, pyramid-section-gridB.dxf, pyramid-section.dxf]
2026-10-14 Section A-A background wall follows the floor plan: buttress strips every ~1.5 m, printed bays and openings in the plan rhythm
    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
    [pyramid-detail.dxf, pyramid-plan-gridA.dxf, pyramid-plan-gridB.dxf, pyramid-plan.dxf, pyramid-section-gridA.dxf, pyramid-section-gridB.dxf, pyramid-section.dxf]
2026-10-14 Printed-wall bays drawn like the roof-grid sheets in the section; window bays are full curtain wall (plan, section, roof-grid sheets); no insulation in the wall at the buttress cut (section, D1)
    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
    [pyramid-detail.dxf, pyramid-plan-gridA.dxf, pyramid-plan-gridB.dxf, pyramid-plan.dxf, pyramid-section-gridA.dxf, pyramid-section-gridB.dxf, pyramid-section.dxf]
2026-10-14 Add roof plan slices (cut ring with the cast ribs) for grid A and grid B
    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
2026-10-14 Roof slices: main cut raised to +5.90, just below the middle ring of grid A
    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
2026-10-14 Roof slices: main cut at +6.00
    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
2026-10-14 Roof slices: main cut at +8.50 from the ground floor (crown, through the top ring) at 1:20; small slices at +4.00 and +7.00
    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
2026-10-14 Roof slices: main cut back at +6.00 where all the ribs show; small slices at +4.00 and +7.50
    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
2026-10-14 Roof plan cut at +8.50 through the top ring, looking down on the ribs from the eave to the crown (grid A and B)
    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
2026-10-14 Roof plan cut at +6.00 (just below the +6.13 ring) looking down on the ribs from the eave; crown opening dimensioned 1000 clear on every sheet
    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
2026-10-14 Drawing set: 10 tidied A3 sheets as PDFs (and one merged set) plus editable DXFs with an A3 paper layout at scale and real DIMENSION entities; legends without assumption tags
    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
    [01-floor-plan.dxf, 02-floor-plan-grid-A.dxf, 03-floor-plan-grid-B.dxf, 04-section-AA-grid-A.dxf, 05-section-AA-grid-B.dxf, 06-roof-plan-cut-grid-A.dxf, 07-roof-plan-cut-grid-B.dxf, 08-roof-grid-A-elevation.dxf]
2026-10-14 Move outdated drawings (old per-drawing PDF/SVG/DXF, 11x17 D1, D1 DWG, first eave section) to archive/
    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
    [pyramid-detail.dwg, pyramid-detail.dxf, pyramid-plan-gridA.dxf, pyramid-plan-gridB.dxf, pyramid-plan.dxf, pyramid-section-gridA.dxf, pyramid-section-gridB.dxf, pyramid-section.dxf]
2026-10-14 Karamba model: grid A and grid B ribs as beams, 32 buttresses as drawn
    - grid input: A (ruled-surface columns, sheet 08), B (diamond lattice, sheet 09) or none (plain shell)
    - roof mesh follows the ribs so every rib is a chain of beams on shell nodes; rib_lines + rib_ids outputs
    - buttresses on the floor-plan axes, 8 per side about 1486 apart, instead of one per side at mid-span
    - ring beam split at every wall and roof node; crown ring snapped to the mesh so all variants share one geometry
    - geometry inputs (clear, wall_h, rise, opening, but_spacing); connectivity check when run outside Rhino
    Claude-Session: https://claude.ai/code/sess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
2026-10-14 Whole drawing set in one DXF (one layout per sheet); all CAD text in Arial; Karamba Grasshopper file
    - details/set/cad/pyramid-roof-drawing-set.dxf: the 10 sheets side by side in model space, one A3 layout each
    - CAD text style Standard = arial.ttf (was txt.shx, plus OpenSans styles CAD had to substitute); per-entity linetype scale, one dimension style per sheet scale
    - grasshopper/Pyramide Karamba 10_14_2026.gh: Karamba model definition
    - .gitignore: keep license files out of the repo
    [01-floor-plan.dxf, 02-floor-plan-grid-A.dxf, 03-floor-plan-grid-B.dxf, 04-section-AA-grid-A.dxf, 05-section-AA-grid-B.dxf, 06-roof-plan-cut-grid-A.dxf, 07-roof-plan-cut-grid-B.dxf, 08-roof-grid-A-elevation.dxf]
2026-10-15 Karamba analysis guide: new-PC setup, missing component outputs, materials, sections, loads, results to read
2026-10-15 Karamba guide: component-by-component wiring with ribbon groups, drop-downs, inputs and units (Karamba 3.1)
2026-10-15 Drawing set: 30 mm bead build-up as in the Karamba model
    Roof (400, constant eave to crown): inner bead 30 | rib zone 160 (cavity
    crossed by the 160 x 160 cast ribs) | middle bead 30 | lattice 120 (wavy
    bead + insulation) | 2 outer beads 30. Walls: inner bead 30 | lattice 310
    | 2 outer beads 30. Parameters BEAD, OUTER_BEADS, LATTICE, FILL, RIB_W,
    RIB_D replace T_LEAF0/T_LEAF1/T_LAT/T_SKIN; the rib grid now lies on the
    rib-zone centre (the Karamba shell surface), so the grid A levels are
    +4.26 / +6.02 / +7.68 and the roof cut moves to +5.90.
    Plan, sections, roof cuts, grid sheets (plan cut + rib section) and
    detail D1 redrawn; unused 80 mm piece plans removed. make_set.py prints
    the PDFs wit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
    [01-floor-plan.dxf, 02-floor-plan-grid-A.dxf, 03-floor-plan-grid-B.dxf, 04-section-AA-grid-A.dxf, 05-section-AA-grid-B.dxf, 06-roof-plan-cut-grid-A.dxf, 07-roof-plan-cut-grid-B.dxf, 08-roof-grid-A-elevation.dxf]
2026-10-15 make_set.py: headless Microsoft Edge first for the PDF fallback (Chrome after it); PDFs regenerated with Edge
    [01-floor-plan.dxf, 02-floor-plan-grid-A.dxf, 03-floor-plan-grid-B.dxf, 04-section-AA-grid-A.dxf, 05-section-AA-grid-B.dxf, 06-roof-plan-cut-grid-A.dxf, 07-roof-plan-cut-grid-B.dxf, 08-roof-grid-A-elevation.dxf]
2026-10-15 Drawing set: no insulation or cladding outside the printed shell
    The insulation is in the lattice zones and the outer beads are exposed
    concrete, so the outside 100 insulation and 30 cladding are dropped from
    the plan, sections, roof cuts, grid sheets and detail D1, with their
    legend items and callouts (legends renumbered). The merged set PDF was
    locked by a viewer and is not rebuilt in this commit.
    [01-floor-plan.dxf, 02-floor-plan-grid-A.dxf, 03-floor-plan-grid-B.dxf, 04-section-AA-grid-A.dxf, 05-section-AA-grid-B.dxf, 06-roof-plan-cut-grid-A.dxf, 07-roof-plan-cut-grid-B.dxf, 08-roof-grid-A-elevation.dxf]
2026-10-15 Rebuild the merged set PDF (and the regenerated sheets) without the outside insulation and cladding
    [01-floor-plan.dxf, 02-floor-plan-grid-A.dxf, 03-floor-plan-grid-B.dxf, 04-section-AA-grid-A.dxf, 05-section-AA-grid-B.dxf, 06-roof-plan-cut-grid-A.dxf, 07-roof-plan-cut-grid-B.dxf, 08-roof-grid-A-elevation.dxf]
2026-10-15 Drawing sets in one numbered folder per version
    make_set.py now writes every run to a new folder details/set/VV_date_label
    (label from the command line) instead of overwriting the last set. The
    existing sets are kept as 01_80mm-layers (from gonzalo), 02_30mm-beads
    (with the outside insulation) and 03_no-outside-insulation (current).
    [01-floor-plan.dxf, 02-floor-plan-grid-A.dxf, 03-floor-plan-grid-B.dxf, 04-section-AA-grid-A.dxf, 05-section-AA-grid-B.dxf, 06-roof-plan-cut-grid-A.dxf, 07-roof-plan-cut-grid-B.dxf, 08-roof-grid-A-elevation.dxf]
2026-10-15 Compress the Edge-printed PDFs (85 MB merged set -> a few MB)
    Edge writes the drawing streams uncompressed; make_set.py now deflates them
    with pypdf after printing. Sets 02 and 03 recompressed in place (pages
    render identically) and their merged PDFs rebuilt.
2026-10-15 Karamba model: 30 mm bead build-up, analysis toggles and footing; Grasshopper file and step-by-step guide
    - karamba_model.py: printed build-up driven by bead / outer_beads / lattice / fill (default 1 outer bead, no
    cladding load), the two skins as an equivalent shell (t_roof, E_roof, G_roof, fc_roof, gamma_roof and the wall
    set as outputs); toggles walls, ring, but_on_ribs, but_cap (buttress caps cast into the ring), roof_only,
    skin_check; ring_w; footing (strip on the wall line + a footing beam under each buttress, foot_w / foot_h /
    foot_ext, supports under it). Connectivity checked for every combination.
    - Pyramide Karamba 10_14_2026.gh: Gonzalo's Karamba definition (materials, sec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
2026-10-17 Karamba footing: foot_in (reach under the room) and foot_strip (pads only) for the case-B pad
2026-10-17 Karamba: ring test, free horizontal ring heights, caps and footing wired
    - ring_test: roof + ring on sliding bearings with mid-side pins (sup_x, sup_y) to check the ring closes the push
    - hring_z: horizontal rib rings at chosen heights (list), 0 = none; secondary columns run up to the highest ring
    - cols_full what-if; centroid height in info; min_pitch warning at the top ring
    - Grasshopper file: rib_ids, cap_lines and footing beams wired; guide section 10d
2026-10-18 Karamba: buttress seat option, no_corner, Japanese load cases noted
    - but_cap False is now a seat: ring tied to the buttress top only over its own width (ring_w)
    - no_corner removes corner buttresses (1-4) with their footing pads and ring-test bearings
    - info fixes for buttress counts; guide 10d: seat, no_corner, LONG/SHORT combos and Ishigaki qp
    - Grasshopper file: Japanese LONG/SHORT combinations, qp input, display chains
2026-10-18 Rib pieces: printed formwork with channels for the Karamba rib grid
    Courses square to the slope (pieces print upright), column channels inside the
    pieces, rings and crown ring as troughs at course tops, hip channels across the
    mitre. One continuous print path per layer, printability check, Revit-ready
    solids for the pieces and the cast ribs. Guide in grasshopper/rib-pieces-guide.md.
2026-10-30 PolyFrame 2 roof iterations, outer branch pyramid, print models and scripts
    - polyframe2/: friend's roof variants #1-#16 (.gh + .png), #15 outer
    pyramid steps (skin, branches, cut, eaves, supported, struts, flat
    corners, at base), review sets v1-v5, combined 3dm files
    (all models, clean, all iterations clean), 1:50 / 1:100 STL prints
    - polyframe2/scripts/: Rhino MCP C# / Python scripts used to build them
    - form-finding/, Revit/Karamba session files left in the working tree
    [10.20.26 Karamba_structure.3dm, branching-variants.3dm, friend-15-1to100.stl, friend-15-1to50.stl, friend-all-iterations-clean-2026-10-29.3dm, friend-all-models-2026-10-29.3dm, friend-iterations-review-v2.3dm, friend-iterations-review-v3.3dm]
2026-11-02 Precedents: construction with printed pieces, cast ribs and minimal scaffolding
2026-11-04 Revit: revit_structure.py, real solids and beam lines from the Karamba build_model
    - Reads the slider values from the Karamba .gh (no sliders to copy); wired inputs override
    - Shell (full build-up, mitred hips), tapered ribs, buttresses, footing as DirectShape solids
    - Ring beam, buttress caps and crown ring as lines for Add Structural Beam
    - Placed on the Module Origin marker's plane (origin input)
    Claude-Session: https://claude.ai/code/session_01M3kbisrtEHKFKTY2sxcyTj
2026-11-04 Revit: wire_up button places and wires the Rhino.Inside components
    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
2026-11-04 Revit: wire_up uses Add DirectShape (Brep), the name in Rhino.Inside 1.35
    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
2026-11-04 Revit: wire_up uses the general Add DirectShape (name, category, geometry)
    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
2026-11-04 Revit: temporary printed-piece cut of the roof shell (joints on the rib centrelines, max 2 x 2 m)
    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
2026-11-04 revit_structure: ring and crown as mitred solids, ring flush with the wall face; rib ends cut level
    Revit beams hung off their lines and didn't meet at the corners. Ribs now sit flat on the ring top
    and stop flat under the crown ring. ring_lines/crown_lines stay as outputs but are empty.
    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
2026-11-05 PolyFrame iterations 2026-11-04/05: Nervi grids, 3 m crowns, gradual branching, 15 x 10 bases, final force diagrams
    - Nervi grids: square/round base, round/square crown, corner supports, 4-corner free-edge version
    - 18/19 and Nervi versions redone with a 3 m crown (crown3m)
    - 18/19 with gradual branching (lines drop by 8 every second ring)
    - 19 and 22 on a 15 x 10 m base (rectangle / oval, oval crowns)
    - *-finalforce.gh: final force diagram via PolyFrame Switch Form Force on the solved form
2026-11-09 Karamba checks of the PolyFrame nets: 19 full model (LONG + typhoon SHORT), one-rib test, comparison with the midterm frame
    - *-karamba.gh: live Karamba group on the solved PolyFrame form (19, 22, 24); casing load only on the sloped faces
    - 19: typhoon group (qp 2.6 kN/m2, cpe as the October model, LCase SHORT)
    - one-rib Karamba test of 19
    - karamba-19/: force images (Nx, Vz, My, Mx; LONG and SHORT), page 05 for 19, comparison page 13 (midterm frame vs net 19)
2026-11-11 Add structural printed casing (thin shell) study: precedents and hand checks vs net 19
    Claude-Session: https://claude.ai/code/session_01V2RYMPukJeZvyETePxVDxi
